KTH-EPE/HVDC_IED/README.md

# HVDC_IED
software and hardware for HVDC IED lab prototype
