KTH-EPE/HVDC_IED/IED_images/power_supply_schematic.pptx

Power
Supply

Green
LED

ADC 1

Switch:
Turn on ADC

ADC 2

DIG OUT
