KTH-EPE/HVDC_IED/IED_images/ADC2_power.jpg

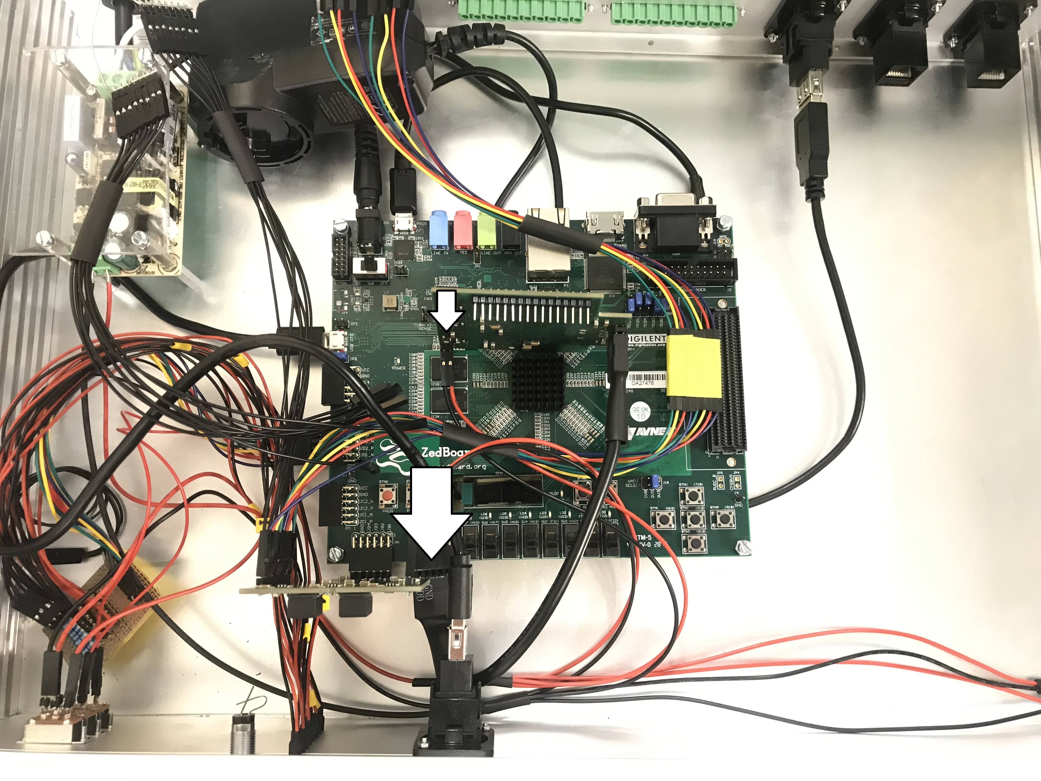
IED_images/ADC2_power.jpg
