KTH-EPE/HVDC_IED/IED_images/ADC_2_wires(1).jpg

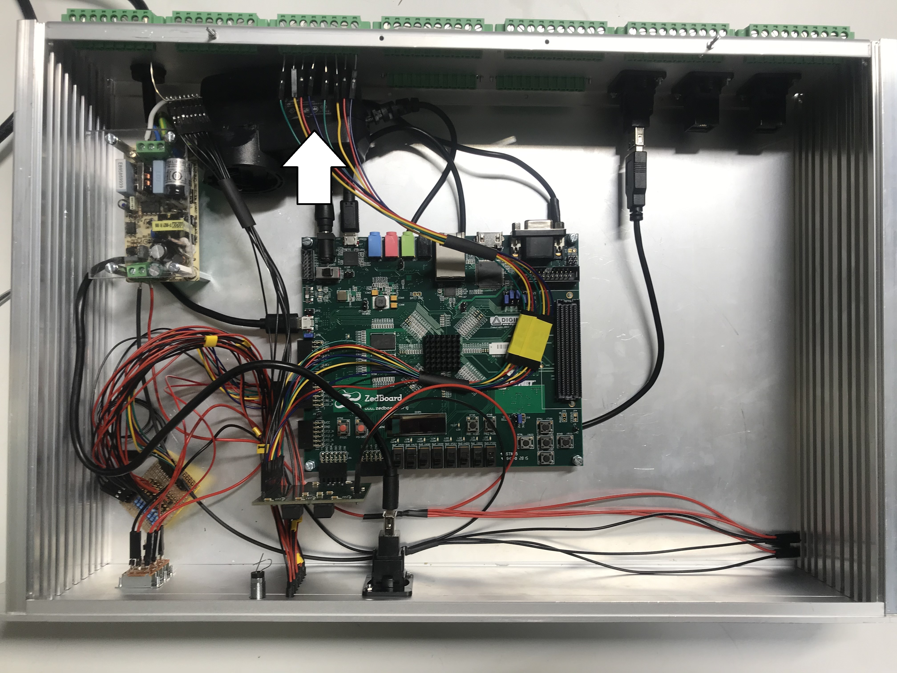
IED_images/ADC_2_wires(1).jpg
