KTH-EPE/HVDC_IED/IED_images/ADC_pins.jpg

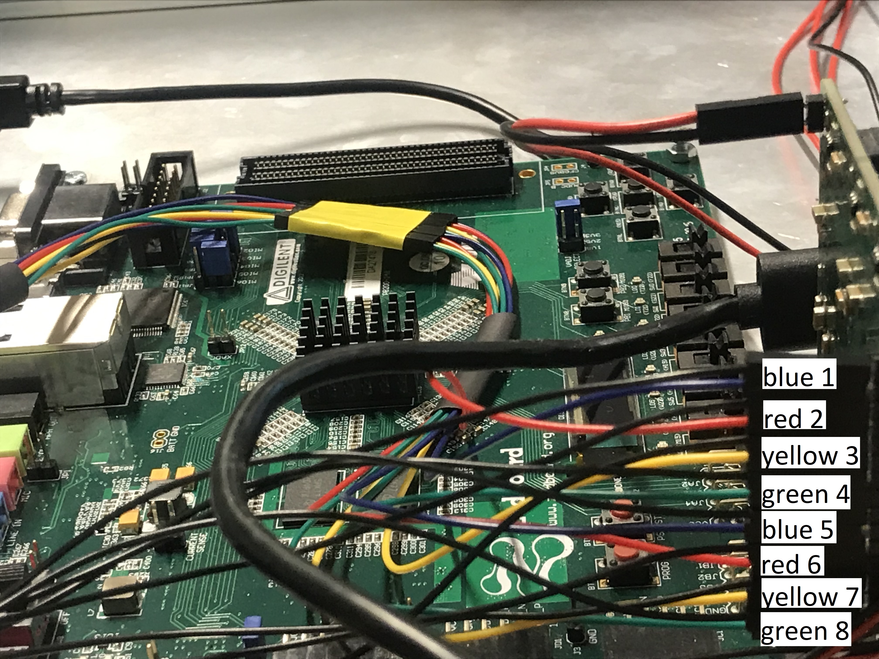
IED_images/ADC_pins.jpg
