KTH-EPE/HVDC_IED/IED_images/DOUT_pins15-28.jpg

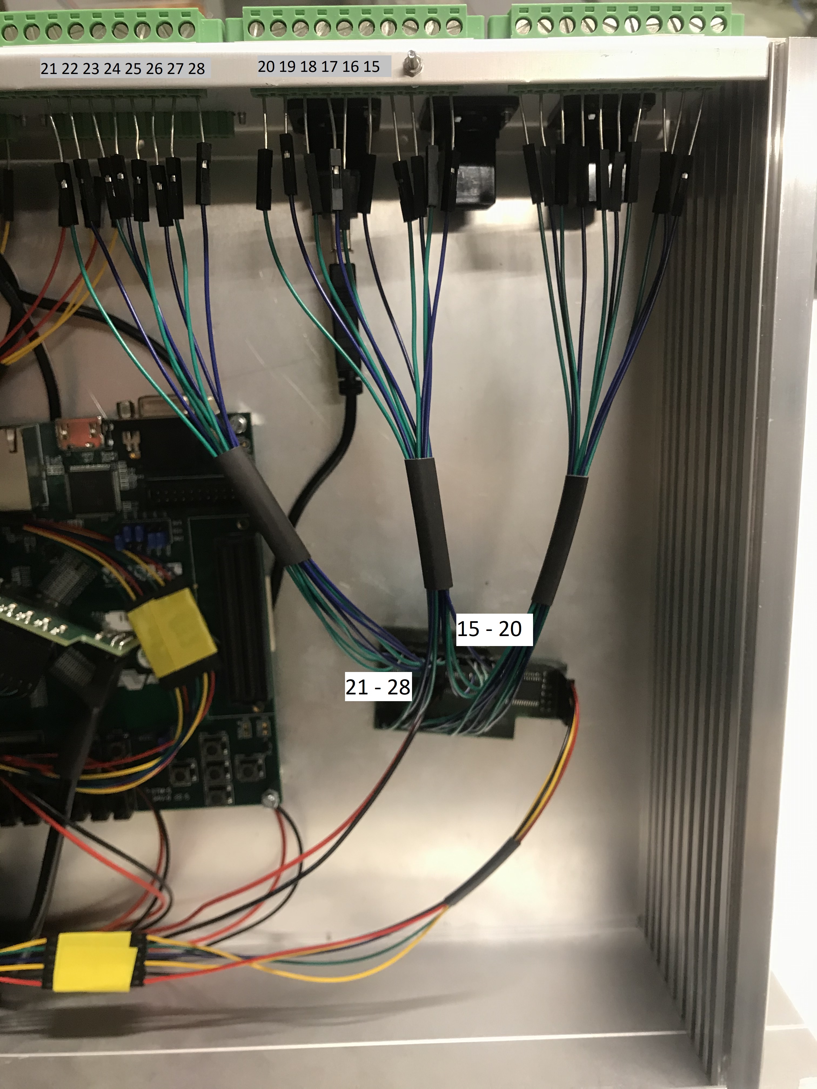
IED_images/DOUT_pins15-28.jpg
