KTH-EPE/HVDC_IED/IED_images/DOUT_supply.jpg

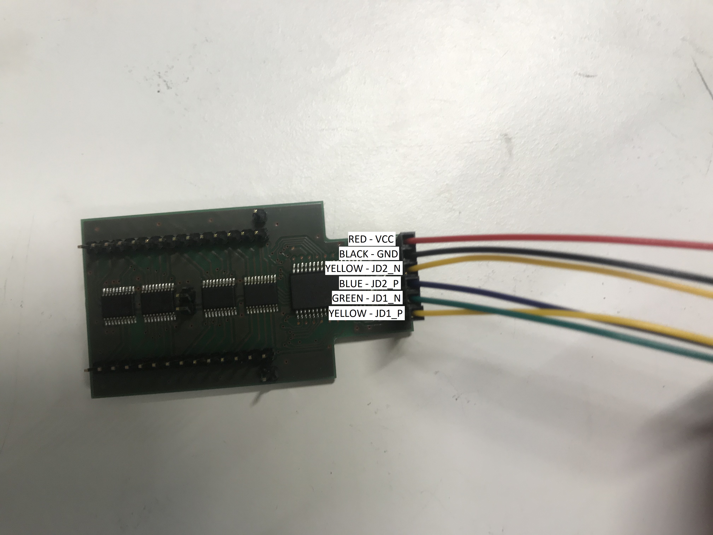
IED_images/DOUT_supply.jpg
