KTH-EPE/HVDC_IED/IED_images/IMG_9938.jpg

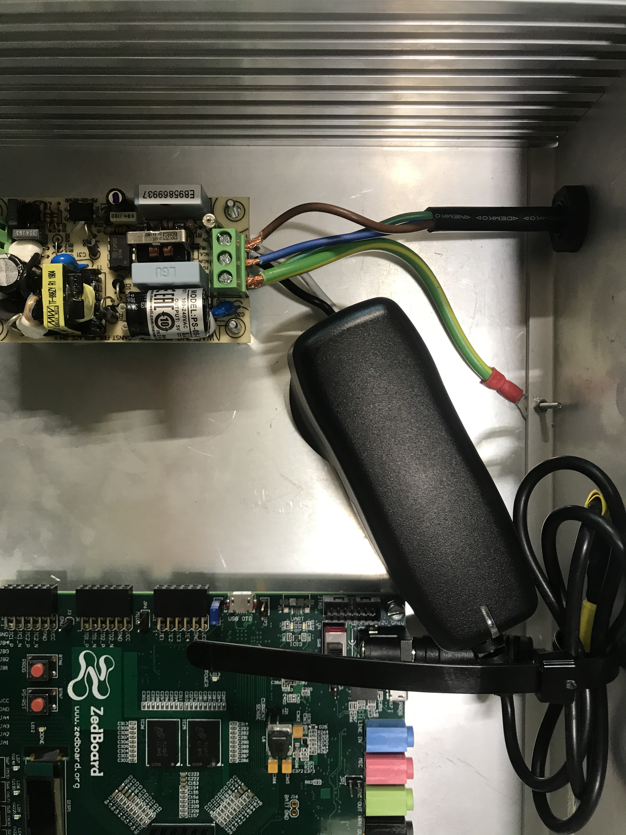
IED_images/IMG_9938.jpg
