KTH-EPE/HVDC_IED/IED_images/LED_GND2.jpg

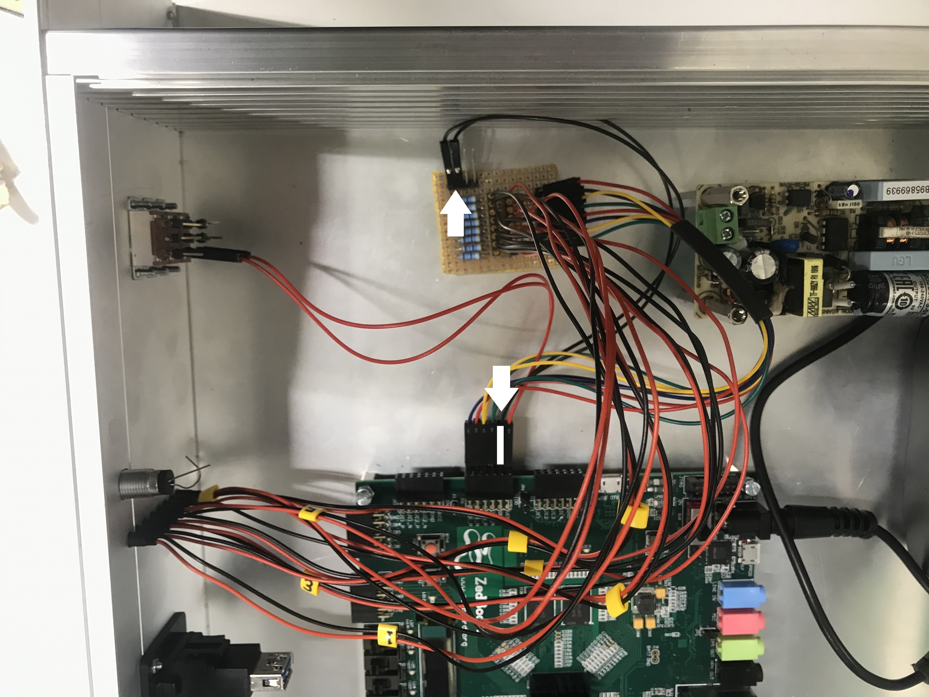
IED_images/LED_GND2.jpg
