KTH-EPE/HVDC_IED/IED_images/LED_GND_idle.jpg

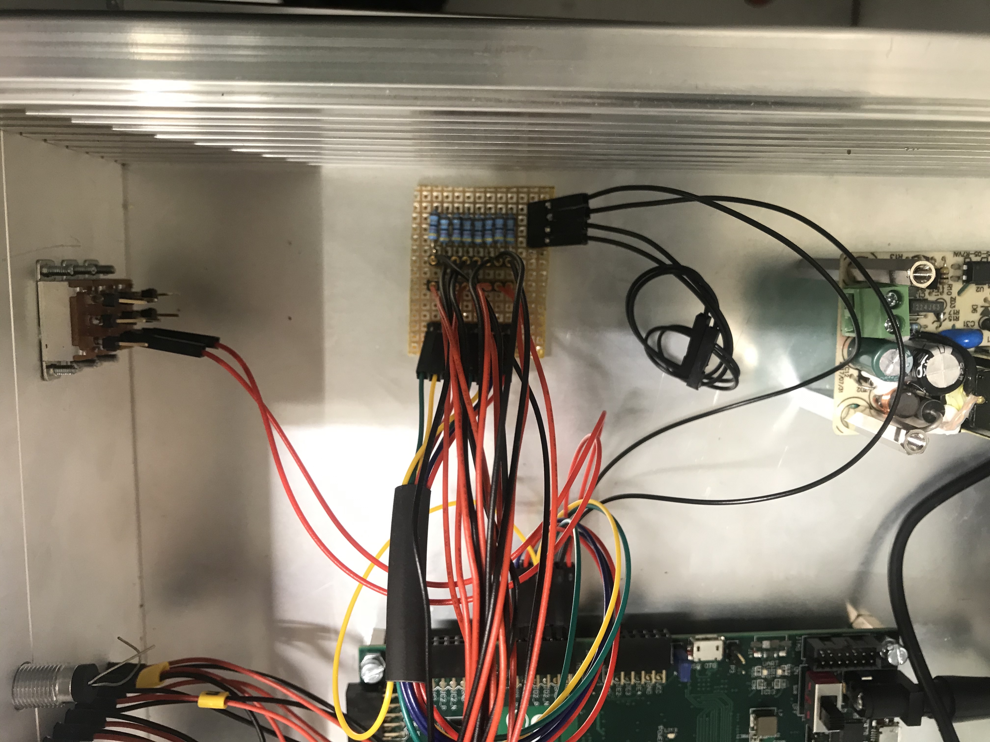
IED_images/LED_GND_idle.jpg
