KTH-EPE/HVDC_IED/IED_images/PMOD_DIN.jpg

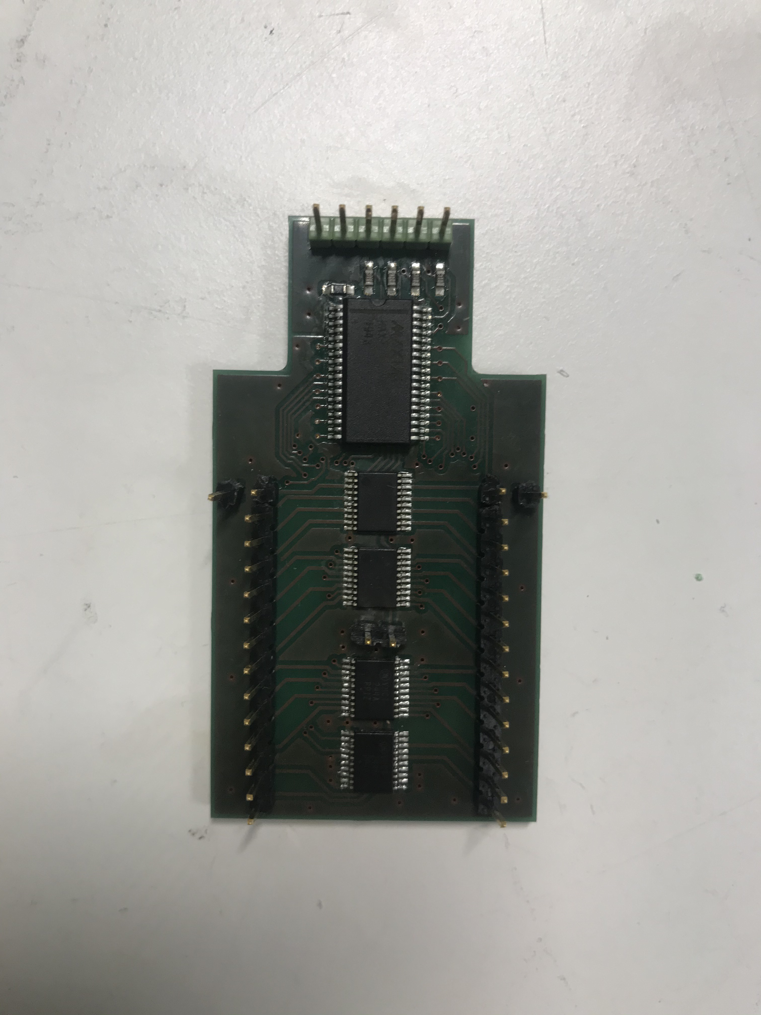
IED_images/PMOD_DIN.jpg
