KTH-EPE/HVDC_IED/IED_images/power_5V_wires_tube.jpg

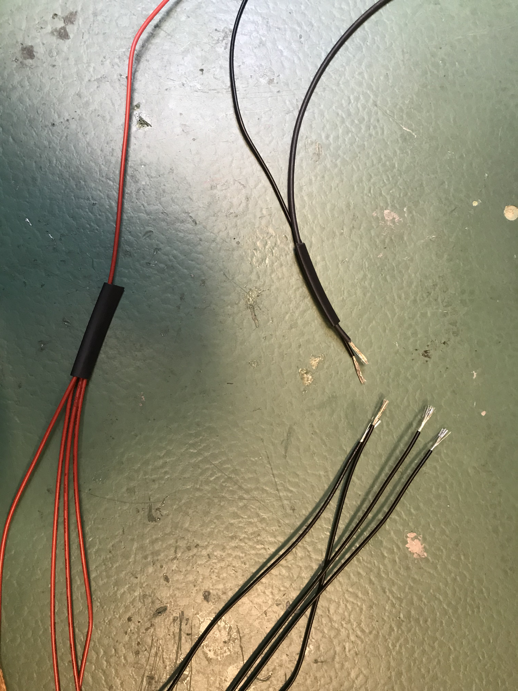
IED_images/power_5V_wires_tube.jpg
