KTH-EPE/HVDC_IED/IED_images/power_supply_earth.jpg

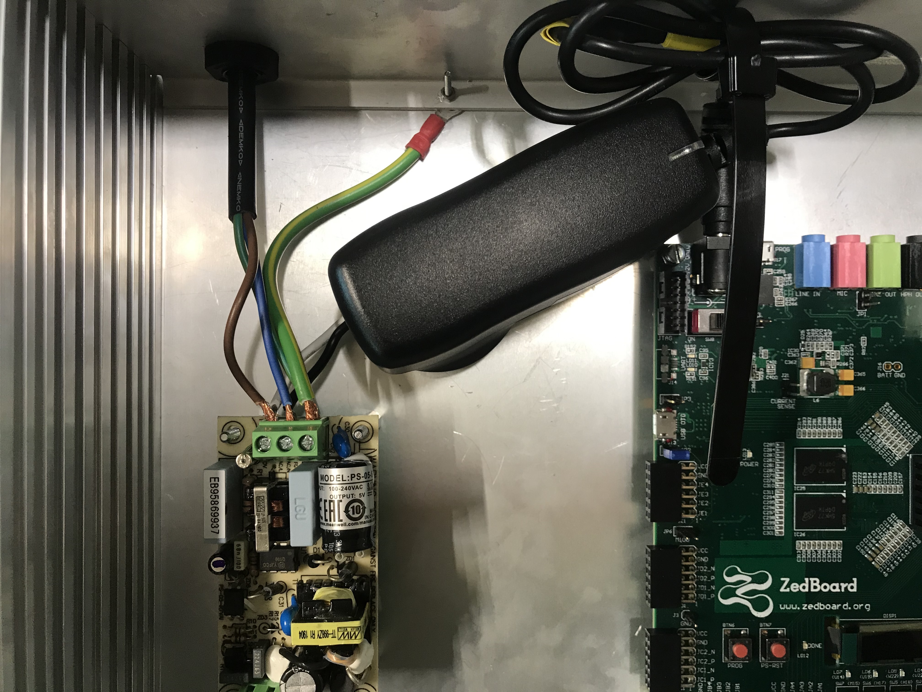
IED_images/power_supply_earth.jpg
