KTH-EPE/HVDC_IED/IED_images/switches_back.jpg

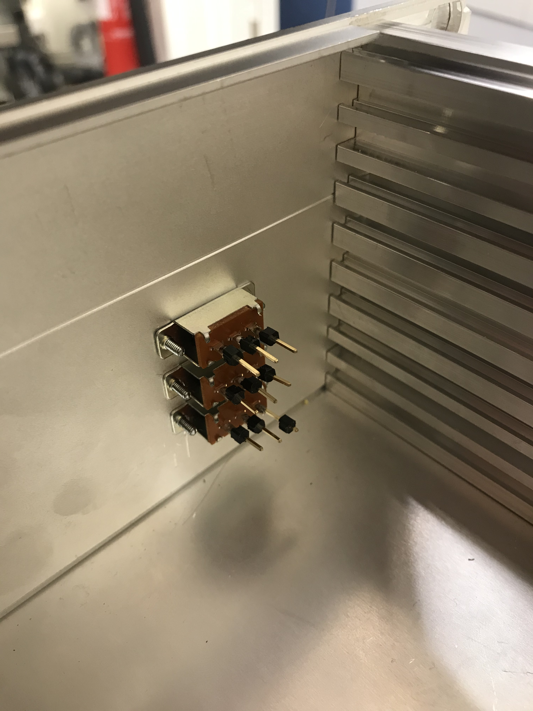
IED_images/switches_back.jpg
