KTH-EPE/HVDC_IED/IED_images/switches_yellow.jpg

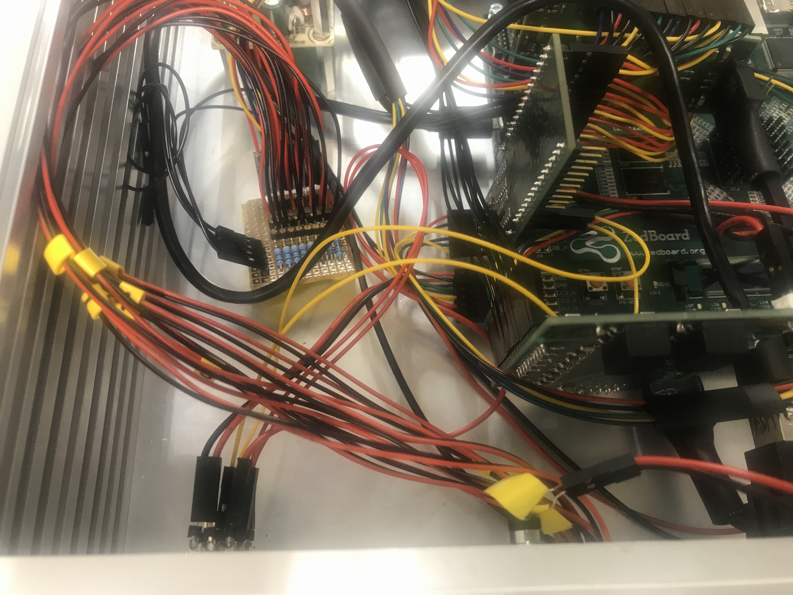
IED_images/switches_yellow.jpg
