KTH-EPE/HVDC_IED/Components.xlsx

Sheet: Overview
Component | Number
Zedboard | 1 | https://store.digilentinc.com/zedboard-zynq-7000-arm-fpga-soc-development-board/
FMC communication module | 1 | https://www.avnet.com/shop/us/products/avnet-engineering-services/aes-fmc-ismnet2-g-3074457345635221626/
Box | 1
GPS PMOD | 1 | https://store.digilentinc.com/pmod-gps-gps-receiver/
PCB (2 ADC,1 DIN, 1 DOUT) | 1 | https://uk.beta-layout.com/pcb/
PCB ADC components | 2
PCB DIN components | 1
PCB DOUT components | 1

Sheet: Box
Component | Number
Rack 19 inch, 2U | 1 | https://www.electrokit.com/produkt/racklada-19-1ux220mm-alu-svart/
Frontpanel | 1 | http://www.frontpanel.se/
red LEDs | 8 | https://www.elfa.se/en/led-indicator-red-vdc-20-ma-marl-354-305-04-40/p/30070833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
slider | 3 | https://www.elfa.se/en/miniature-slide-switch-on-on-23-14-mm-1p-knitter-switch-mfs-131/p/30039941?q=300-39-941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
USB connector | 2 | https://www.elfa.se/en/usb-adapter-in-xlr-housing-usb-cliff-cp30205nm3b/p/30104266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
Ethernet connector | 3 | https://www.elfa.se/en/rj45-panel-mount-adapter-xlr-housing-unshielded-cliff-cp30220m3b/p/30104269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
power cable | 1
green status LED | 1 | https://www.elfa.se/en/led-indicator-green-vossloh-schwabe-wu-g5-5v/p/13370426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
backpanel 8-connector | 3 | https://www.digikey.se/products/en?keywords=1804661
backpanel 10-connector | 6 | https://www.digikey.se/products/en?keywords=1805372
backpanel connection wire 1mm | 1 | https://www.elfa.se/en/hook-up-wire-bare-79-mm-bedra-berkenhof-frt-cu-tr-mm-hg/p/15516232?q=wire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
backpanel connection wire 0.8mm | 1 | https://www.elfa.se/en/hook-up-wire-bare-mm-kabeltronik-00-0108025/p/15550325?q=wire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
Meanwell supply | 1 | https://www.elfa.se/en/switched-mode-power-supply-mean-well-ps-05/p/16994616?q=meanwell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
230V connector for meanwell | 1 | https://www.elfa.se/en/connectors/terminal-blocks/wire-to-board-terminal-blocks/c/cat-DNAV_PL_041112
5V/GND connector for meanwell | 1 | https://www.elfa.se/en/wire-to-board-terminal-block-rnd-connect-rnd-205-00034/p/30042860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
Patch cable | 3 | https://www.elfa.se/en/patch-cable-cat6-ftp-15-red-valueline-vlcp85221r015/p/30099919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
USB cable | 2 | https://www.elfa.se/en/micro-usb-cable-black-maxxtro-bb-8043-02/p/12579336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
Cable gland M12x1.5 Black | 1 | https://www.elfa.se/en/cable-gland-m12-lapp-skintop-st-12x1-ral-9005-bk/p/15519295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
Cable gland lock nut | 1 | https://www.elfa.se/en/lock-nut-m12-lapp-skintop-gmp-gl-12x1-ral-9005-bk/p/15519734
Spacer 1 female 1 male | 4 | https://www.elfa.se/en/spacer-bolt-galvanized-steel-25-mm-mm-bourqui-jean-99133-50250-dss3050x25/p/14801311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
Spacer 2 female | 4 | https://www.elfa.se/en/spacer-bolt-25-mm-mm-no-brand-distin3050m-25/p/11076306?q=hexagonal+threaded+spacer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
5V supply cables | 3 | https://shop.trenz-electronic.de/en/23618-2-pin-MTE-Power-Cable?c=37
50 signal cables | 1 | https://shop.trenz-electronic.de/en/JPCAB-50-50-Jumper-Cables-length-20-cm?c=37
5 gender changer 2x6 | 1 | https://shop.trenz-electronic.de/en/23620-2x-6-pin-12-pin-Header-Gender-Changer-5-pack?c=36
5 gender changer 1x6 | 1 | https://shop.trenz-electronic.de/en/23621-6-pin-Header-Gender-Changer-5-pack?c=36

Sheet: ADC PMOD
Component | Number |  | FOR 1 ADC PMOD
PCB | 1 | https://uk.beta-layout.com/pcb/
ADC | 1 | https://www.digikey.se/products/en?keywords=ADAS3023BCPZ-ND
Traco | 2 | https://www.elfa.se/en/dc-dc-converter-vdc-15-vdc-traco-power-tes-0513/p/16964432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
Delay block TSOT-23-6 | 3 | https://www.elfa.se/en/delay-block-tsot-23-linear-technology-ltc6994is6-pbf/p/11031076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
1*16 pin header male 2.54 pitch | 1 | https://www.elfa.se/en/pin-header-male-16-single-row-straight-without-shroud-wuerth-elektronik-61301611121/p/30024539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
2*6 pin header male 2.54 pitch | 1 | https://www.elfa.se/en/pin-header-male-12-rnd-connect-rnd-205-00637/p/30093657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
1*02 pin header male 2.54 pitch | 1 | https://www.elfa.se/en/pin-header-54-mm-poles-molex-22-23-2021/p/30065095?q=pin+header+male+1x2+pitch+2.54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
2700p 1206 | 8 | https://www.elfa.se/en/capacitor-nf-50-vdc-1206-kemet-c1206c272j5gactu/p/30047698?q=2.7n+1206+capacitance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
10u 1206 | 8 | https://www.elfa.se/sv/kondensator-10-uf-25-vdc-1206-kemet-c1206c106k3pactu/p/30031768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
100n 1206 | 16 | https://www.elfa.se/en/capacitor-100-nf-50-vdc-1206-kemet-c1206c104j5ractu/p/30031761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
100p 1206 | 1 | https://www.elfa.se/en/capacitor-100-pf-50-vdc-1206-kemet-c1206c101j5gactu/p/16572426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
4.7u 1206 | 2 | https://www.elfa.se/en/capacitor-uf-50-vdc-1206-rnd-components-rnd-1501206b475k500n2/p/30086948?q=300-86-948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
10k 0603 | 9 | https://www.elfa.se/en/resistor-smd-10-kohm-0603-arcol-acpp0603-10k-25ppm/p/30047287?q=smd+resistor+0603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
20R 0603 | 1 | https://www.elfa.se/en/smd-resistor-thick-film-20-ohm-0603-panasonic-automotive-industrial-systems-erj3geyj200v/p/30051467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
15k 0603 | 2 | https://www.elfa.se/en/smd-resistor-thick-film-15-kohm-0603-rnd-components-rnd-1550603saj0153t5e/p/30056693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
90R 0603 | 8 | https://www.elfa.se/en/smd-resistor-thick-film-91-ohm-0603-rnd-components-rnd-1550603saf910jt5e/p/30081526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
1M 0603 | 3 | https://www.elfa.se/en/smd-resistor-thick-film-mohm-0603-rnd-components-rnd-1550603saf1004t5e/p/30056459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
100k 0603 | 3 | https://www.elfa.se/en/smd-resistor-metal-film-resistor-100-kohm-0603-welwyn-pcf0603r-100kbt1/p/11052446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
820k 0603 | 0 | https://www.elfa.se/en/smd-resistor-thick-film-820-kohm-0603-rnd-components-rnd-1550603saf8203t5e/p/30056670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
200k 0603 | 1 | https://www.elfa.se/en/smd-resistor-thick-film-200-kohm-0603-rnd-components-rnd-1550603saf2003t5e/p/30056523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
680k 0603 | 3 | https://www.elfa.se/en/smd-resistor-thick-film-680-kohm-0603-rnd-components-rnd-1550603saf6803t5e/p/30056652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
374k 0603 | 1 | https://www.elfa.se/en/smd-resistor-thick-film-374-kohm-0603-rnd-components-rnd-1550603saf3743t5e/p/30056587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
560k 0603 | 1 | https://www.elfa.se/en/smd-resistor-thick-film-560-kohm-0603-rnd-components-rnd-1550603saf5603t5e/p/30056634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

Sheet: DIGIN PMOD
Component | Number
PCB | 1 | https://uk.beta-layout.com/pcb/
MAX7301AAX+ | 1 | https://www.mouser.se/ProductDetail/Maxim-Integrated/MAX7301AAX%2b
MC74LVX244DTG | 4 | https://www.mouser.se/ProductDetail/ON-Semiconductor/MC74LVX244DTG
1*6 pin header male 2.54 pitch | 1 | https://www.elfa.se/en/straight-pin-header-male-te-connectivity-826629/p/14371647?q=pin+header+male+2.54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
39k 0603 | 1 | https://www.elfa.se/en/smd-resistor-thick-film-39-kohm-0603-vishay-crcw060339k0fkea/p/16059743?q=160-59-743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
10k 0603 | 32 | https://www.elfa.se/en/resistor-smd-10-kohm-0603-arcol-acpp0603-10k-25ppm/p/30047287?q=smd+resistor+0603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
1u 1206 | 1 | https://www.elfa.se/en/capacitor-uf-50-vdc-1206-rnd-components-rnd-1501206f105z500/p/30066055?q=300-66-055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
47n 1206 | 1 | https://www.elfa.se/en/capacitor-47-nf-50-vdc-1206-rnd-components-rnd-1501206b473k500nt/p/30086941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
1k 0603 | 28 | https://www.mouser.se/ProductDetail/koa-speer/sg73g1jttd1001d/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

Sheet: DIGOUT PMOD
Component | Number
PCB | 1 | https://uk.beta-layout.com/pcb/
MAX7301AAX+ | 1 | https://www.mouser.se/ProductDetail/Maxim-Integrated/MAX7301AAX%2b
MC74VHCT244ADTRG | 4 | https://www.mouser.se/ProductDetail/ON-Semiconductor/MC74VHCT244ADTRG
1*6 pin header male 2.54 pitch | 1 | https://www.elfa.se/en/straight-pin-header-male-te-connectivity-826629/p/14371647?q=pin+header+male+2.54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
1*02 pin header male 2.54 pitch | 1 | https://www.elfa.se/en/pin-header-54-mm-poles-molex-22-23-2021/p/30065095?q=pin+header+male+1x2+pitch+2.54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
39k 0603 | 1 | https://www.elfa.se/en/smd-resistor-thick-film-39-kohm-0603-vishay-crcw060339k0fkea/p/16059743?q=160-59-743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
10k 0603 | 32 | https://www.elfa.se/en/resistor-smd-10-kohm-0603-arcol-acpp0603-10k-25ppm/p/30047287?q=smd+resistor+0603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
1u 1206 | 1 | https://www.elfa.se/en/capacitor-uf-50-vdc-1206-rnd-components-rnd-1501206f105z500/p/30066055?q=300-66-055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
47n 1206 | 1 | https://www.elfa.se/en/capacitor-47-nf-50-vdc-1206-rnd-components-rnd-1501206b473k500nt/p/30086941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

Sheet: Other
Component | Number
resistor
