KTH-EPE/HVDC_IED/IED_images/ADC2_pins_order.jpg

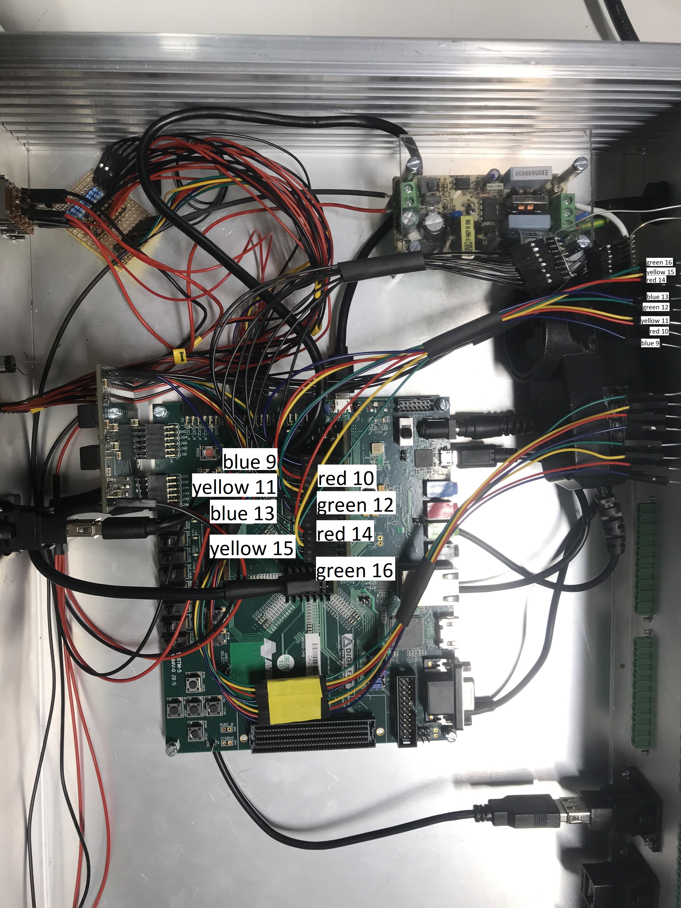
IED_images/ADC2_pins_order.jpg
