KTH-EPE/HVDC_IED/IED_manual.md

                                                                                                                                                                                                                                   

# IED building manual

This manual shows how to build a laboratory protection intelligent electronic device (IED) compatible with common real-time digital simulators and studies for high-voltage direct-current (HVDC) grids. The device was built as part of the PROMOTioN research project, which aims to develop meshed HVDC offshore grids on the basis of cost-effective and reliable technological innovation. In the picture below you can see the finalized look of the relay. 


## Initial set up 
The building process starts with assembling the physical box, which is going to contain the prototype. 

Before assembling the parts together, it is important to position the components on the bottom panel and drill the holes for mounting the Zedboard, FMC and a power supply. 

Drill the holes in respective locations. For mounting the board and the power supply, holes need to be 3 mm in diameter. 2 holes for FMC should be 2 mm. 

After the holes are done, screw the boards to the bottom panel. Take the top screws out of the 4 couplings of the Zedboard and screw them into the panel from the bottom. 


On top of the screws attach the coupling nuts.

Put long 2 mm screws into the 2 smaller holes and fixate ones with nuts to attach the FMC board in the future.
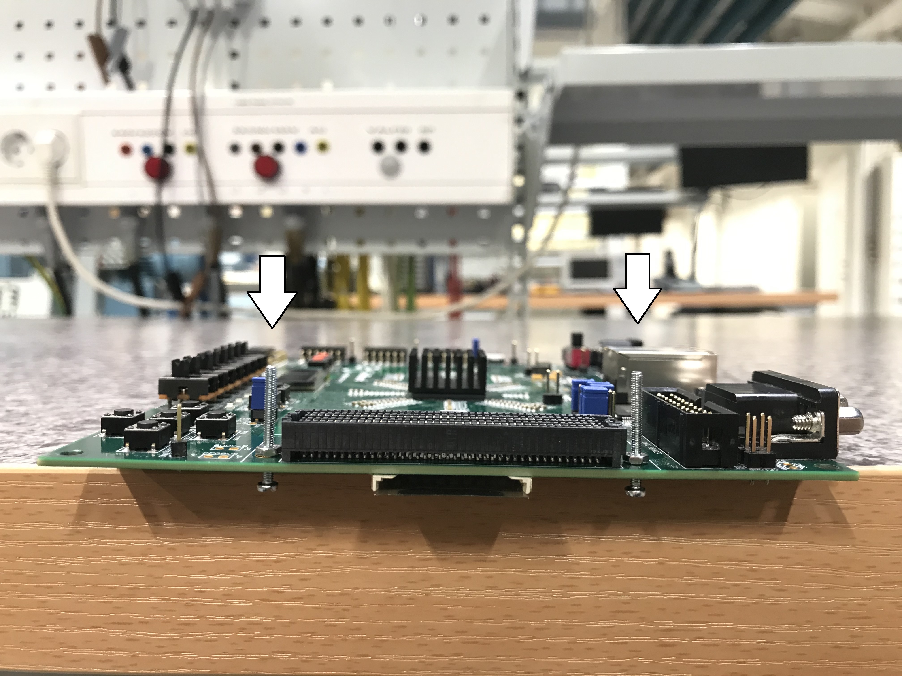
[picture p17: IED_images/FMC_screws(1).jpg]


Proceed to mounting the Zedboard using 3 mm screws and nuts.


Screw in 3 mm screws from the bottom of the panel into the holes drilled earlier. Put the female-to-male spacers onto them. 

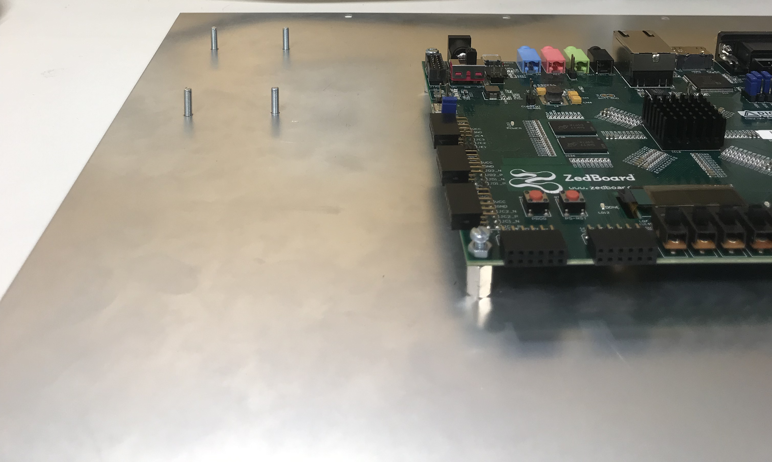
[picture p18: IED_images/screws_power(1).png]



## Power supply module



To connect the switched-mode power supply we will need to install wire-to-board terminal blocks. First, remove the white terminal blocks in place with some help of pliers and a soldering machine. 



Solder the terminal blocks in the same position as the removed terminal blocks.



The power supply is plugged in the socket with a power cable. Cut the cable and remove the insulation, there has to be 3 wires: positive, negative and ground.



The switched-mode supply feeds power at 5 V voltage to the board. We connect the zedboard using the standard power adapter provided in the board kit. We need to connect the power cable directly to the wires in the power adapter. To do that cut a window in the plastic shell of the adapter.

The default charger wire would be too long, so it is also advisable to shorten it, i.e. cut the middle, remove the insulation on the ends and solder them together.

Before soldering the wires make sure there are shrink tubes of two sizes for both conductor and drain wires. The shrink tubes will provide insulation between core, drain wire and the environment. 



The charger is shortened.

The 230V side of the adaptor will connect these cables, which we have prepared bare ends of.


## Box and power supply setup
Put the sticker on the front panel. The best way to do it is fixating the sticker with a duct tape and removing the backing paper gradually. 

Construct the rack enclosure, putting the parts together with screws included in the kit

Put the power cable through a cable gland on the outside the box and a lock nut from the inside. Fixate the power cable at the back panel.

Connect the positive, negative and ground inner cables to the respective terminals.

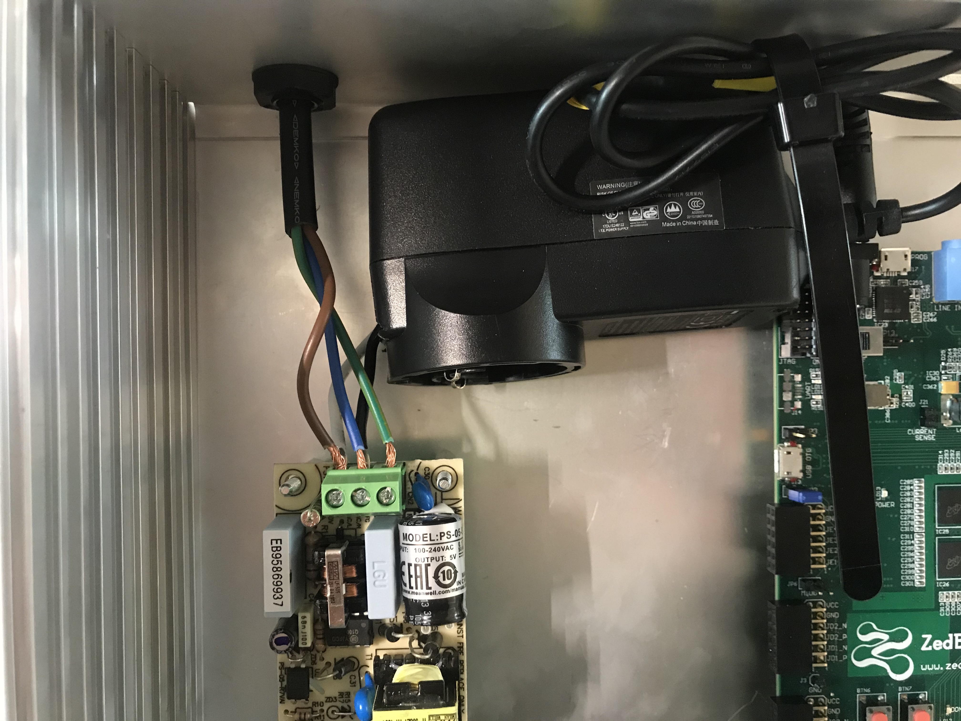
[picture p19: IED_images/power_supply_wires(1).jpg]


We add an extra earth cable bind connected to the metal case of an appliance. Here, we used a crimper to connect the ring to the cable.

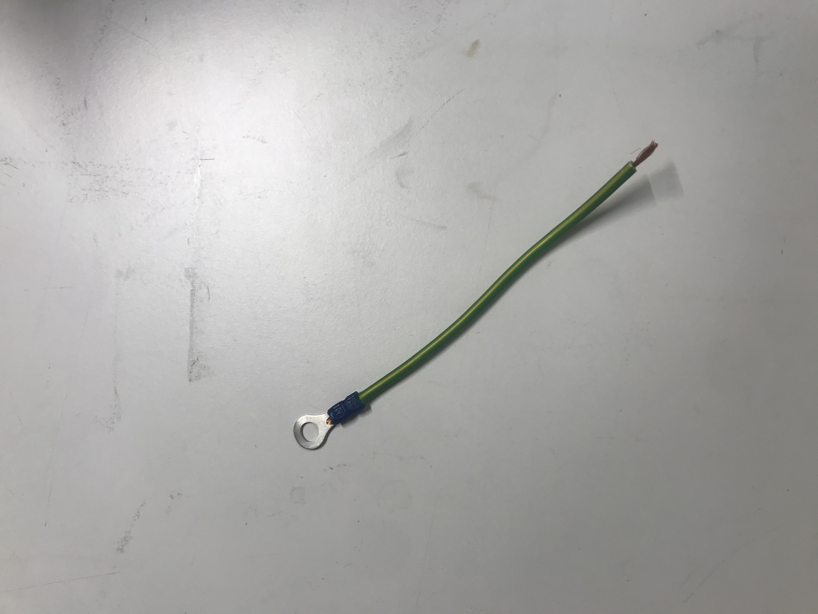
[picture p20: IED_images/earth_ring_cable.jpg]




The ring is kept in place with a bolt and screw to the bottom edge of the box. 

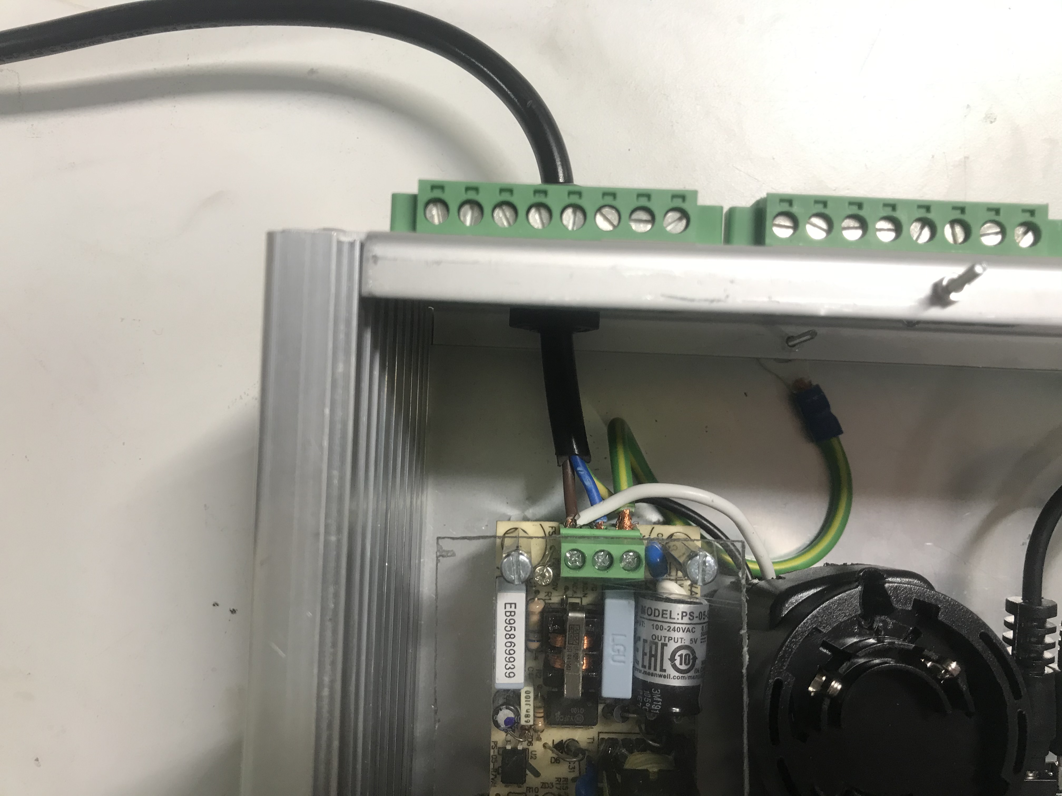
[picture p21: IED_images/earth_ring.jpg]


Mount the USB and ethernet connectors, 8 and 10 pin connectors on the back panel. Put the labels to the corresponding ports. 



Attach the USB connector and LED lights to the front panel.



A larger green LED is screwed to the panel from the inside of the box.

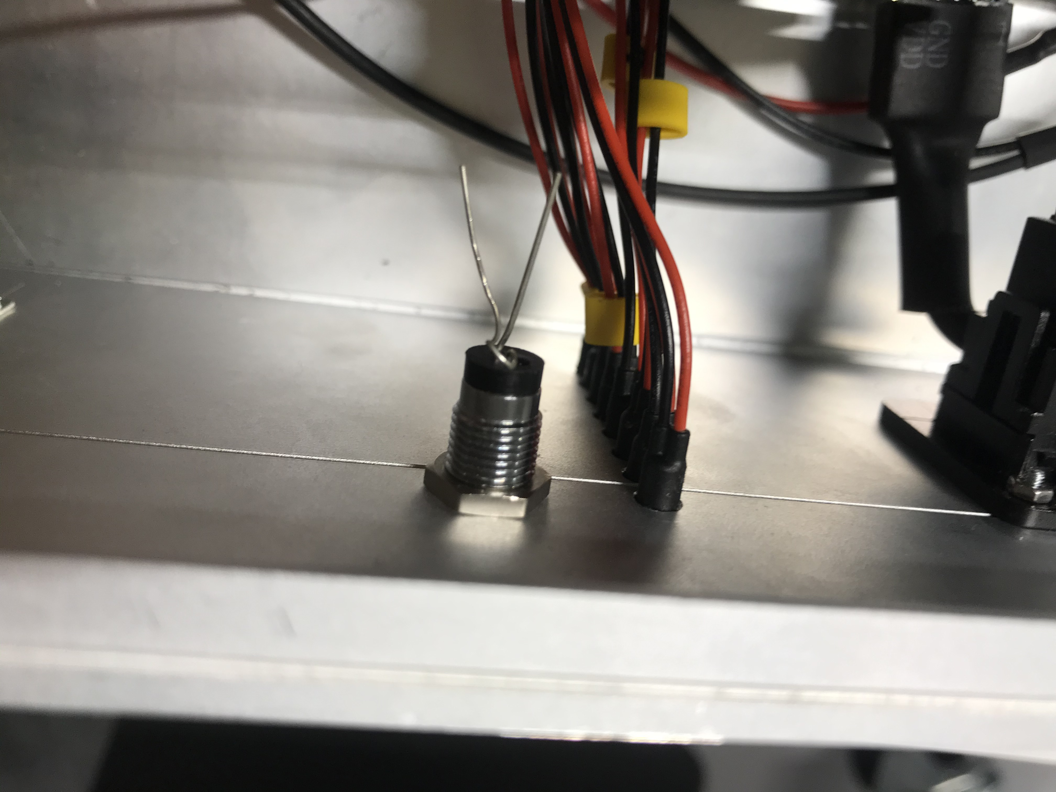
[picture p22: IED_images/LED_main_nut.jpg]


The power supply module is covered with a shield cut from Plexiglas for safety. The shield is attached with 4 machine screws into female spacers. 

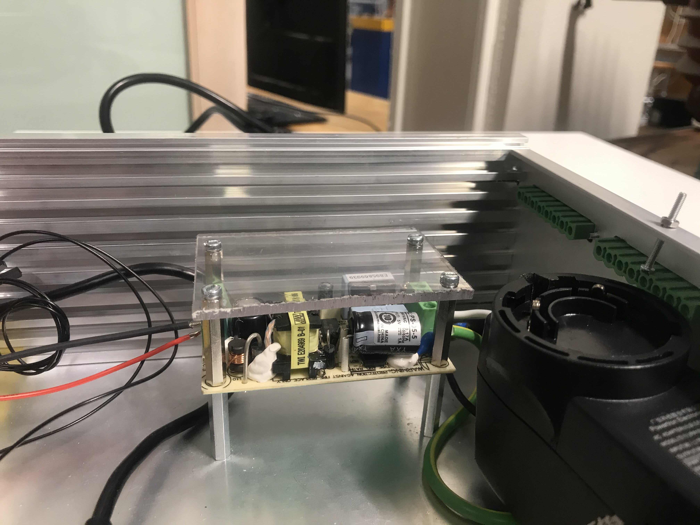
[picture p23: IED_images/power_supply_shield.jpg]


## Led Connector

We need to make an LED connector board to link the Zedboard with the frontpanel LEDs. See the schematic and breadboard view.

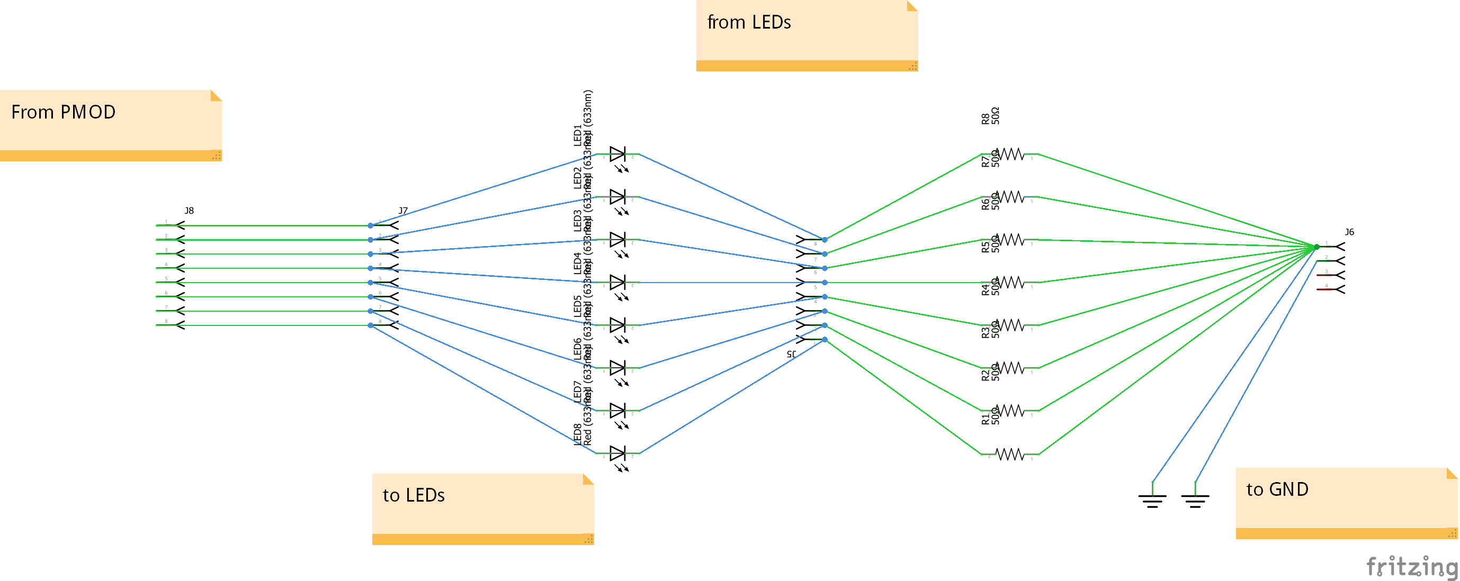
[picture p24: IED_images/LED_connector_schem.png]


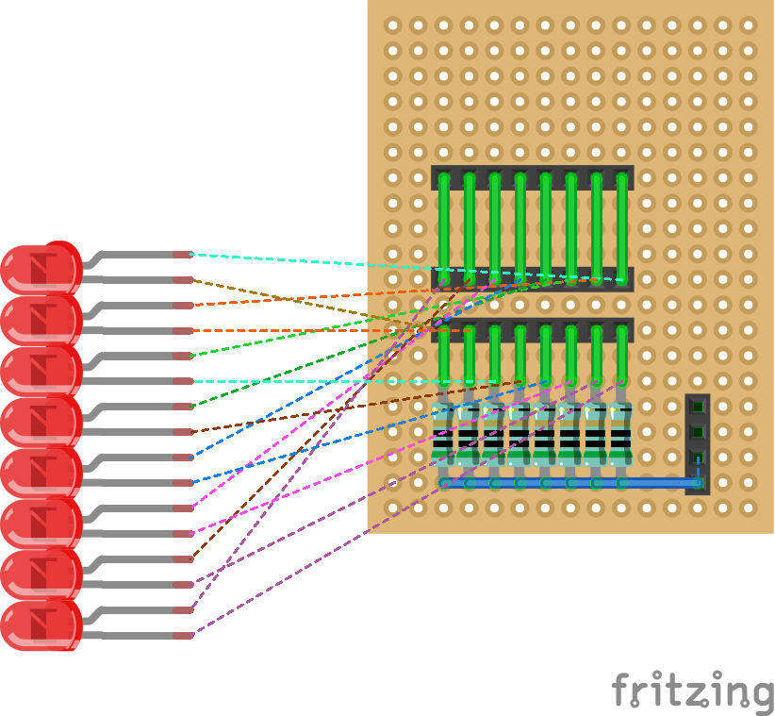
[picture p25: IED_images/LED_connector_bb.png]


The connector incorporates a blank pcb board, eight 50 Ohm resistors, two sets of pin headers and two sets of pin sockets. 


The rightmost pins and sockets on the picture are connected with bits of metallic wire. 

It is convenient to solder the resistor legs to the sockets on one side and to the ground on the other side 

Once connector is finalized, we can start connecting the LEDs.



Connect the 8 long pins to the connector on the board. The left-most wire (red) connect to JC1_N. Next one links to JC1_P. Third pin links to JC2_N. Fourth pin links to JC2_P. Next four reiterate in the same arrangement. 


We will only need two of the ground pins, which we connect to the GND terminal pins at the PMOD port.



Some of the pins may be left idle. Here we connect some idle wires for safety. 



## Switches

Solder pin headers (6 mm - 3.1 mm) to the switches. Bend the shorter end pins to fit into the terminals of the switches. 

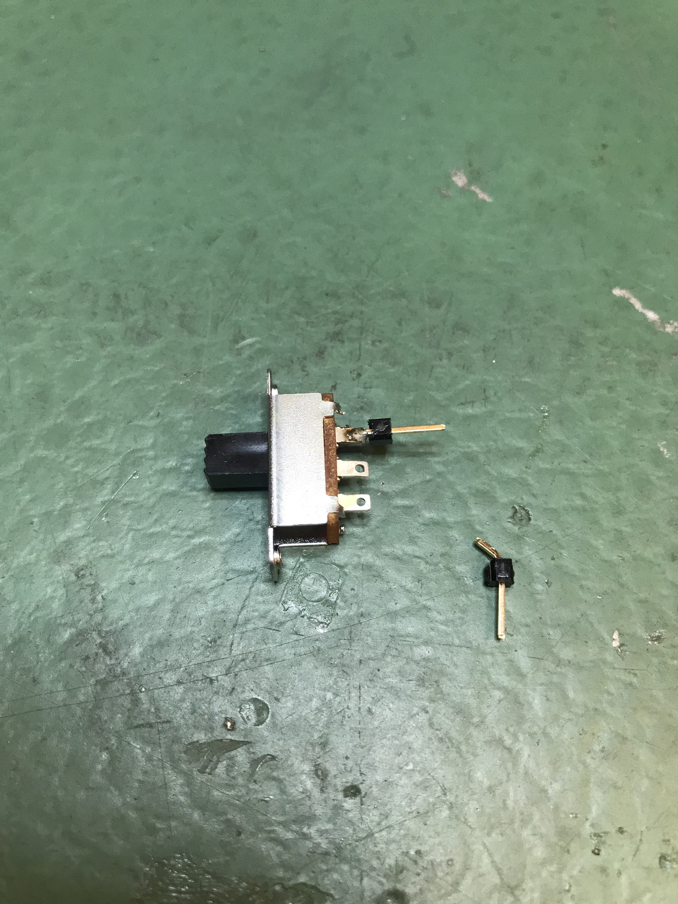
[picture p26: IED_images/switch_1.jpg]


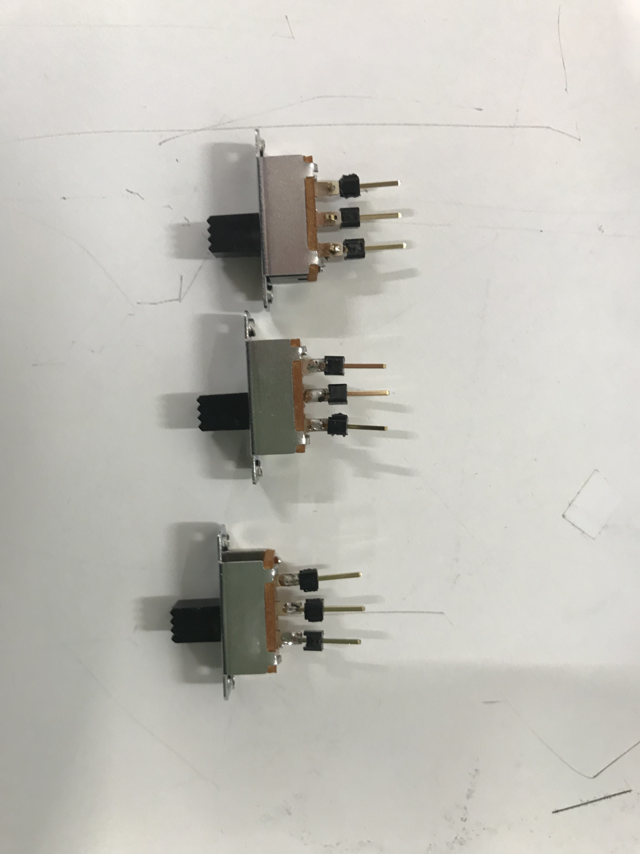
[picture p27: IED_images/switch_2.jpg]


Plug the switches onto the front panel and attach them with screws. 



The right terminals are connected to the UCC (3.3 V) port in one of the PMOD ports.

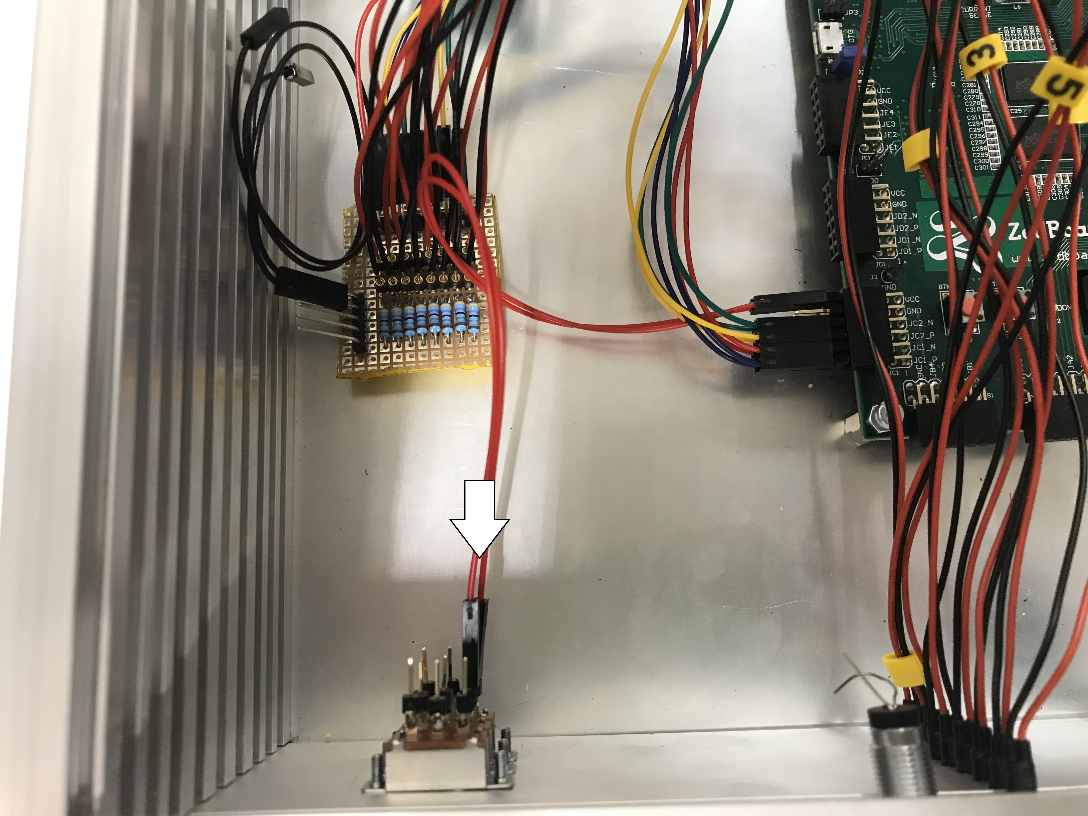
[picture p28: IED_images/switches_ucc2.jpg]


## Power supply wiring 

To connect the devices on the 5V side we will solder multiple wires jointly in the following arrangement. Strip the MTE cables on the "input" and "output" bundles. Before soldering you can intertwine the stranded wires or wrap the bundle with a separate strand. 

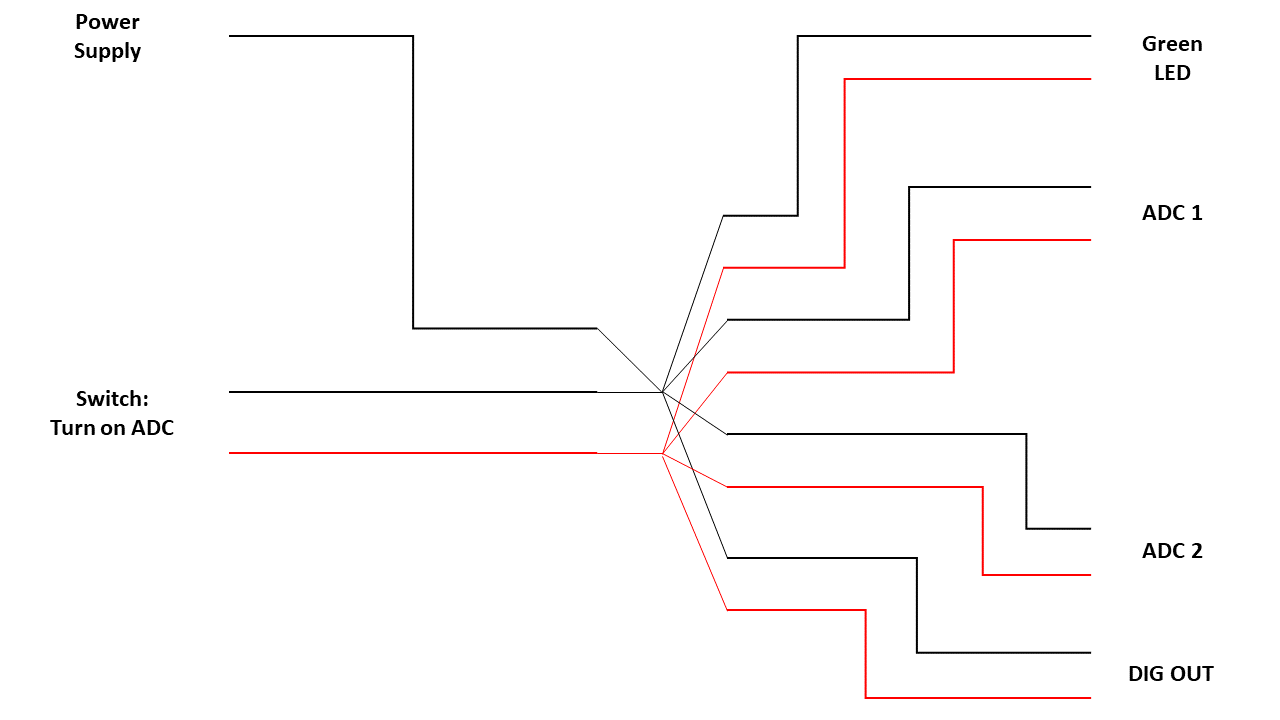
[picture p29: IED_images/power_supply_schematic.png]




Keep in mind to keep the shrink tubes or some other type of insulation over the joints. Proceed to soldering.  

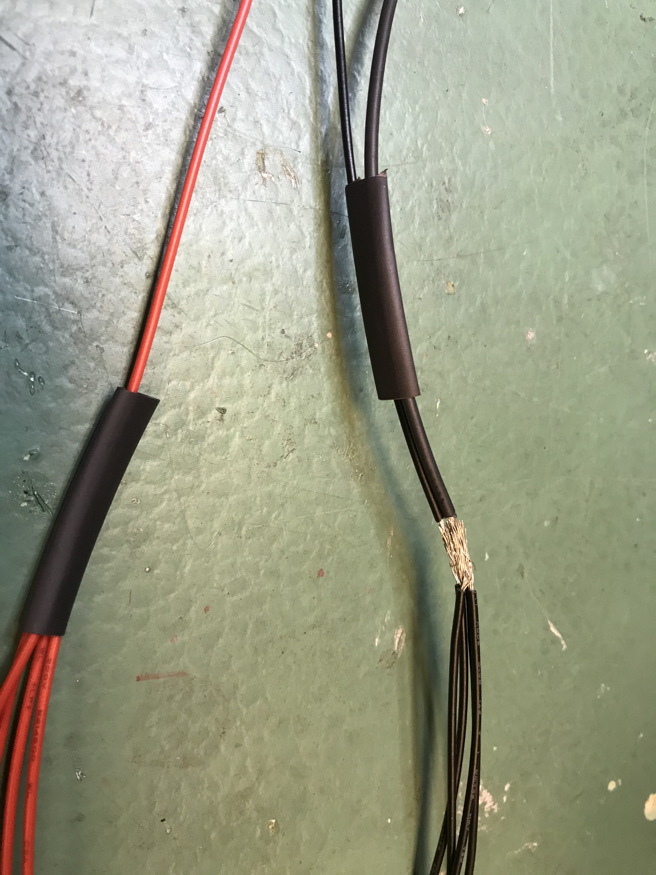
[picture p30: IED_images/power_5V_wires_tube2.jpg]


For setting the power supply you will need the new-made distribution joint plus an additional wire for the positive terminal. Here we used an MTE cable stripped on one end.

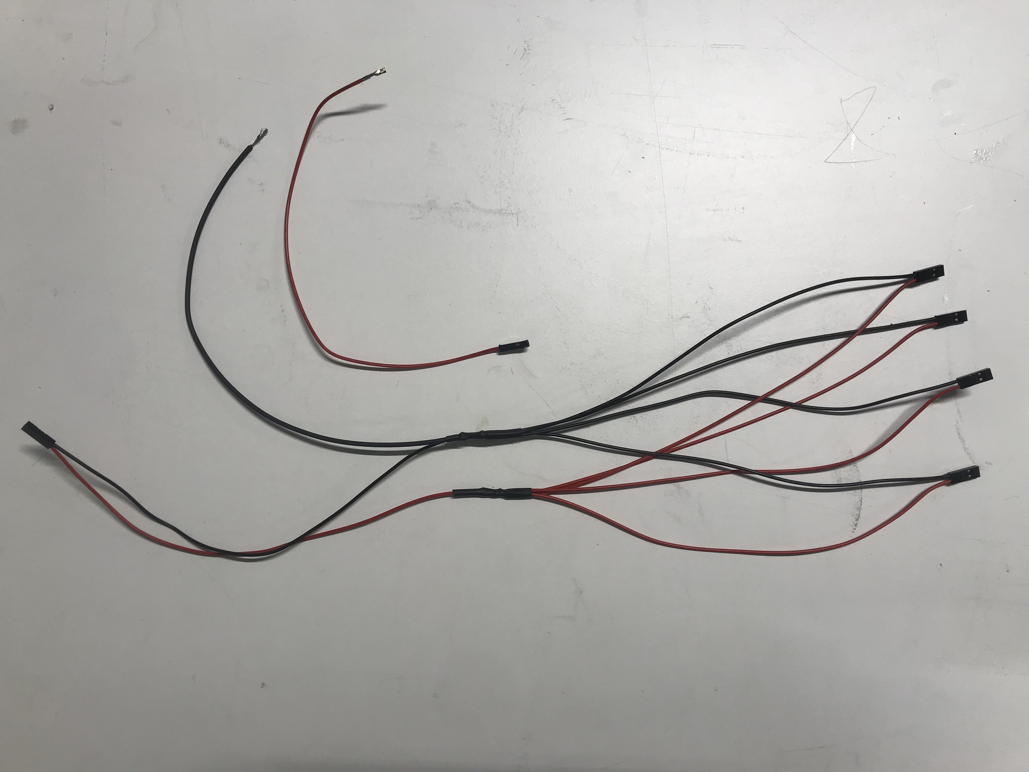
[picture p31: IED_images/power_5V_wires_red3.jpg]


Connect the wires to the power supply side.

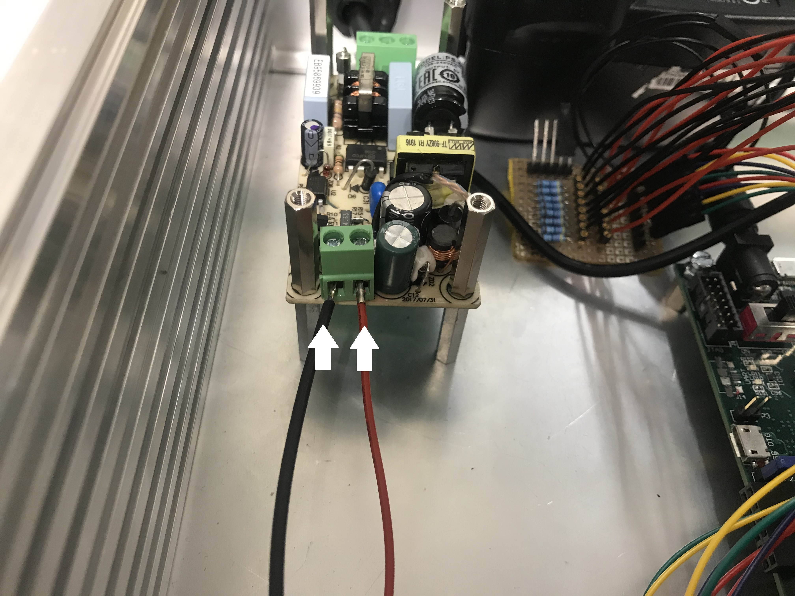
[picture p32: IED_images/power_5V_wires_input2.jpg]


Connect the other end to the pins on the top switch.

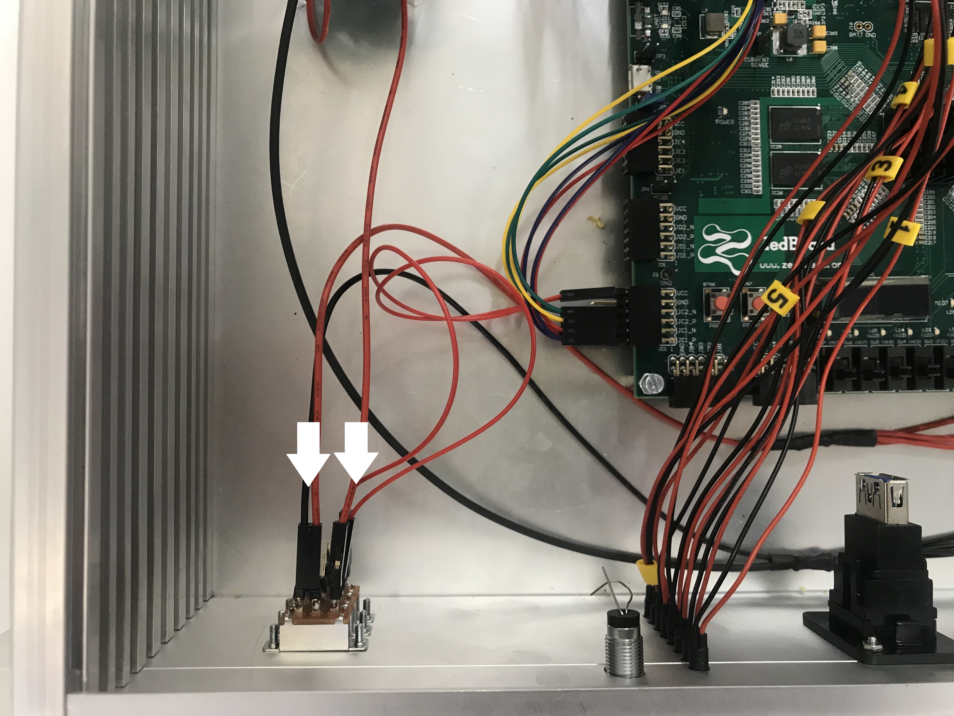
[picture p33: IED_images/power_5V_wires_output.jpg]


Connect the power supply to strands on the big LED. Spare the terminals with some insulating tape. 

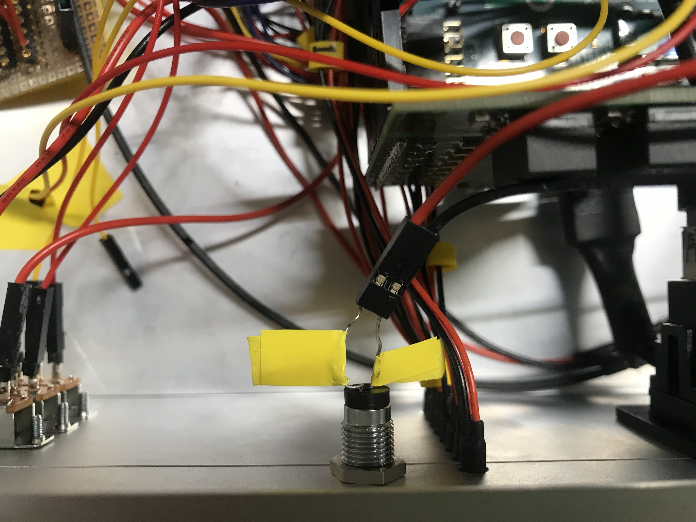
[picture p34: IED_images/LED_power.jpg]


## USB peripherals

Use micro USB to USB cables to connect the outside ports to nests on the board. The USB connector at the front is used for data output and setting configuration. It is connected via the UART terminal at the board. The USB peripheral at the back is used for programming the device and connects at the terminal next to the terminal for power supply. 

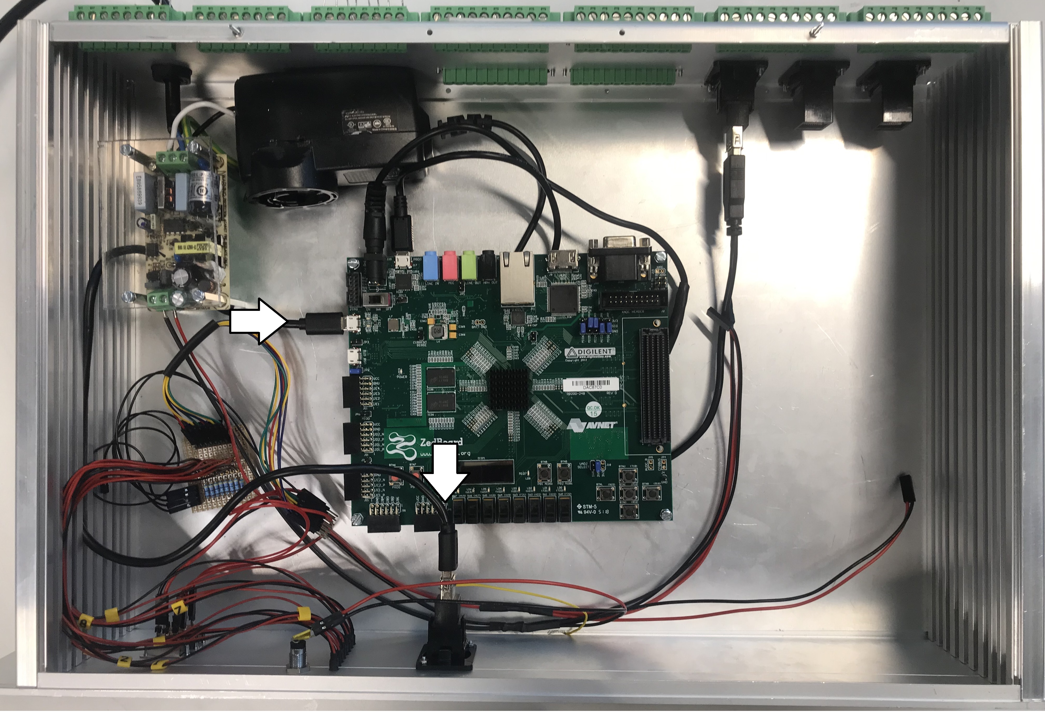
[picture p35: IED_images/usb1_fixed_edited(1).jpg]


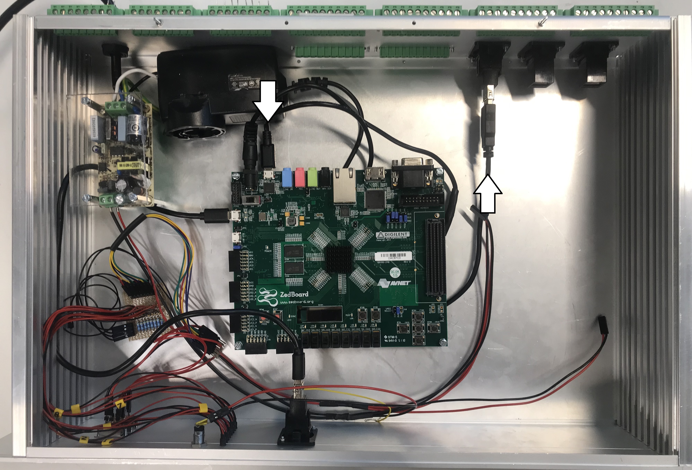
[picture p36: IED_images/usb2_fixed_edited.jpg]


## PMOD ADC 

The set up is extended with a peripheral module (PMOD) Analog to Digital Converters (ADCs) connected via  headers on the zedboard. 

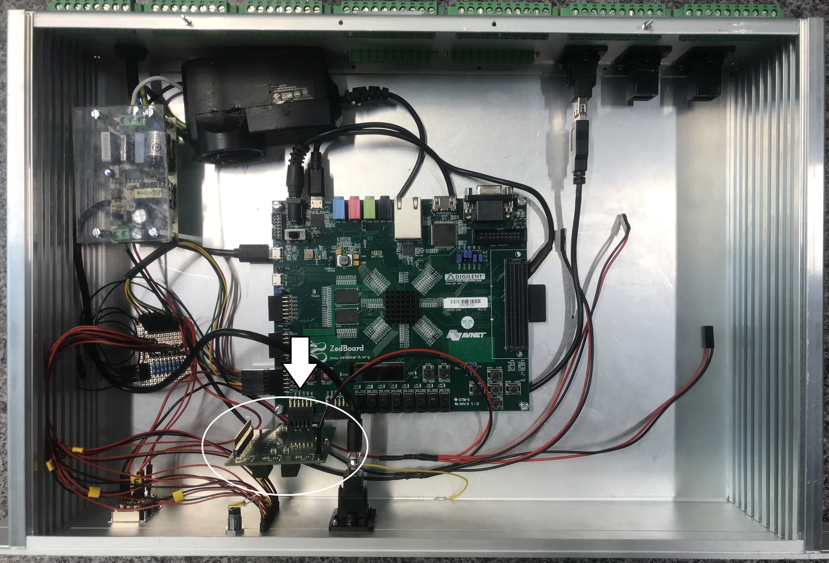
[picture p37: IED_images/ADC_placement(2).jpg]


The module is supplied power from the power supply module with an MTE 2-pin cable.

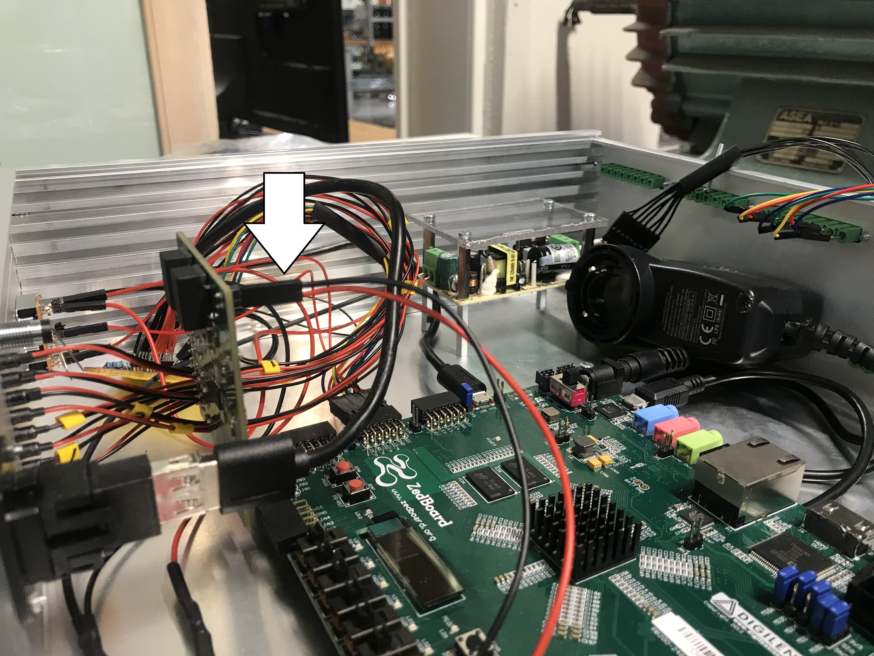
[picture p38: IED_images/ADC_power.jpg]


Prepare 8 ground wires together in a pin header. 

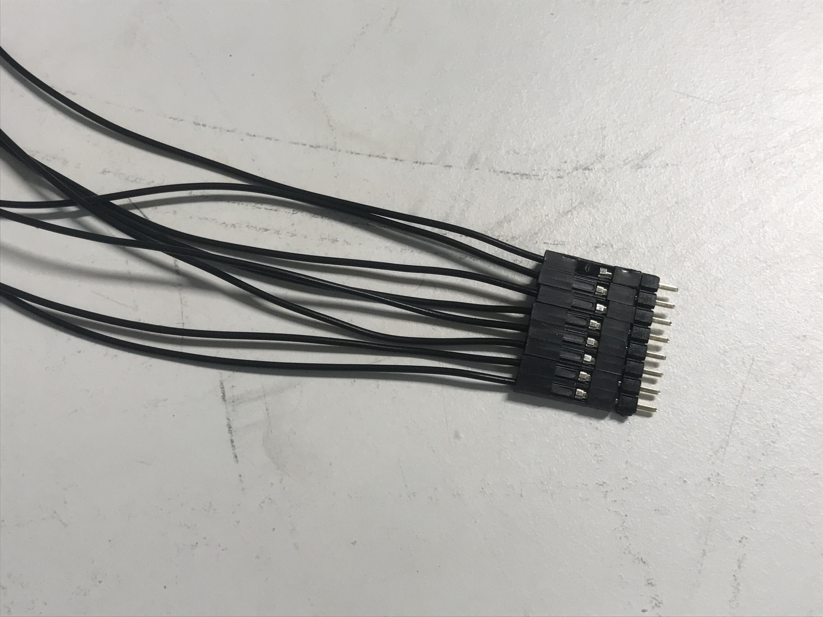
[picture p39: IED_images/ground_pins.jpg]


Solder the pins to a metal wire in order to route them into IED's GND interface pin.

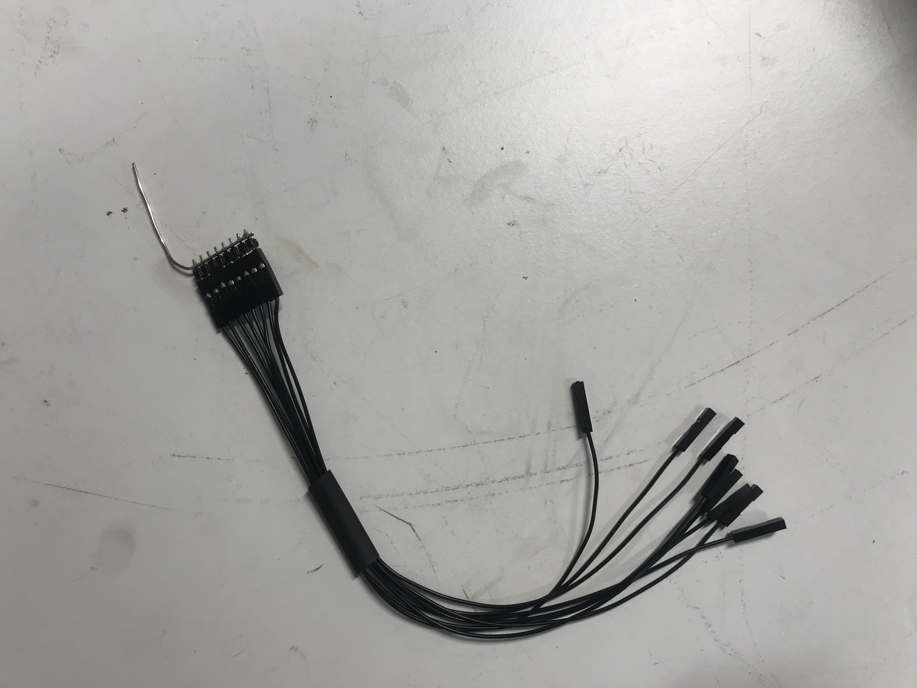
[picture p40: IED_images/ground_pins_wire.jpg]


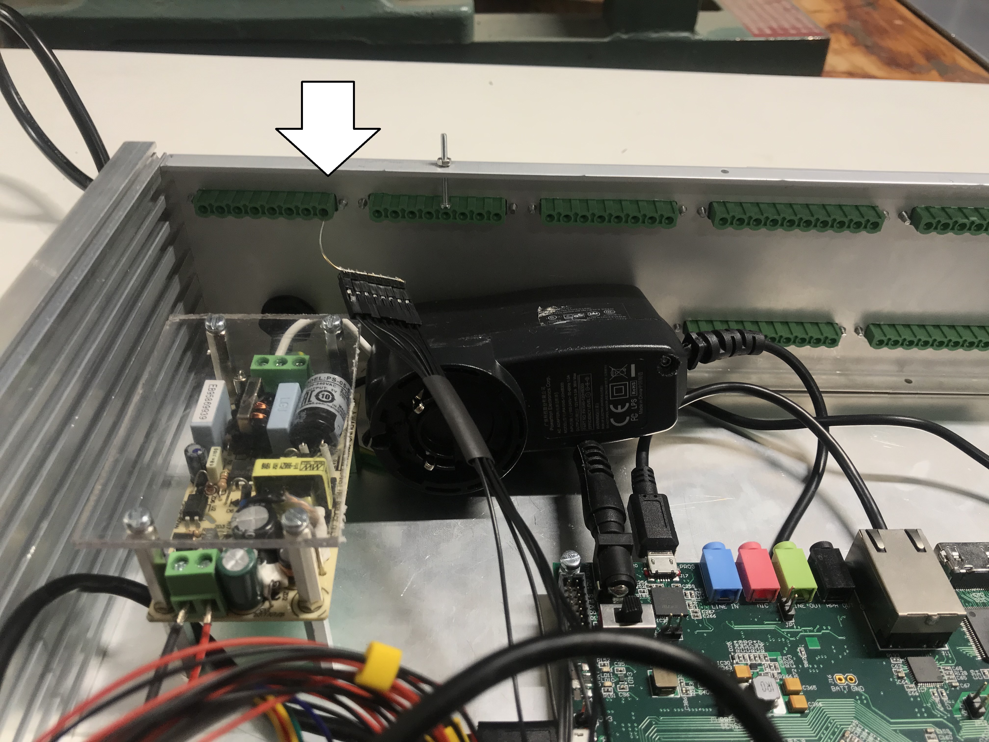
[picture p41: IED_images/ground_pins_wire_port.jpg]


 The ADC module interfaces with IED's 3.3 V logical pins on the back of the box. 

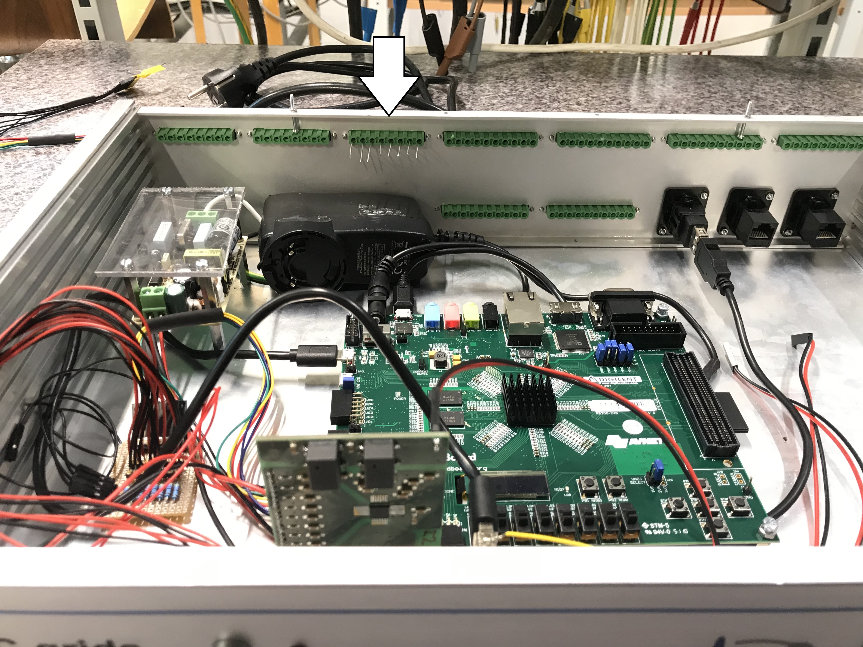
[picture p42: IED_images/ADC1_ports_wire.jpg]


The wires are plugged onto metal wire pieces

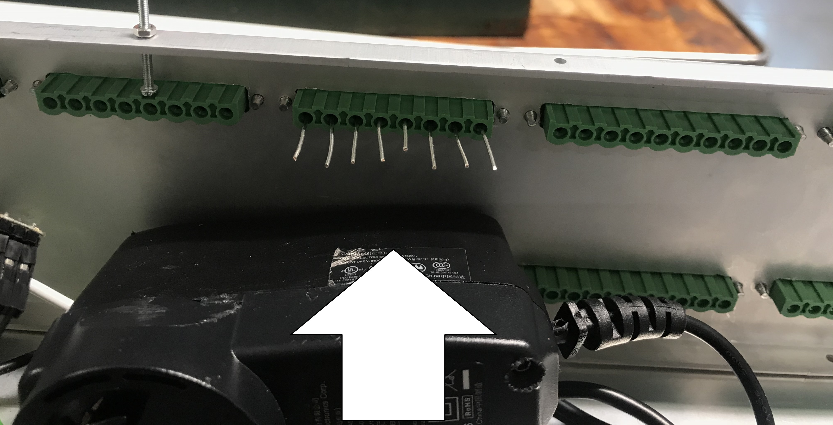
[picture p43: IED_images/ADC1_pins_closer2.jpg]


In case the board is placed far enough from the back panel, we might need to use jointed wires extended by a pin header. Here we manage to reach the ports with one wire length and metal wire pieces 4-5 cm in length. 

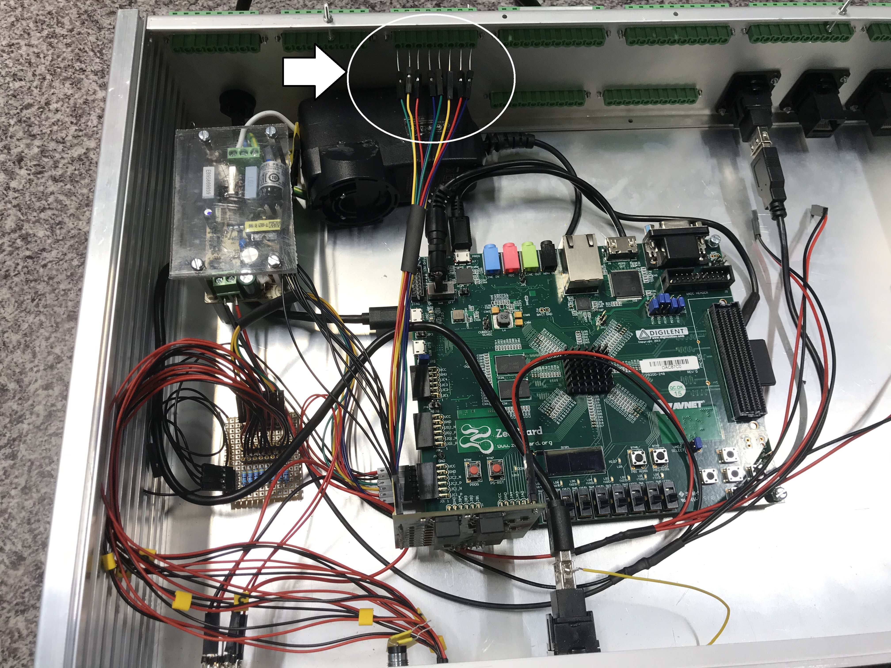
[picture p44: IED_images/ADC_1_wire.jpg]


In case there is no enough length, an alternative would be stacking two wires together with a pin header.

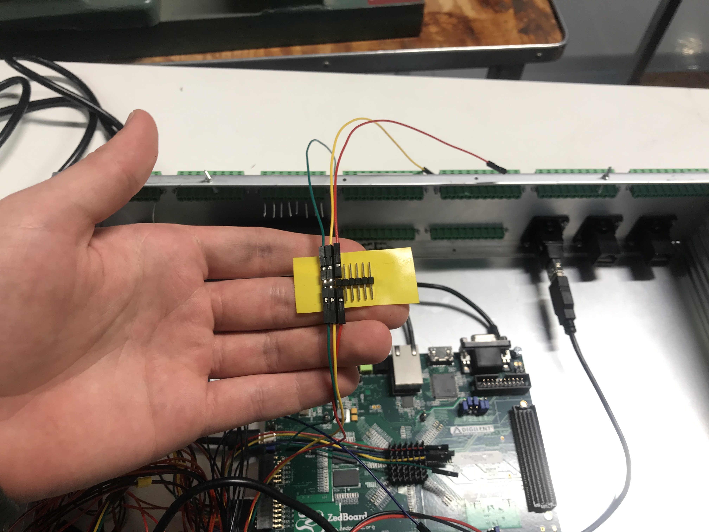
[picture p45: IED_images/ADC_2_wires.jpg]


The wires have the following arrangement at the connector periphery side



The order from left to right repeats at the ADC side from bottom to top. The signal inputs are intertwined with ground wires.

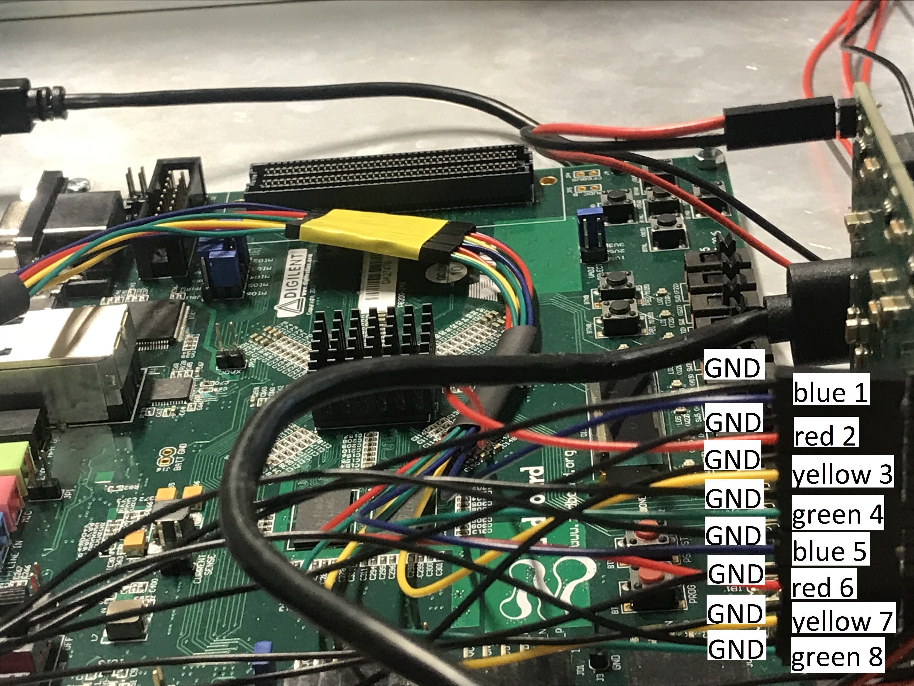
[picture p46: IED_images/ADC_pins_order1.jpg]


## PMOD ADC 2

The PMOD 2x6 headers are located too close together, so that the second ADC module cannot be placed vertically. We solve this by using an extender.

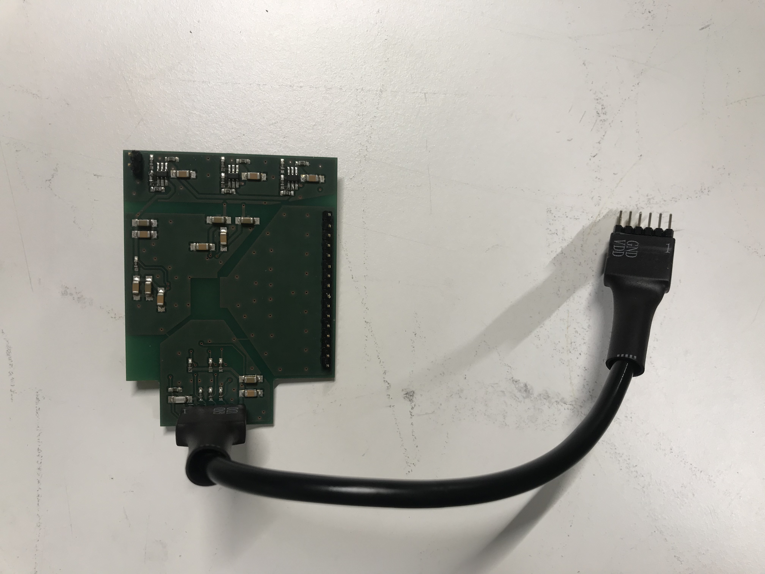
[picture p47: IED_images/ADC_extender.jpg]


Plug in the extender and connect the power supply with an MTE cable in the same arrangement as the first module (red wire closer to the middle of the module). The module connects to the board via an extender plugged in JA headers. 

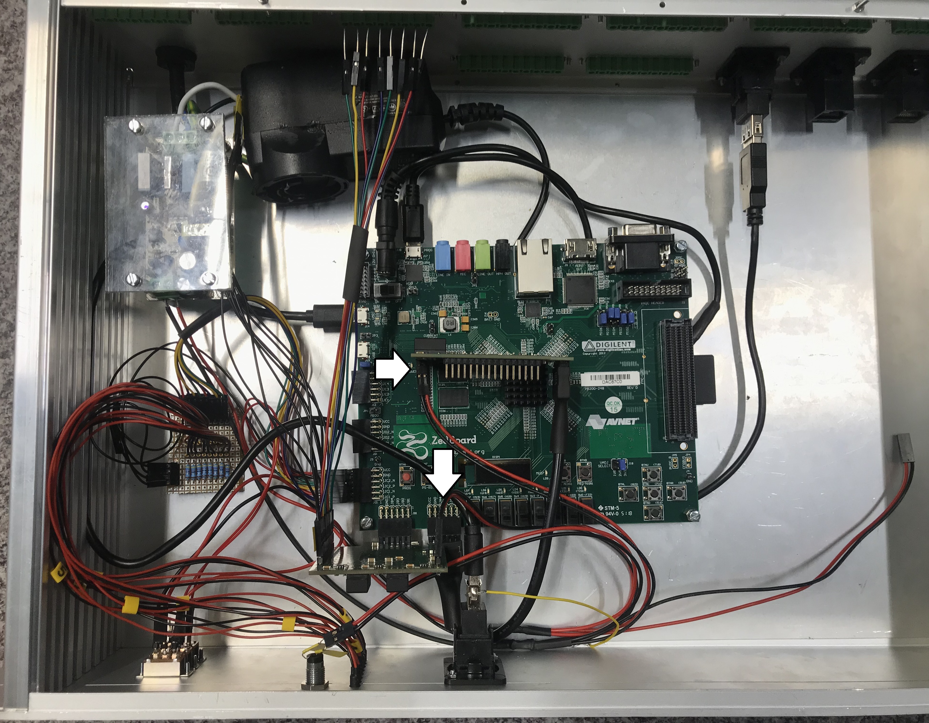
[picture p48: IED_images/ADC2_power(3).jpg]


Connect the input pins on the periphery to the 1x16 pin header on the ADC module in the order identical to the first module. The signal pins correspond with the analog input connectors 9 -16. 

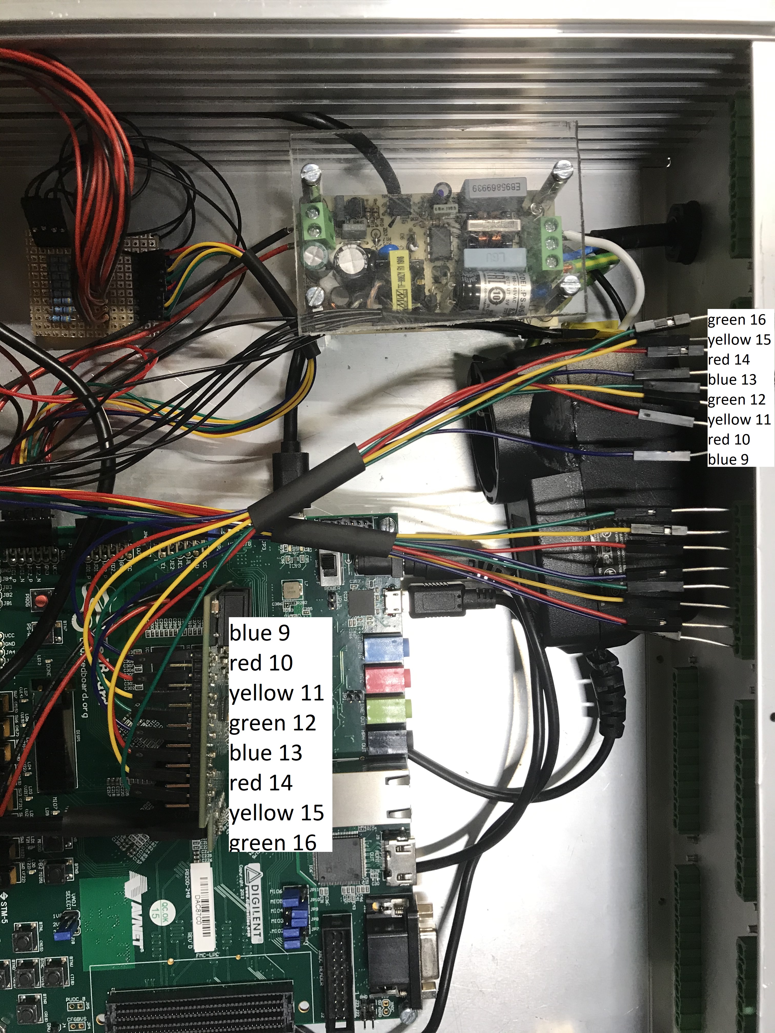
[picture p49: IED_images/ADC2_pins_order(1).jpg]


Similarly to ADC 1, all ground wires are intertwined with the signal wires when connected to the ADC pin header. The other ends of ground wires are soldered together to a piece of wire, which is plugged to a GND connector on the periphery. 

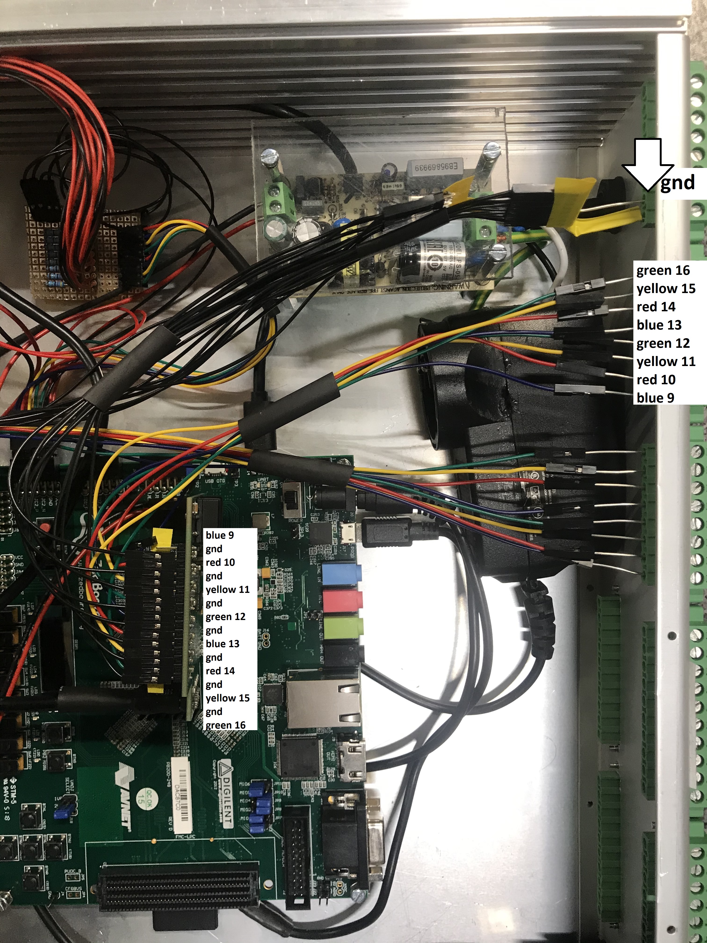
[picture p50: IED_images/ADC2_pins_order_gnd.jpg]


## PMOD DIGITAL INPUT
The digital input module enables us to incorporate more input signals and transmit them to the board. It is used to receive digital values from a simulator (RTDS). The module looks like this

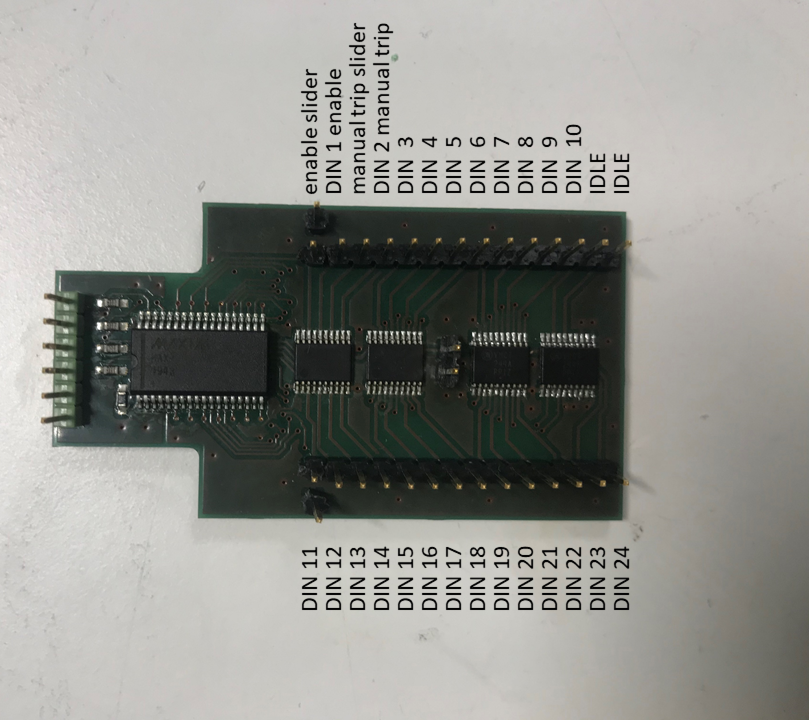
[picture p51: IED_images/PMOD_DIN_labeled.png]


We plug in the module to the top row of a JD header on the Zedboard.

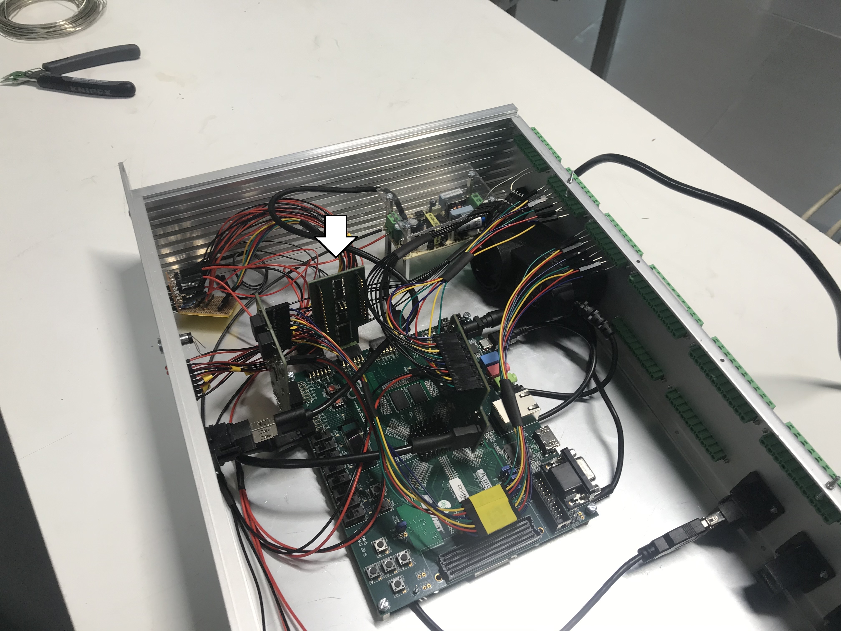
[picture p52: IED_images/DIN_placement.jpg]


We start connecting the module input pins to the digital input ports on the periphery. The bottom pin corresponds to port 11 and the top pin corresponds to port 24.

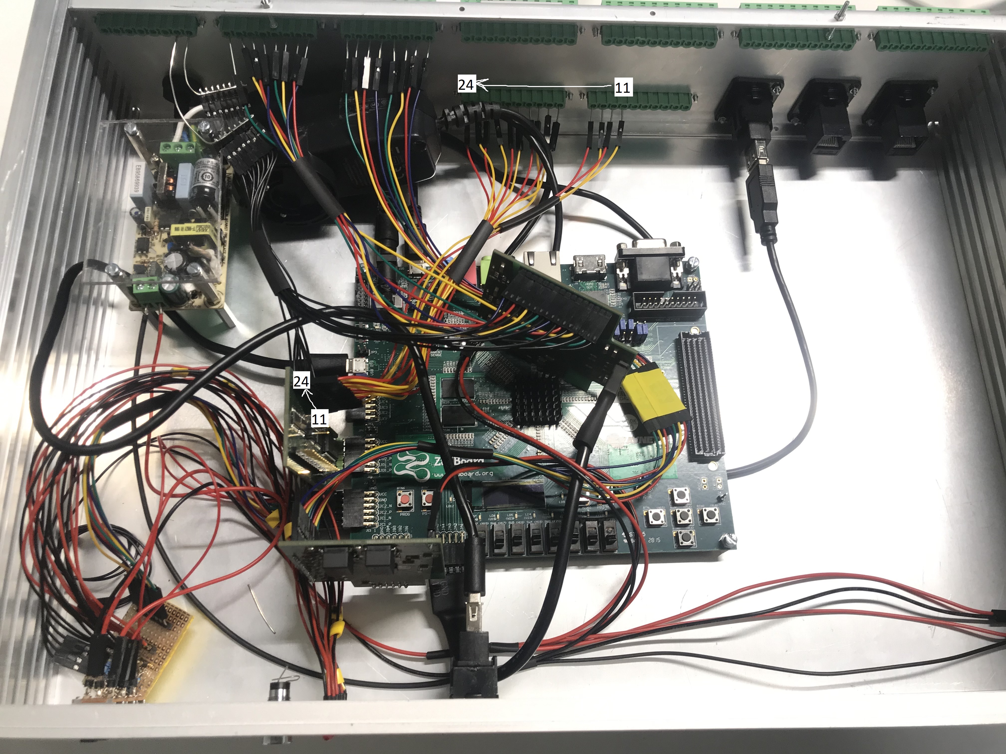
[picture p53: IED_images/DIN_pins11_24.jpg]


The sliders on the front panel are also connected via the Digital Input (DIGIN) PMOD module. Connect the middle pin of the bottom two pitches to the two bottom left pins of the module. The lowermost pin on the module is connected to the middle switch. Third pin in the row is connected to the bottom switch.

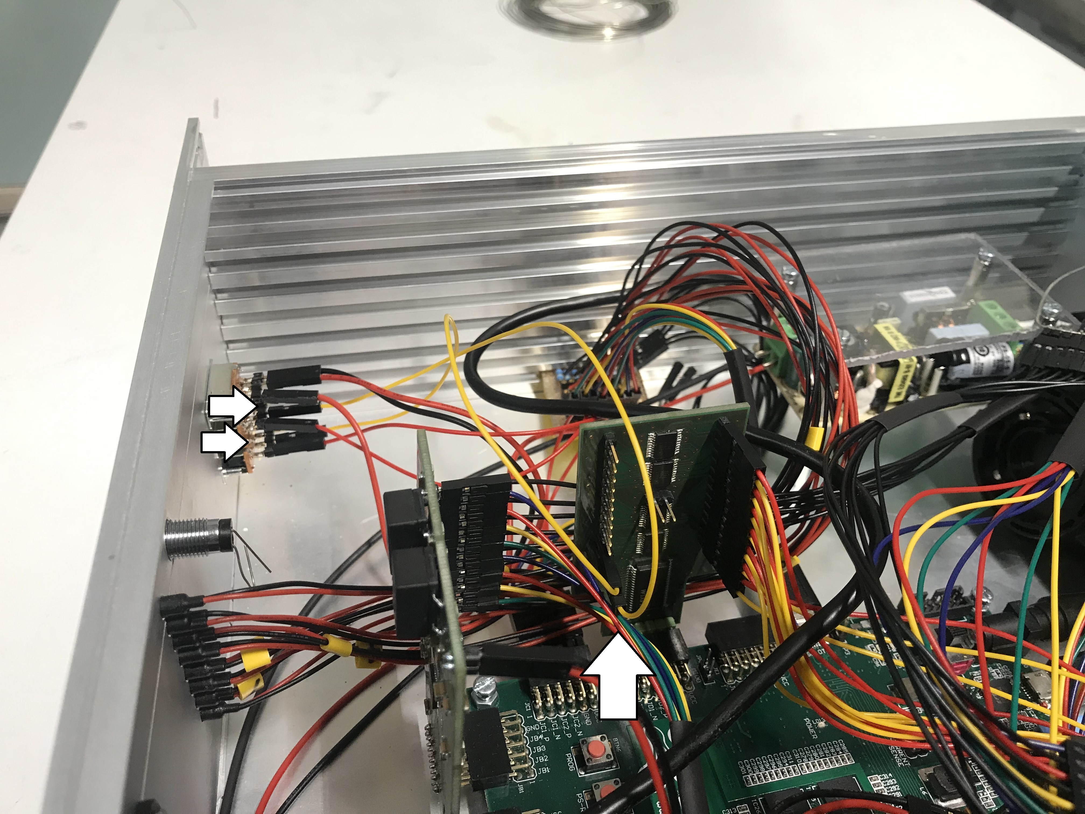
[picture p54: IED_images/DIN_LEDs.jpg]


The inputs 1-10 are connected to the pins on the left row of the DIGIN module. The rightmost digital input port 1 on the back panel links to the third pin from the bottom.  

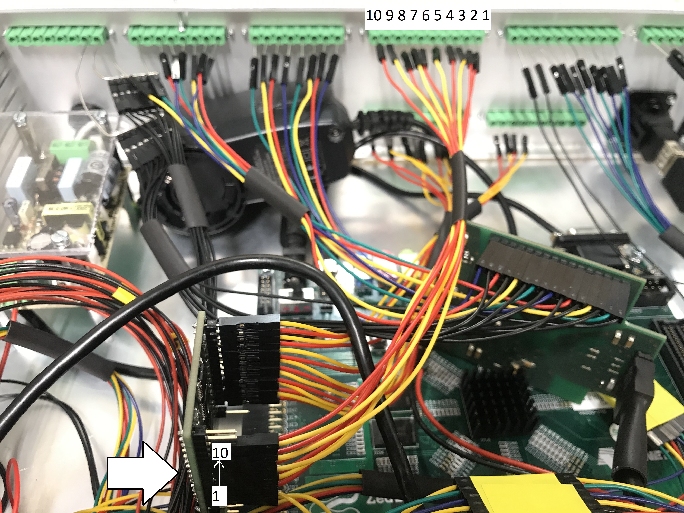
[picture p55: IED_images/DIN_pins(2)1_10.jpg]


The top two pins are kept idle. Here we still attach two wires yet keep ones insulated.

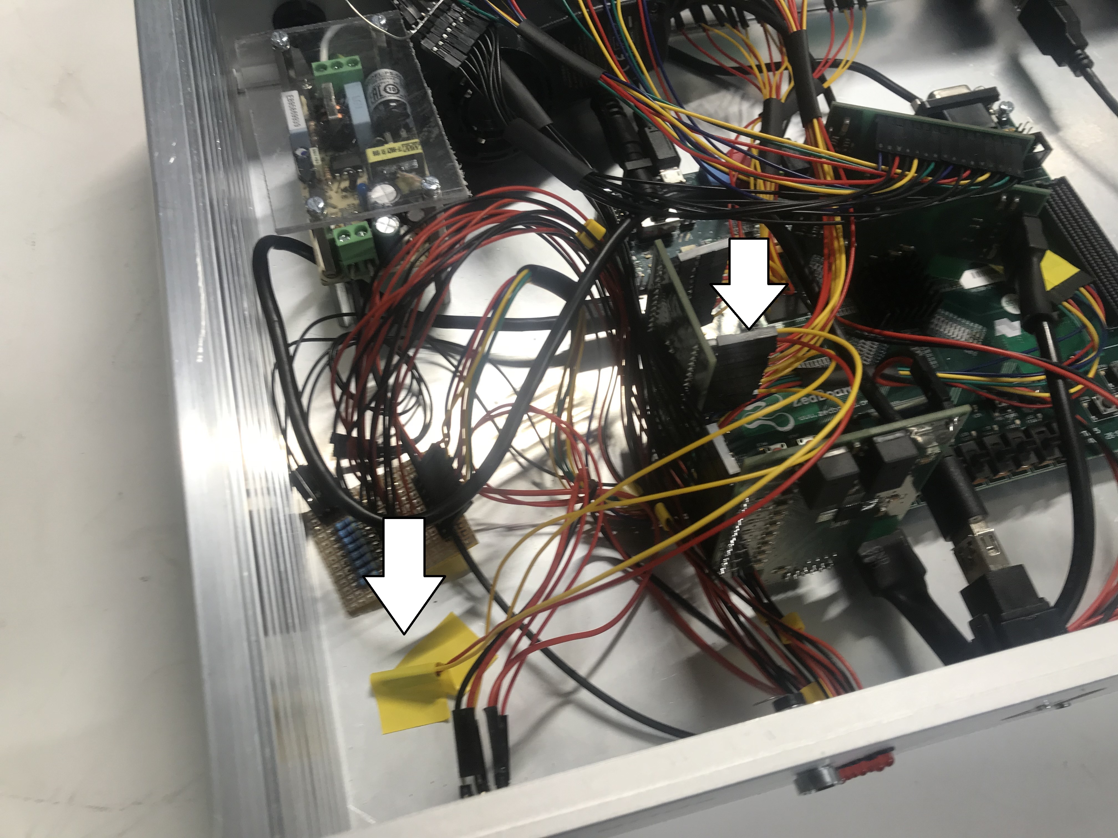
[picture p56: IED_images/DIN_2idle(2).jpg]


## PMOD DIGITAL OUT

The second PMOD is used to send digital 5V output signals to RTDS. It converts Zedboard's 3.3 V logical pin to 5 V specification. The digital out (DIGOUT) module layout is slightly different from the DIN. 

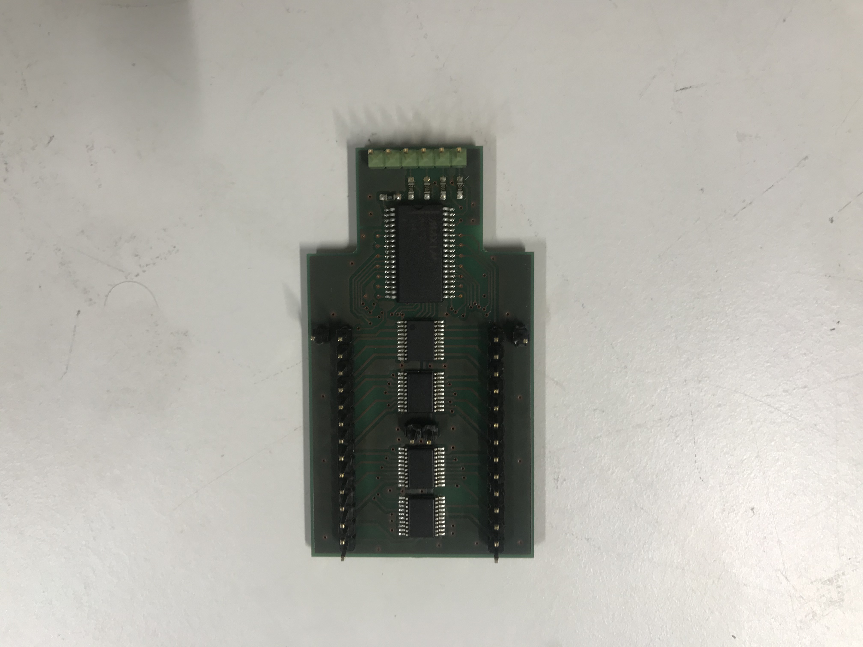
[picture p57: IED_images/DOUT_module.jpg]


Both input and output PMODs cannot be plugged into 2x6 header simultaneously. The DIGOUT module is connected via a self-made extender. 

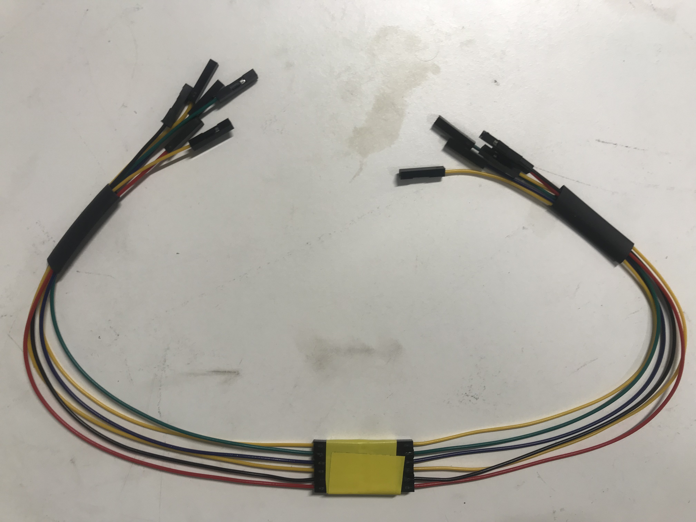
[picture p58: IED_images/DOUT_extender.jpg]


The module is connected in the following arrangement.

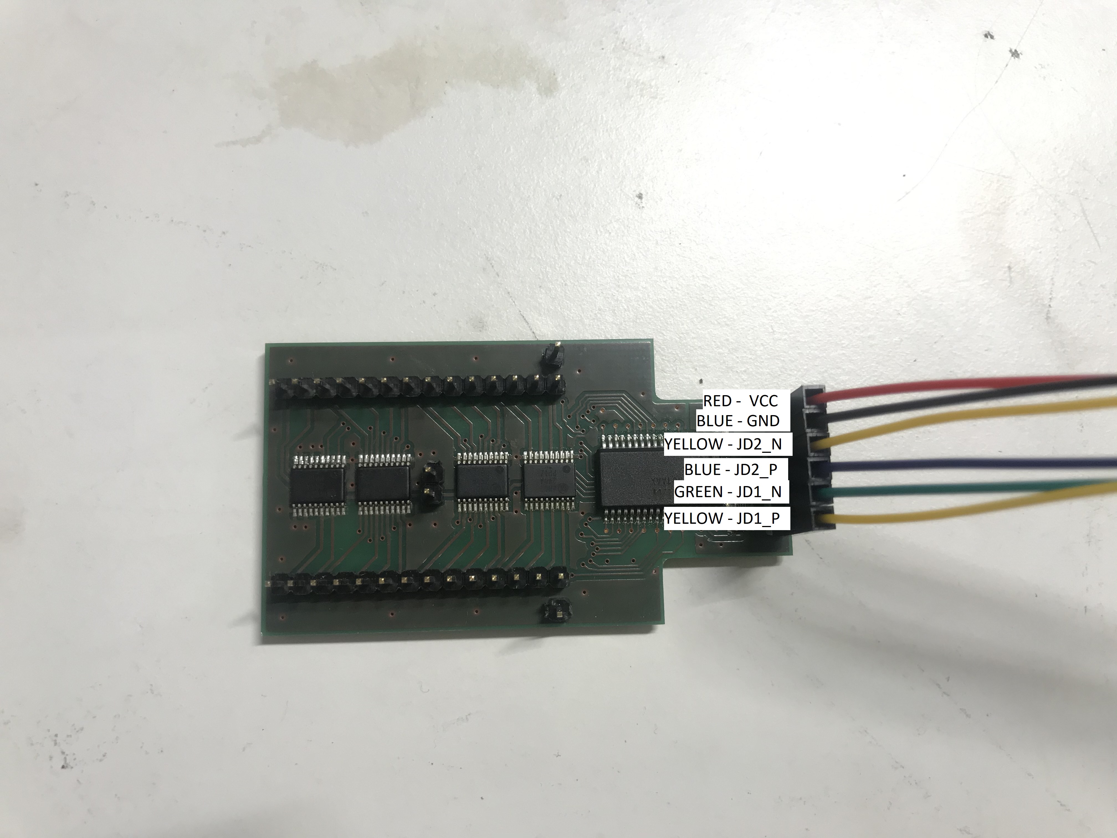
[picture p59: IED_images/DOUT_supply(1).jpg]


On the other end it is connected via the bottom row of the JD 2x6 header on the board. 

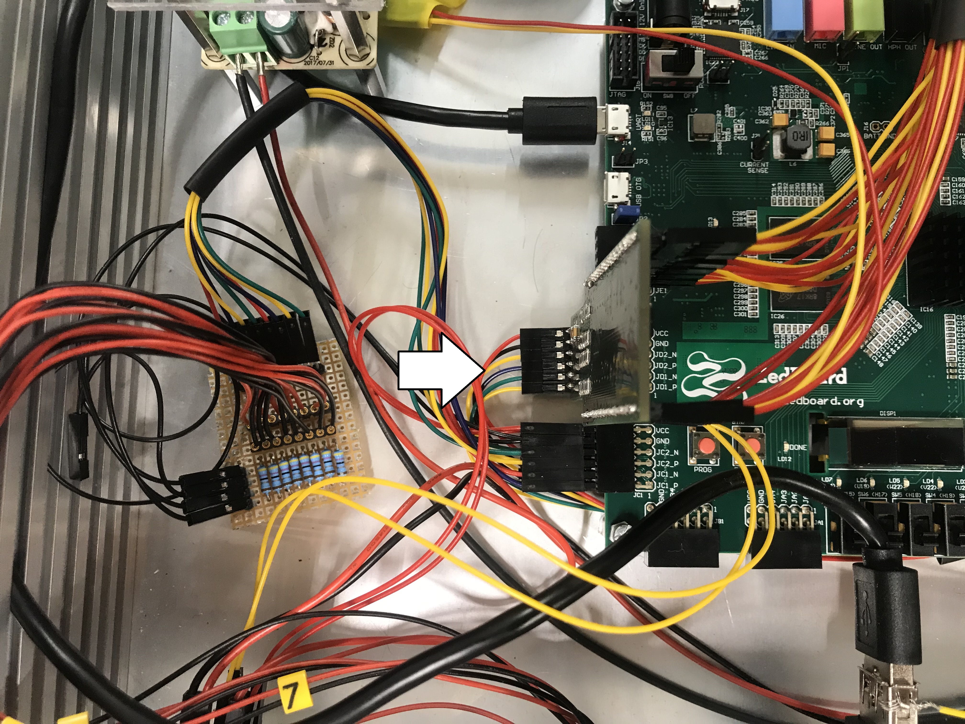
[picture p60: IED_images/DOUT_boardside.jpg]


The power is supply via the pins in the middle.

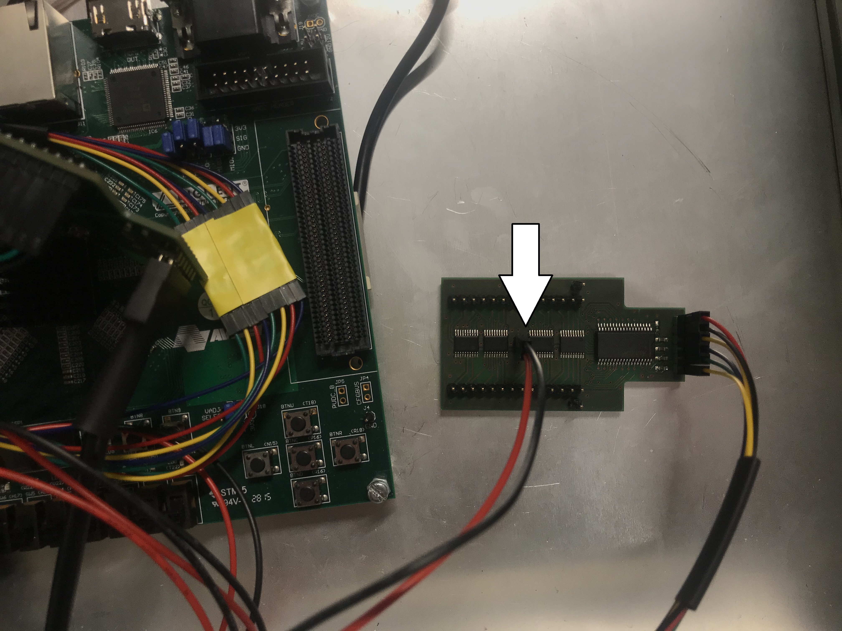
[picture p61: IED_images/DOUT_power.jpg]


Digital output ports 1-10 are wired to the respective pins on the bottom row of the DIGOUT PMOD module. 

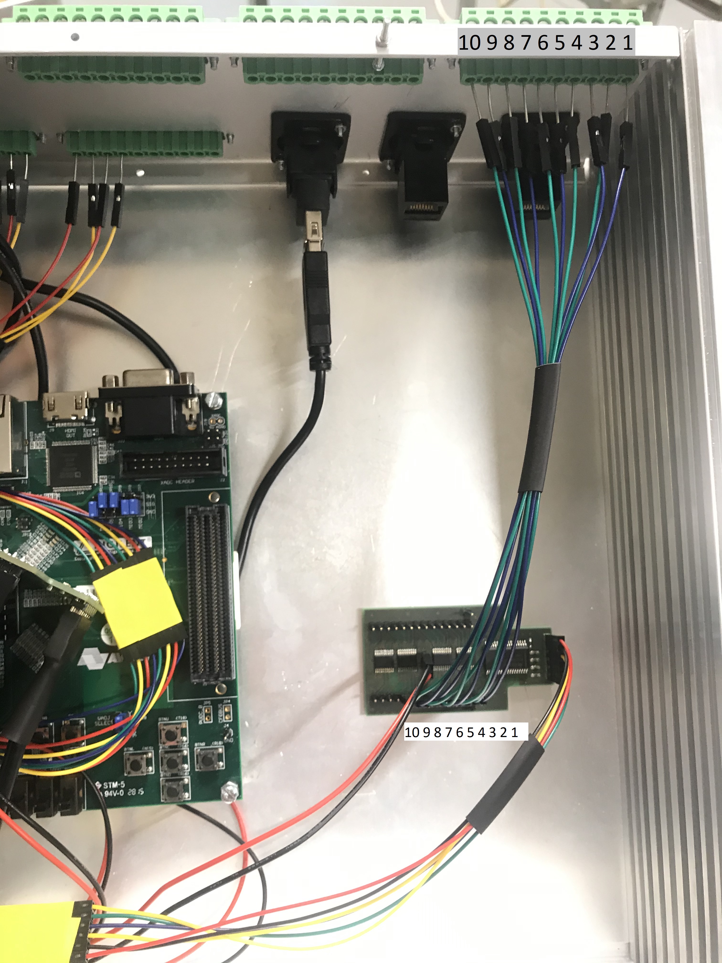
[picture p62: IED_images/DOUT_pins1-10.jpg]


Complete the row on he module with the connections to digital output ports 11-14

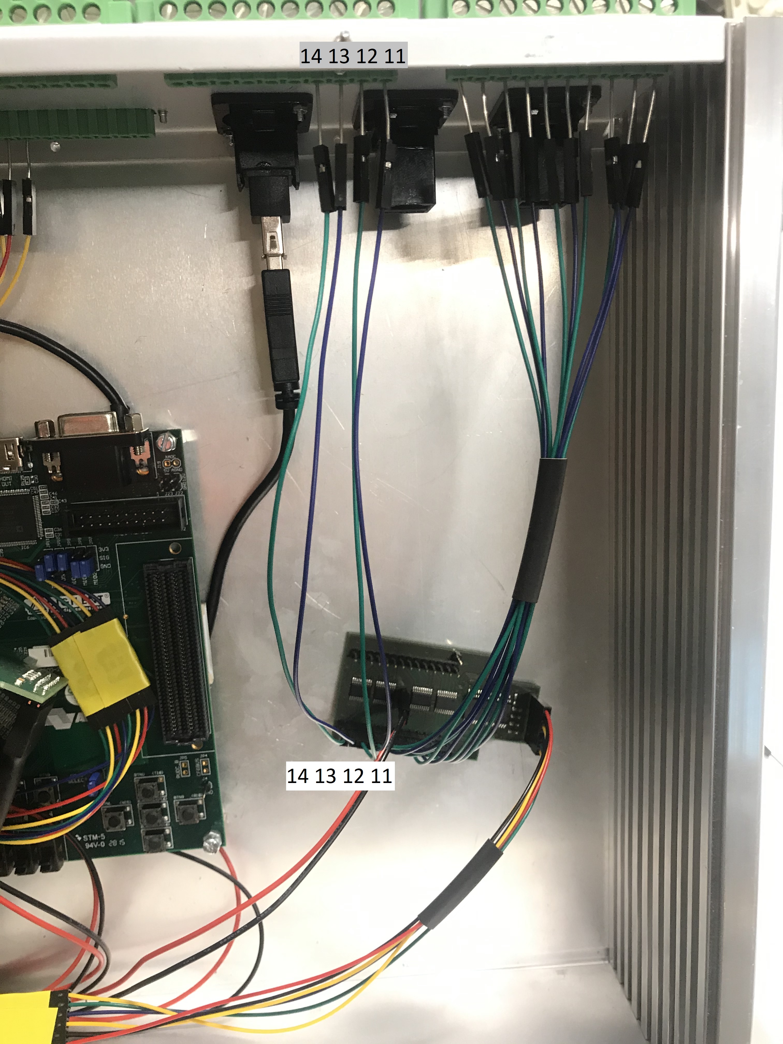
[picture p63: IED_images/DOUT_pins11-14.jpg]


Pins 15-28 of digital output ports connect to PMOD from right to left of the second row.

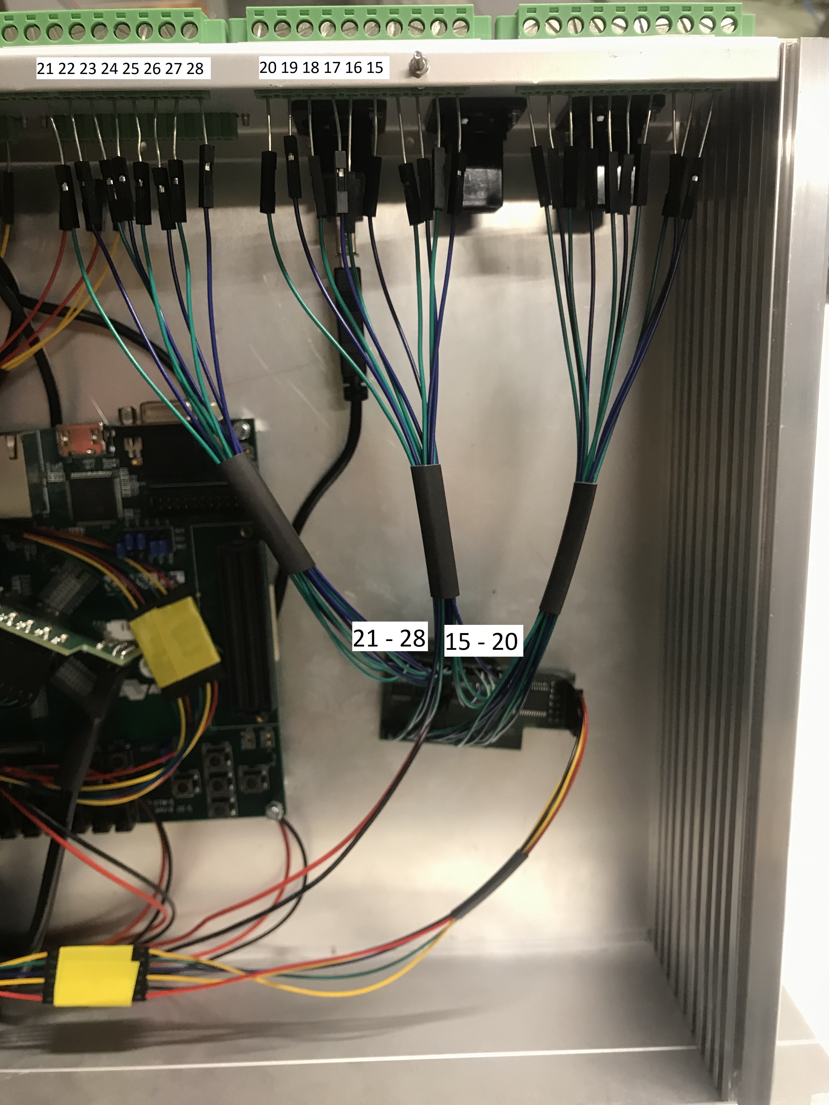
[picture p64: IED_images/DOUT_pins15-28(1).jpg]


The ground wires are connected from both sides and lead to GND output ports. 

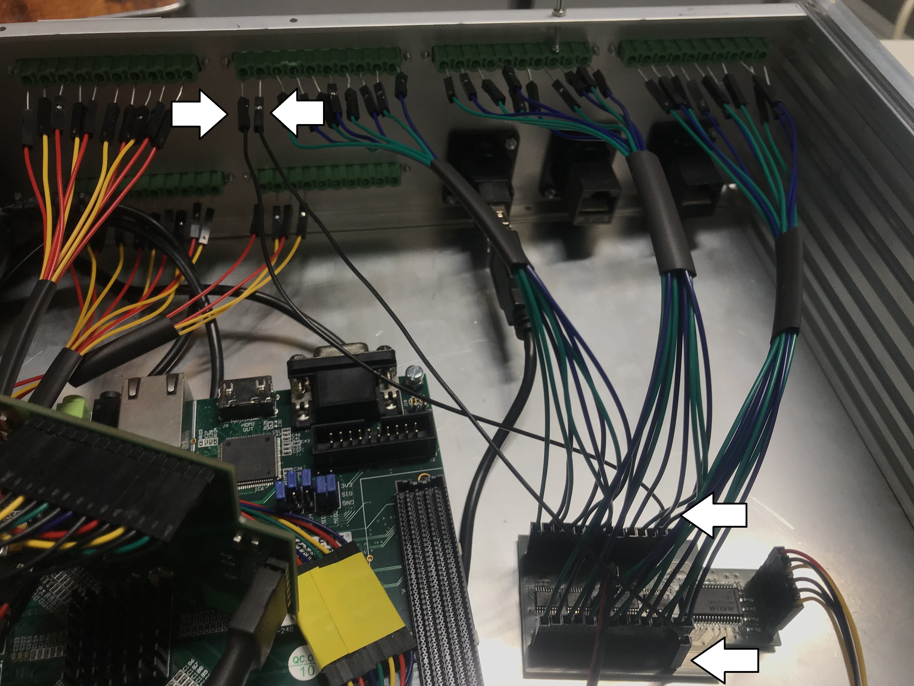
[picture p65: IED_images/DOUT_ground.jpg]


## USB EARTHING CABLE 

Tests of the devise have indicated that the data/configuration cable creates disruptions with signal readings  when connected to the IED. It is recommended to add additional ground wire to the USB port at the front. The wire is tucked between the box walls and the bottom sheet. 

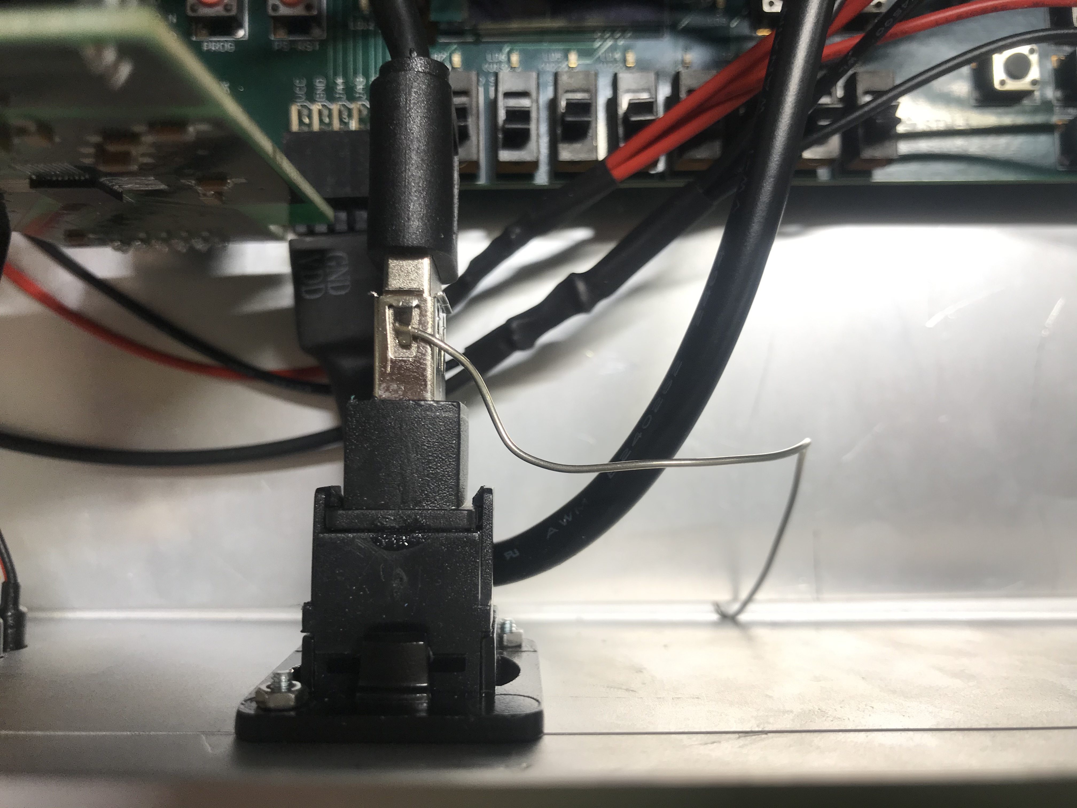
[picture p66: IED_images/USB_earthing.jpg]
