KTH-EPE/HVDC_IED/ALEX/Vivado/src/alex/bd/design_1.pdf

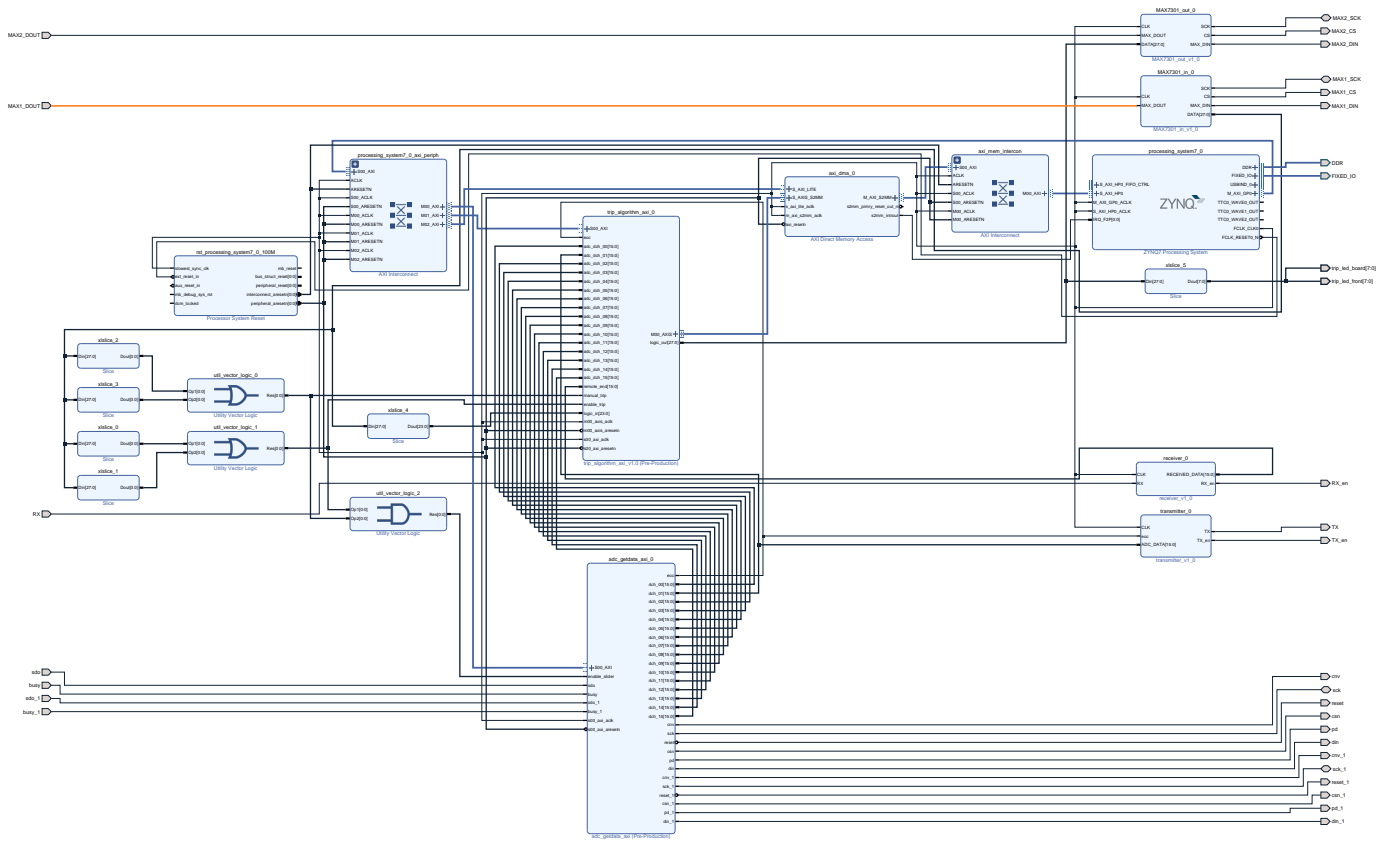
[picture p67: page 1]
DDR; FIXED_IO; MAX1_CS MAX1_DOUT; MAX1_DIN; MAX1_SCK; MAX2_CS MAX2_DIN MAX2_DOUT; MAX2_SCK; MAX7301_in_0; MAX7301_in_v1_0; CLK MAX_DOUT; SCKCS MAX_DIN; DATA[27:0]; MAX7301_out_0; MAX7301_out_v1_0; SCKCS DATA[27:0]; MAX_DIN; adc_getdata_axi_0; adc_getdata_axi (Pre-Production); S00_AXI; eoc; enable_slider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

processing_system7_0_axi_periph | axi_mem_intercon processing_system7_0

AXI Direct Memory Access

Processor System Reset

Utility Vector Logic
