KTH-EPE/HVDC_IED/PMOD ADC/kicad files/PMOD.kicad_pcb

## KiCad design PMOD ADC/kicad files/PMOD.kicad_pcb (2019-10-03)

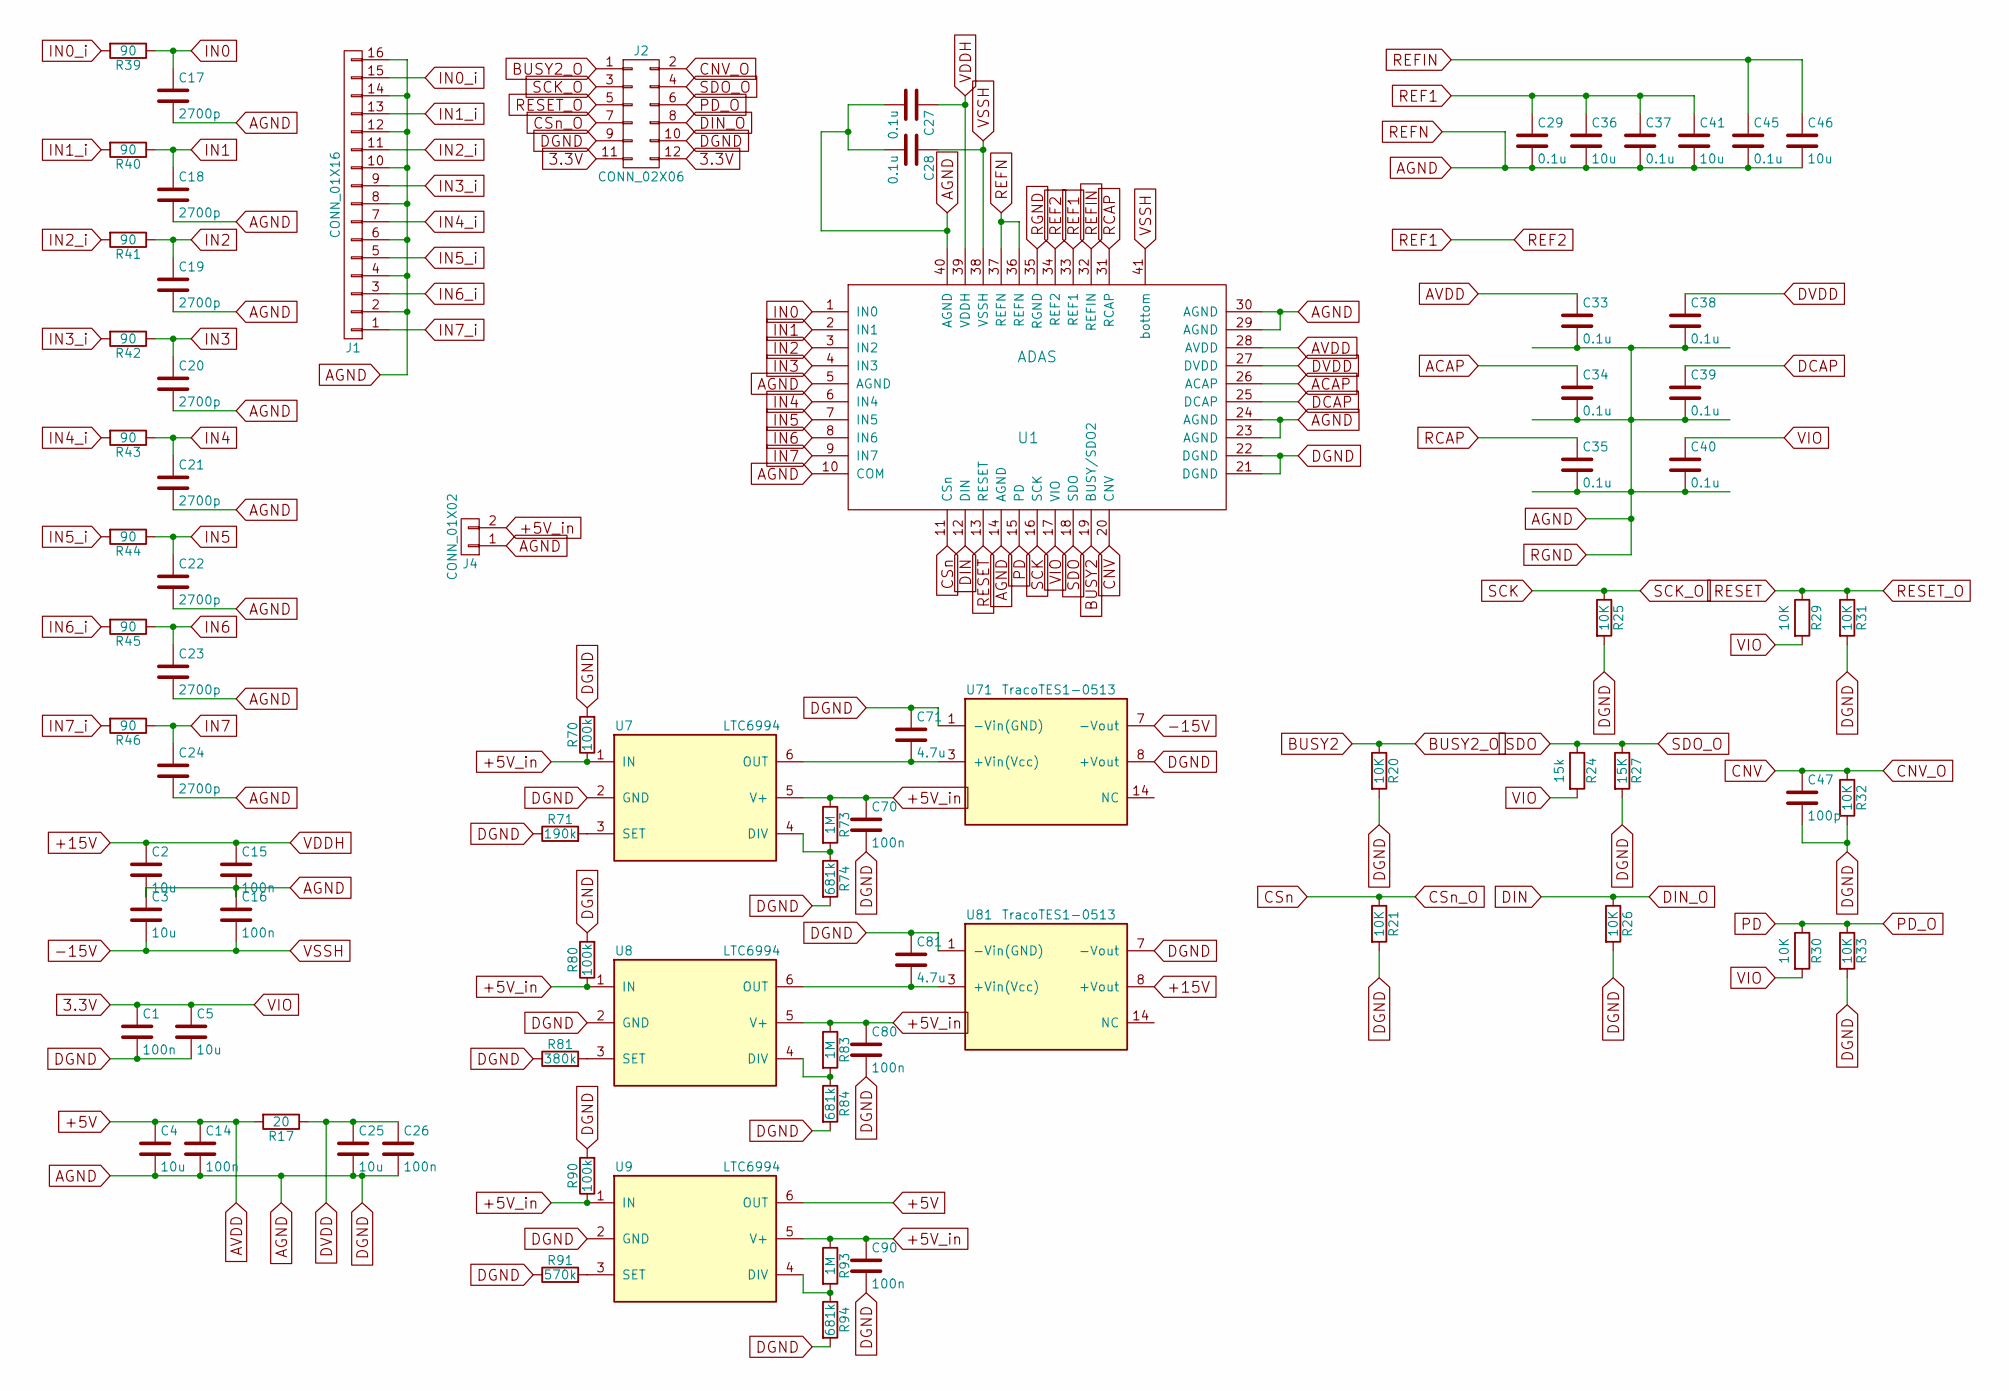
[picture p68: schematic PMOD.sch]

Parts:
C1, C14, C15, C16, C26, C70, C80, C90: 100n; C_1206_HandSoldering
C2, C3, C4, C5, C25, C36, C41, C46: 10u; C_1206_HandSoldering
C17, C18, C19, C20, C21, C22, C23, C24: 2700p; C_1206_HandSoldering
C27, C28, C29, C33, C34, C35, C37, C38, C39, C40, C45: 0.1u; C_1206_HandSoldering
C47: 100p; C_1206_HandSoldering
C71, C81: 4.7u; C_1206_HandSoldering
J1: CONN_01X16; Pin_Header_Angled_1x16_Pitch2.54mm
J2: CONN_02X06; Multicomp_MC9A_2x06x2.54mm_Straight
J4: CONN_01X02; Pin_Header_Angled_1x02_Pitch2.54mm
R17: 20; R_0603_HandSoldering
R20, R21, R25, R26, R29, R30, R31, R32, R33: 10K; R_0603_HandSoldering
R24: 15k; R_0603_HandSoldering
R27: 15K; R_0603_HandSoldering
R39, R40, R41, R42, R43, R44, R45, R46: 90; R_0603_HandSoldering
R70, R80, R90: 100k; R_0603_HandSoldering
R71: 190k; R_0603_HandSoldering
R73, R83, R93: 1M; R_0603_HandSoldering
R74, R84, R94: 681k; R_0603_HandSoldering
R81: 380k; R_0603_HandSoldering
R91: 570k; R_0603_HandSoldering
U1: ADAS; QFN-40-1EP_6x6mm_Pitch0.5mm
U7, U8, U9: LTC6994; TSOT-23-6_HandSoldering
U71, U81: TracoTES1-0513; DCDC-Conv_TRACO_TES-1SM

Connections:
3.3V: C1.1, C5.1, C40.1, J2.11, J2.12, R24.2, R29.2, R30.2, U1.17 (VIO)
+5V: C4.1, C14.1, C33.1, R17.2, U1.28 (AVDD), U9.6 (OUT)
+5V_in: C70.1, C80.1, C90.1, J4.2, R70.1, R73.1, R80.1, R83.1, R90.1, R93.1, U7.1 (IN), U7.5 (V+), U8.1 (IN), U8.5 (V+), U9.1 (IN), U9.5 (V+)
+15V: C2.1, C15.1, C27.1, U1.39 (VDDH), U81.8 (+Vout)
-15V: C3.2, C16.2, C28.1, U1.38 (VSSH), U1.41 (bottom), U71.7 (-Vout)
ACAP: C34.1, U1.26 (ACAP)
AGND: C1.2, C2.2, C3.1, C4.2, C5.2, C14.2, C15.2, C16.1, C17.2, C18.2, C19.2, C20.2, C21.2, C22.2, C23.2, C24.2, C25.2, C26.2, C27.2, C28.2, C29.2, C33.2, C34.2, C35.2, C36.2, C37.2, C38.2, C39.2, C40.2, C41.2, C45.2, C46.2, C47.2, C70.2, C71.1, C80.2, C81.1, C90.2, J1.2, J1.4, J1.6, J1.8, J1.10, J1.12, J1.14, J1.16, J2.9, J2.10, J4.1, R20.2, R21.2, R25.2, R26.2, R27.2, R31.2, R32.2, R33.2, R70.2, R71.1, R74.2, R80.2, R81.1, R84.2, R90.2, R91.1, R94.2, U1.5 (AGND), U1.10 (COM), U1.14 (AGND), U1.21 (DGND), U1.22 (DGND), U1.23 (AGND), U1.24 (AGND), U1.29 (AGND), U1.30 (AGND), U1.35 (RGND), U1.36 (REFN), U1.37 (REFN), U1.40 (AGND), U7.2 (GND), U8.2 (GND), U9.2 (GND), U71.1 (-Vin(GND)), U71.8 (+Vout), U81.1 (-Vin(GND)), U81.7 (-Vout)
BUSY2: J2.1, R20.1, U1.19 (BUSY/SDO2)
CNV: C47.1, J2.2, R32.1, U1.20 (CNV)
CSn: J2.7, R21.1, U1.11 (CSn)
DCAP: C39.1, U1.25 (DCAP)
DIN: J2.8, R26.1, U1.12 (DIN)
DVDD: C25.1, C26.1, C38.1, R17.1, U1.27 (DVDD)
IN0: C17.1, R39.1, U1.1 (IN0)
IN0_i: J1.15, R39.2
IN1: C18.1, R40.1, U1.2 (IN1)
IN1_i: J1.13, R40.2
IN2: C19.1, R41.1, U1.3 (IN2)
IN2_i: J1.11, R41.2
IN3: C20.1, R42.1, U1.4 (IN3)
IN3_i: J1.9, R42.2
IN4: C21.1, R43.1, U1.6 (IN4)
IN4_i: J1.7, R43.2
IN5: C22.1, R44.1, U1.7 (IN5)
IN5_i: J1.5, R44.2
IN6: C23.1, R45.1, U1.8 (IN6)
IN6_i: J1.3, R45.2
IN7: C24.1, R46.1, U1.9 (IN7)
IN7_i: J1.1, R46.2
unnamed: C71.2, U7.6 (OUT), U71.3 (+Vin(Vcc))
unnamed: C81.2, U8.6 (OUT), U81.3 (+Vin(Vcc))
unnamed: R71.2, U7.3 (SET)
unnamed: R73.2, R74.1, U7.4 (DIV)
unnamed: R81.2, U8.3 (SET)
unnamed: R83.2, R84.1, U8.4 (DIV)
unnamed: R91.2, U9.3 (SET)
unnamed: R93.2, R94.1, U9.4 (DIV)
PD: J2.6, R30.1, R33.1, U1.15 (PD)
RCAP: C35.1, U1.31 (RCAP)
REF1: C29.1, C36.1, C37.1, C41.1, U1.33 (REF1), U1.34 (REF2)
REFIN: C45.1, C46.1, U1.32 (REFIN)
RESET: J2.5, R29.1, R31.1, U1.13 (RESET)
SCK: J2.3, R25.1, U1.16 (SCK)
SDO: J2.4, R24.1, R27.1, U1.18 (SDO)

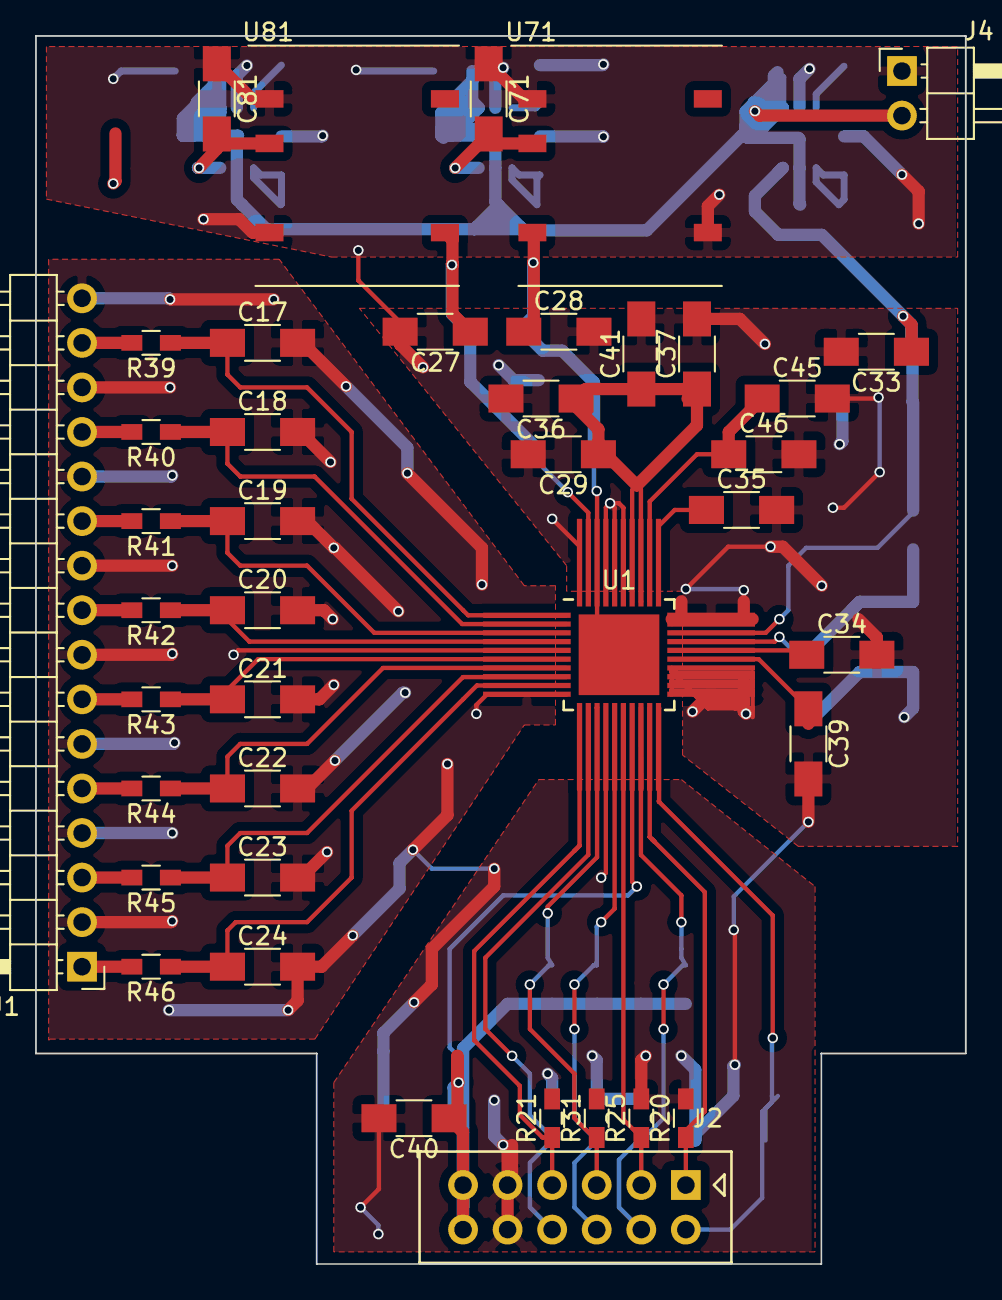
[picture p69: board PMOD ADC/kicad files/PMOD.kicad_pcb from above]

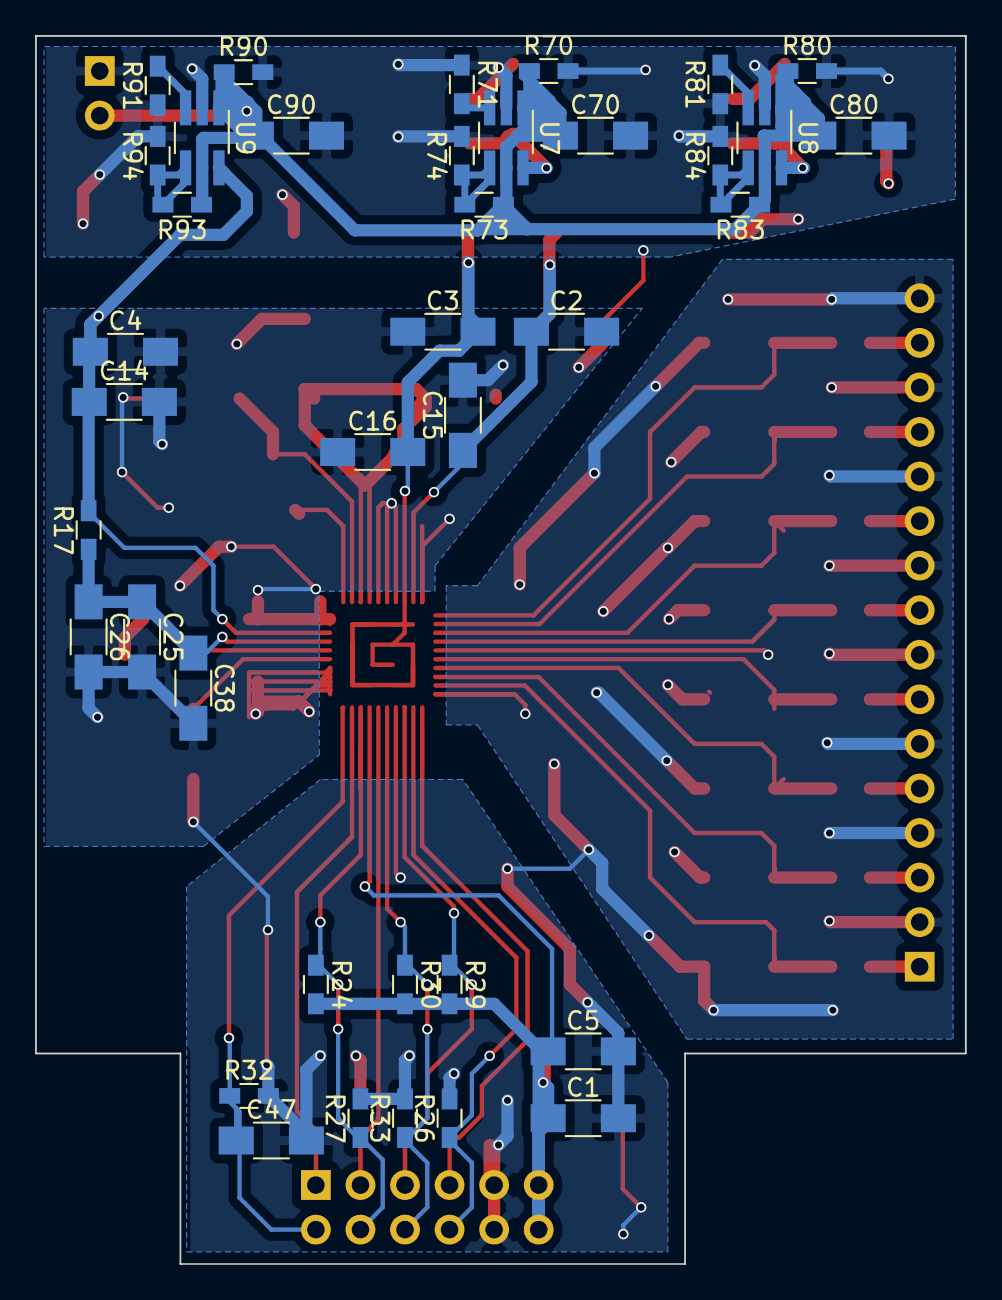
[picture p70: board PMOD ADC/kicad files/PMOD.kicad_pcb from below]

Board: 2 copper layers, 53.0 x 70.0 mm, 79 parts (38 on the bottom side), 44 nets.
