KTH-EPE/HVDC_IED/PMOD DIGIN/kicad files/PMOD.kicad_pcb

## KiCad design PMOD DIGIN/kicad files/PMOD.kicad_pcb (2019-10-03)

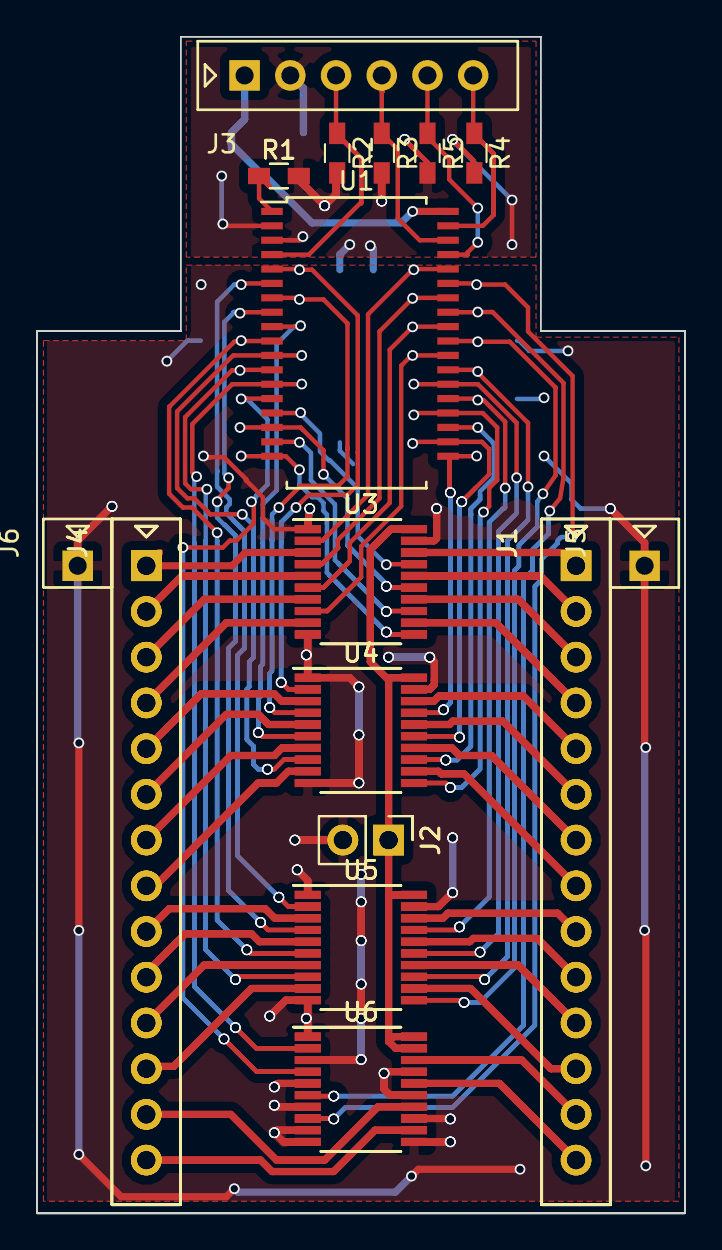
[picture p71: board PMOD DIGIN/kicad files/PMOD.kicad_pcb from above]

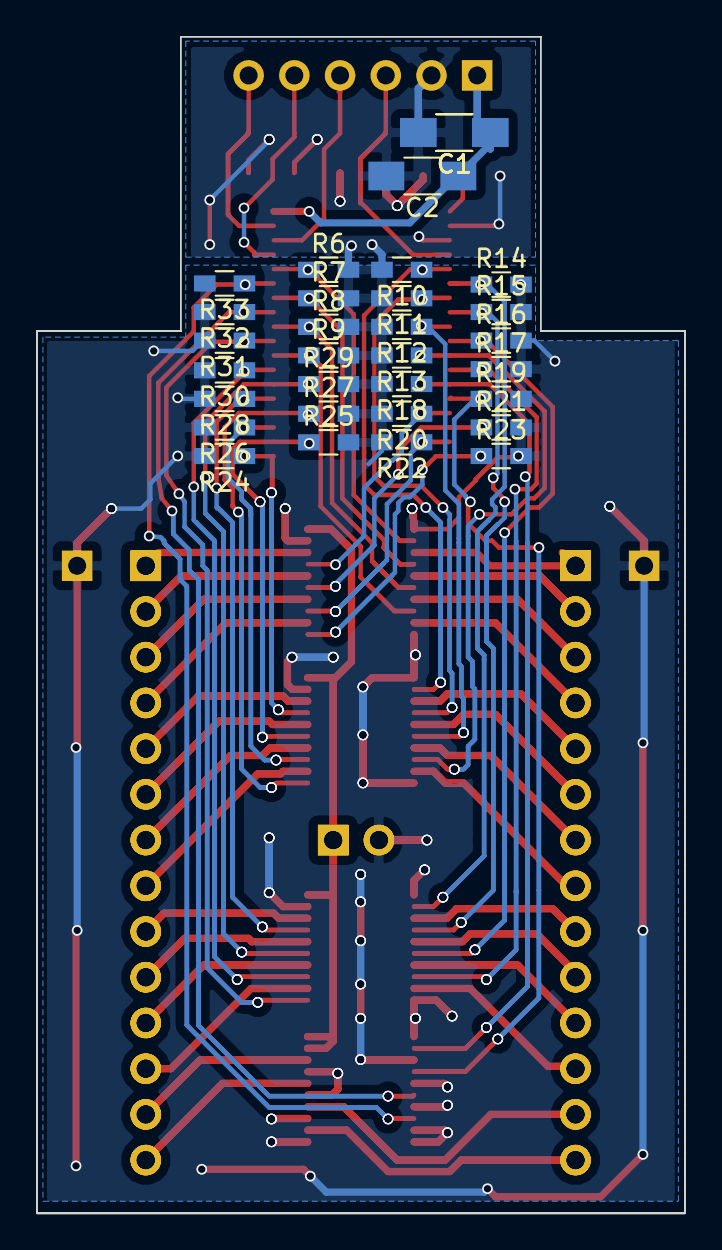
[picture p72: board PMOD DIGIN/kicad files/PMOD.kicad_pcb from below]

Board: 2 copper layers, 36.0 x 65.4 mm, 55 parts (31 on the bottom side), 64 nets.

Parts:
C1, C1#2: 1u; C_1206_HandSoldering
C2: 47n; C_1206_HandSoldering
J1, J1#2, J4, J4#2: CONN_01X14; Multicomp_MC9A_1x14x2.54mm_Straight
J2, J2#2: CONN_01X02_MALE; Pin_Header_Straight_1x02_Pitch2.54mm
J3: CONN_01X06; Multicomp_MC9A_2x06x2.54mm_Straight
J5, J6: CONN_01X01; Multicomp_MC9A_1x14x2.54mm_Straight
R1, R1#2: 39k; R_0603_HandSoldering
R2, R3, R4, R5, R6, R7, R8, R9, R10, R11, R12, R13, R14, R15, R16, R17, R18, R19, R20, R21, R22, R23, R24, R25, R26, R27, R28, R29, R30, R31, R32, R33: 10k; R_0603_HandSoldering
U1: MAX7301; SSOP-63_7.5x15.9mm_Pitch0.635mm
U3, U3#2, U4, U4#2, U5, U5#2, U6, U6#2: MC74VHCT244A; TSSOP-20_4.4x6.5mm_Pitch0.65mm

Connections:
+3V3: C1.1, C1#2.1, C2.1, J3.1, U1.36
+5V: J2.1, J2#2.1, U3.20, U3#2.20, U4.20, U4#2.20, U5.20, U5#2.20, U6.19, U6.20, U6#2.19, U6#2.20
GND: C1.2, C1#2.2, C2.2, J2.2, J2#2.2, J3.2, J5.1, J6.1, R1.2, R1#2.2, R2.2, R3.2, R4.2, R5.2, R6.2, R7.2, R8.2, R9.2, R10.2, R11.2, R12.2, R13.2, R14.2, R15.2, R16.2, R17.2, R18.2, R19.2, R20.2, R21.2, R22.2, R23.2, R24.2, R25.2, R26.2, R27.2, R28.2, R29.2, R30.2, R31.2, R32.2, R33.2, U1.2, U1.3, U3.1, U3.10, U3.19, U3#2.1, U3#2.10, U3#2.19, U4.1, U4.10, U4.19, U4#2.1, U4#2.10, U4#2.19, U5.1, U5.10, U5.19, U5#2.1, U5#2.10, U5#2.19, U6.1, U6.3, U6.5, U6.7, U6.9, U6.10, U6.11, U6.13, U6.15, U6.17, U6#2.1, U6#2.3, U6#2.5, U6#2.7, U6#2.9, U6#2.10, U6#2.11, U6#2.13, U6#2.15, U6#2.17
unnamed: J3.3, R2.1, U1.4
unnamed: J3.4, R3.1, U1.34
unnamed: J3.5, R5.1, U1.33
unnamed: J3.6, R4.1, U1.35
unnamed: R1.1, R1#2.1, U1.1
sig1: J1.1, J1#2.1, U3.18, U3#2.18
sig2: J1.2, J1#2.2, U3.16, U3#2.16
sig3: J1.3, J1#2.3, U3.14, U3#2.14
sig4: J1.4, J1#2.4, U3.12, U3#2.12
sig5: J1.5, J1#2.5, U4.18, U4#2.18
sig6: J1.6, J1#2.6, U4.16, U4#2.16
sig7: J1.7, J1#2.7, U4.14, U4#2.14
sig8: J1.8, J1#2.8, U4.12, U4#2.12
sig9: J1.9, J1#2.9, U5.18, U5#2.18
sig10: J1.10, J1#2.10, U5.16, U5#2.16
sig11: J1.11, J1#2.11, U5.14, U5#2.14
sig12: J1.12, J1#2.12, U5.12, U5#2.12
sig13: J1.13, J1#2.13, U6.18, U6#2.18
sig14: J1.14, J1#2.14, U6.16, U6#2.16
sig15: J4.1, J4#2.1, U3.3, U3#2.3
sig16: J4.2, J4#2.2, U3.5, U3#2.5
sig17: J4.3, J4#2.3, U3.7, U3#2.7
sig18: J4.4, J4#2.4, U3.9, U3#2.9
sig19: J4.5, J4#2.5, U4.3, U4#2.3
sig20: J4.6, J4#2.6, U4.5, U4#2.5
sig21: J4.7, J4#2.7, U4.7, U4#2.7
sig22: J4.8, J4#2.8, U4.9, U4#2.9
sig23: J4.9, J4#2.9, U5.3, U5#2.3
sig24: J4.10, J4#2.10, U5.5, U5#2.5
sig25: J4.11, J4#2.11, U5.7, U5#2.7
sig26: J4.12, J4#2.12, U5.9, U5#2.9
sig27: J4.13, J4#2.13, U6.14, U6#2.14
sig28: J4.14, J4#2.14, U6.12, U6#2.12
sig_1: R6.1, U1.32, U3.2, U3#2.2
sig_2: R7.1, U1.30, U3.4, U3#2.4
sig_3: R8.1, U1.28, U3.6, U3#2.6
sig_4: R9.1, U1.26, U3.8, U3#2.8
sig_5: R10.1, U1.5, U4.2, U4#2.2
sig_6: R11.1, U1.7, U4.4, U4#2.4
sig_7: R12.1, U1.9, U4.6, U4#2.6
sig_8: R13.1, U1.11, U4.8, U4#2.8
sig_9: R14.1, U1.6, U5.2, U5#2.2
sig_10: R15.1, U1.8, U5.4, U5#2.4
sig_11: R16.1, U1.10, U5.6, U5#2.6
sig_12: R17.1, U1.12, U5.8, U5#2.8
sig_13: R18.1, U1.13, U6.2, U6#2.2
sig_14: R19.1, U1.14, U6.4, U6#2.4
sig_15: R20.1, U1.15, U3.17, U3#2.17
sig_16: R21.1, U1.16, U3.15, U3#2.15
sig_17: R22.1, U1.17, U3.13, U3#2.13
sig_18: R23.1, U1.18, U3.11, U3#2.11
sig_19: R24.1, U1.19, U4.17, U4#2.17
sig_20: R25.1, U1.20, U4.15, U4#2.15
sig_21: R26.1, U1.21, U4.13, U4#2.13
sig_22: R27.1, U1.22, U4.11, U4#2.11
sig_23: R28.1, U1.23, U5.17, U5#2.17
sig_24: R29.1, U1.24, U5.15, U5#2.15
sig_25: R30.1, U1.25, U5.13, U5#2.13
sig_26: R31.1, U1.27, U5.11, U5#2.11
sig_27: R32.1, U1.29, U6.6, U6#2.6
sig_28: R33.1, U1.31, U6.8, U6#2.8
