KTH-EPE/HVDC_IED/PMOD DIGOUT/kicad files/PMOD.kicad_pcb

## KiCad design PMOD DIGOUT/kicad files/PMOD.kicad_pcb (2019-10-03)

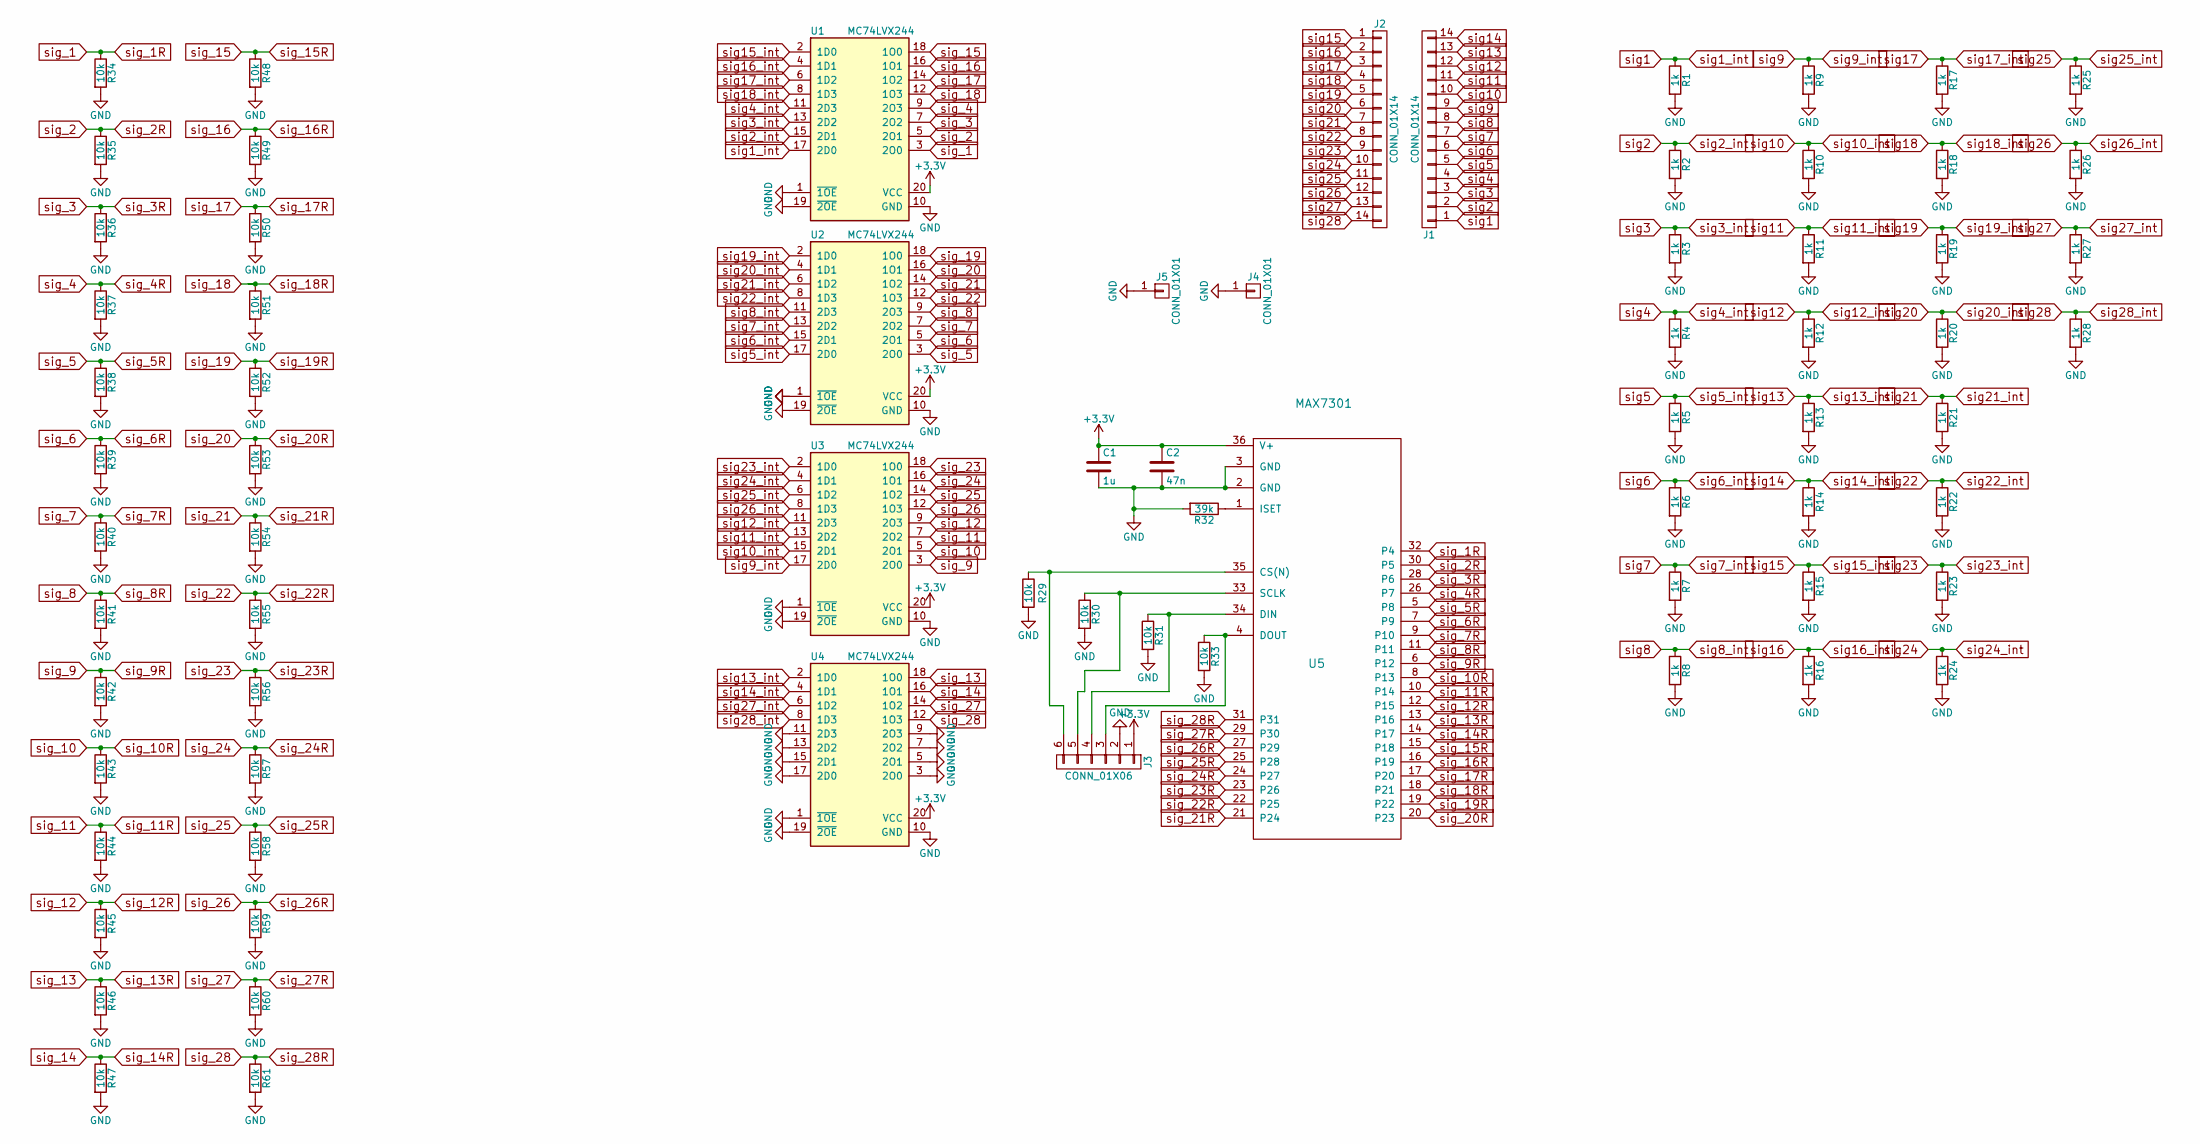
[picture p73: schematic PMOD.sch]

Parts:
C1: 1u; C_1206_HandSoldering
C2: 47n; C_1206_HandSoldering
J1, J2: CONN_01X14; Multicomp_MC9A_1x14x2.54mm_Straight
J3: CONN_01X06
J4, J5: CONN_01X01
R1, R2, R3, R4, R5, R6, R7, R8, R9, R10, R11, R12, R13, R14, R15, R16, R17, R18, R19, R20, R21, R22, R23, R24, R25, R26, R27, R28: 1k; R_0603_HandSoldering
R29, R30, R31, R33, R34, R35, R36, R37, R38, R39, R40, R41, R42, R43, R44, R45, R46, R47, R48, R49, R50, R51, R52, R53, R54, R55, R56, R57, R58, R59, R60, R61: 10k; R_0603_HandSoldering
R32: 39k; R_0603_HandSoldering
U1, U2, U3, U4: MC74LVX244; TSSOP-20_4.4x6.5mm_Pitch0.65mm
U5: MAX7301; SSOP-63_7.5x15.9mm_Pitch0.635mm

Connections:
+3V3: C1.1, C2.1, J3.1, U1.20 (VCC), U2.20 (VCC), U3.20 (VCC), U4.20 (VCC), U5.36 (V+)
GND: C1.2, C2.2, J3.2, J4.1, J5.1, R1.2, R2.2, R3.2, R4.2, R5.2, R6.2, R7.2, R8.2, R9.2, R10.2, R11.2, R12.2, R13.2, R14.2, R15.2, R16.2, R17.2, R18.2, R19.2, R20.2, R21.2, R22.2, R23.2, R24.2, R25.2, R26.2, R27.2, R28.2, R29.2, R30.2, R31.2, R32.2, R33.2, R34.2, R35.2, R36.2, R37.2, R38.2, R39.2, R40.2, R41.2, R42.2, R43.2, R44.2, R45.2, R46.2, R47.2, R48.2, R49.2, R50.2, R51.2, R52.2, R53.2, R54.2, R55.2, R56.2, R57.2, R58.2, R59.2, R60.2, R61.2, U1.1 (~1OE~), U1.10 (GND), U1.19 (~2OE~), U2.1 (~1OE~), U2.10 (GND), U2.19 (~2OE~), U3.1 (~1OE~), U3.10 (GND), U3.19 (~2OE~), U4.1 (~1OE~), U4.3 (2O0), U4.5 (2O1), U4.7 (2O2), U4.9 (2O3), U4.10 (GND), U4.11 (2D3), U4.13 (2D2), U4.15 (2D1), U4.17 (2D0), U4.19 (~2OE~), U5.2 (GND), U5.3 (GND)
unnamed: J3.3, R33.1, U5.4 (DOUT)
unnamed: J3.4, R31.1, U5.34 (DIN)
unnamed: J3.5, R30.1, U5.33 (SCLK)
unnamed: J3.6, R29.1, U5.35 (CS(N))
unnamed: R32.1, U5.1 (ISET)
sig1: J1.1, R1.1, U1.17 (2D0)
sig2: J1.2, R2.1, U1.15 (2D1)
sig3: J1.3, R3.1, U1.13 (2D2)
sig4: J1.4, R4.1, U1.11 (2D3)
sig5: J1.5, R5.1, U2.17 (2D0)
sig6: J1.6, R6.1, U2.15 (2D1)
sig7: J1.7, R7.1, U2.13 (2D2)
sig8: J1.8, R8.1, U2.11 (2D3)
sig9: J1.9, R9.1, U3.17 (2D0)
sig10: J1.10, R10.1, U3.15 (2D1)
sig11: J1.11, R11.1, U3.13 (2D2)
sig12: J1.12, R12.1, U3.11 (2D3)
sig13: J1.13, R13.1, U4.2 (1D0)
sig14: J1.14, R14.1, U4.4 (1D1)
sig15: J2.1, R15.1, U1.2 (1D0)
sig16: J2.2, R16.1, U1.4 (1D1)
sig17: J2.3, R17.1, U1.6 (1D2)
sig18: J2.4, R18.1, U1.8 (1D3)
sig19: J2.5, R19.1, U2.2 (1D0)
sig20: J2.6, R20.1, U2.4 (1D1)
sig21: J2.7, R21.1, U2.6 (1D2)
sig22: J2.8, R22.1, U2.8 (1D3)
sig23: J2.9, R23.1, U3.2 (1D0)
sig24: J2.10, R24.1, U3.4 (1D1)
sig25: J2.11, R25.1, U3.6 (1D2)
sig26: J2.12, R26.1, U3.8 (1D3)
sig27: J2.13, R27.1, U4.6 (1D2)
sig28: J2.14, R28.1, U4.8 (1D3)
sig_1: R34.1, U1.3 (2O0), U5.32 (P4)
sig_2: R35.1, U1.5 (2O1), U5.30 (P5)
sig_3: R36.1, U1.7 (2O2), U5.28 (P6)
sig_4: R37.1, U1.9 (2O3), U5.26 (P7)
sig_5: R38.1, U2.3 (2O0), U5.5 (P8)
sig_6: R39.1, U2.5 (2O1), U5.7 (P9)
sig_7: R40.1, U2.7 (2O2), U5.9 (P10)
sig_8: R41.1, U2.9 (2O3), U5.11
sig_9: R42.1, U3.3 (2O0), U5.6 (P12)
sig_10: R43.1, U3.5 (2O1), U5.8 (P13)
sig_11: R44.1, U3.7 (2O2), U5.10 (P14)
sig_12: R45.1, U3.9 (2O3), U5.12 (P15)
sig_13: R46.1, U4.18 (1O0), U5.13 (P16)
sig_14: R47.1, U4.16 (1O1), U5.14 (P17)
sig_15: R48.1, U1.18 (1O0), U5.15 (P18)
sig_16: R49.1, U1.16 (1O1), U5.16 (P19)
sig_17: R50.1, U1.14 (1O2), U5.17 (P20)
sig_18: R51.1, U1.12 (1O3), U5.18 (P21)
sig_19: R52.1, U2.18 (1O0), U5.19 (P22)
sig_20: R53.1, U2.16 (1O1), U5.20 (P23)
sig_21: R54.1, U2.14 (1O2), U5.21 (P24)
sig_22: R55.1, U2.12 (1O3), U5.22 (P25)
sig_23: R56.1, U3.18 (1O0), U5.23 (P26)
sig_24: R57.1, U3.16 (1O1), U5.24 (P27)
sig_25: R58.1, U3.14 (1O2), U5.25 (P28)
sig_26: R59.1, U3.12 (1O3), U5.27 (P29)
sig_27: R60.1, U4.14 (1O2), U5.29 (P30)
sig_28: R61.1, U4.12 (1O3), U5.31

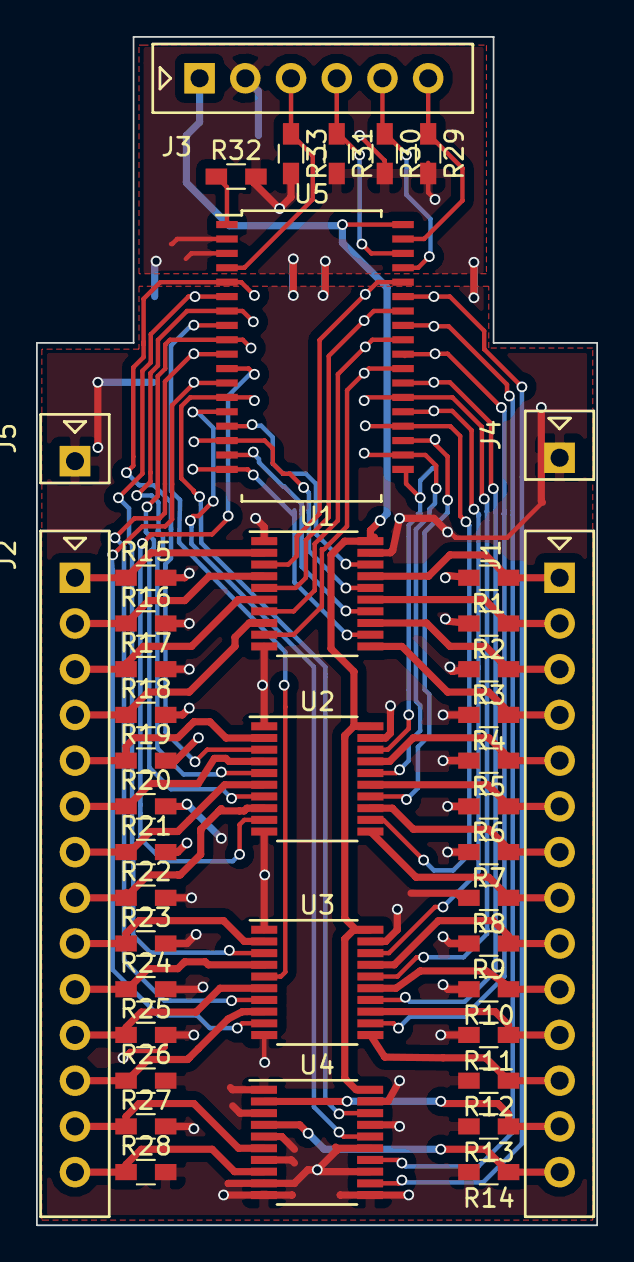
[picture p74: board PMOD DIGOUT/kicad files/PMOD.kicad_pcb from above]

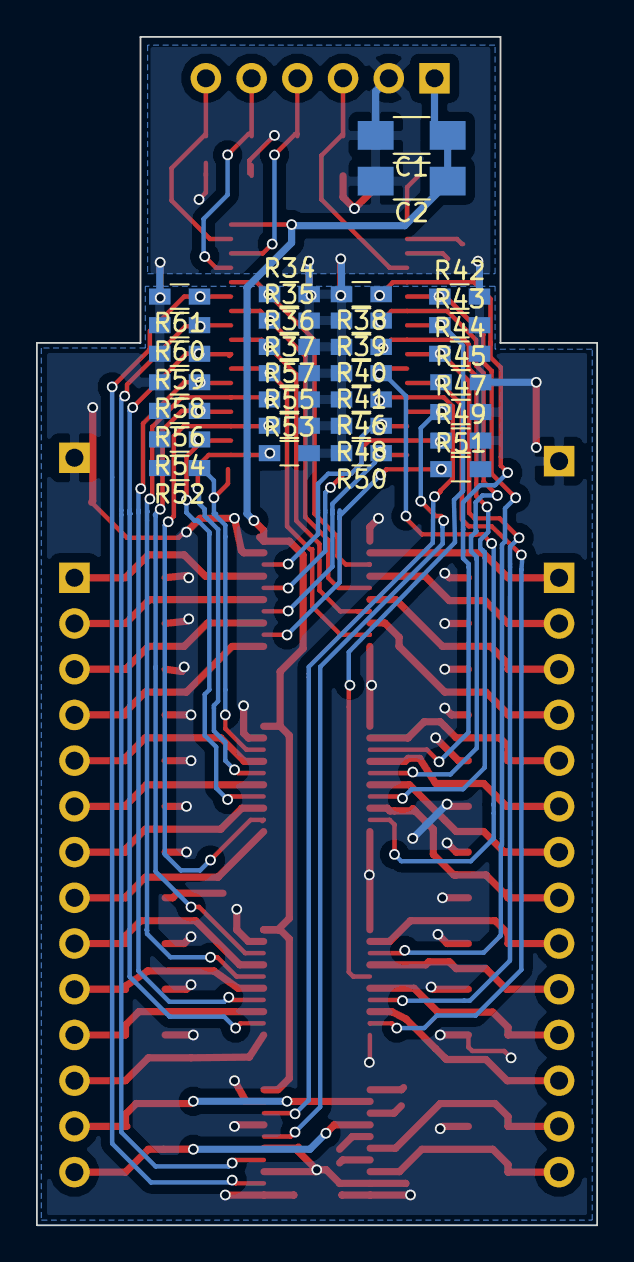
[picture p75: board PMOD DIGOUT/kicad files/PMOD.kicad_pcb from below]

Board: 2 copper layers, 31.1 x 66.0 mm, 73 parts (30 on the bottom side), 63 nets.
