KTH-EPE/HVDC_IED/ALEX/Vivado/src/trip_algorithm_axi/hdl/trip_algorithm_axi_v1_0_S00_AXI.vhd

-- ---------------------------------------------------------------------------
--
--    Project:	      Alex
--
--    Filename:       trip_algorithm_axi_S00_AXIS.vhd
--
--    Description:    Receives data and configuration parameters from PS
--                    via AXI Lite.   
--
--    © Copyright 2019 KTH. All rights reserved.
--
-- ---------------------------------------------------------------------------
library ieee;
use ieee.std_logic_1164.all;
use ieee.numeric_std.all;
use work.IED_config.all;

entity trip_algorithm_axi_v1_0_S00_AXI is
	generic (
		-- Users to add parameters here

		-- User parameters ends
		-- Do not modify the parameters beyond this line

		-- Width of S_AXI data bus
		C_S_AXI_DATA_WIDTH	: integer	:= 32;
		-- Width of S_AXI address bus
		C_S_AXI_ADDR_WIDTH	: integer	:= 8
	);
	port (
		-- Users to add ports here
    S_PS_TO_ALG_DCH_ARRAY       : inout ps_to_alg_dch_array; -- Array of data and configuration parameters from PS --vorher out Ilka

		-- User ports ends
		-- Do not modify the ports beyond this line

		-- Global Clock Signal
		S_AXI_ACLK	              : in std_logic;
		-- Global Reset Signal. This Signal is Active LOW
		S_AXI_ARESETN	            : in std_logic;
		-- Write address (issued by master, acceped by Slave)
		S_AXI_AWADDR	            : in std_logic_vector(C_S_AXI_ADDR_WIDTH-1 downto 0);
		-- Write channel Protection type. This signal indicates the
    		-- privilege and security level of the transaction, and whether
    		-- the transaction is a data access or an instruction access.
		S_AXI_AWPROT	            : in std_logic_vector(2 downto 0);
		-- Write address valid. This signal indicates that the master signaling
    		-- valid write address and control information.
		S_AXI_AWVALID	            : in std_logic;
		-- Write address ready. This signal indicates that the slave is ready
    		-- to accept an address and associated control signals.
		S_AXI_AWREADY	            : out std_logic;
		-- Write data (issued by master, acceped by Slave) 
		S_AXI_WDATA	              : in std_logic_vector(C_S_AXI_DATA_WIDTH-1 downto 0);
		-- Write strobes. This signal indicates which byte lanes hold
    		-- valid data. There is one write strobe bit for each eight
    		-- bits of the write data bus.    
		S_AXI_WSTRB	              : in std_logic_vector((C_S_AXI_DATA_WIDTH/8)-1 downto 0);
		-- Write valid. This signal indicates that valid write
    		-- data and strobes are available.
		S_AXI_WVALID	            : in std_logic;
		-- Write ready. This signal indicates that the slave
    		-- can accept the write data.
		S_AXI_WREADY	            : out std_logic;
		-- Write response. This signal indicates the status
    		-- of the write transaction.
		S_AXI_BRESP	              : out std_logic_vector(1 downto 0);
		-- Write response valid. This signal indicates that the channel
    		-- is signaling a valid write response.
		S_AXI_BVALID	            : out std_logic;
		-- Response ready. This signal indicates that the master
    		-- can accept a write response.
		S_AXI_BREADY	            : in std_logic;
		-- Read address (issued by master, acceped by Slave)
		S_AXI_ARADDR	            : in std_logic_vector(C_S_AXI_ADDR_WIDTH-1 downto 0);
		-- Protection type. This signal indicates the privilege
    		-- and security level of the transaction, and whether the
    		-- transaction is a data access or an instruction access.
		S_AXI_ARPROT	            : in std_logic_vector(2 downto 0);
		-- Read address valid. This signal indicates that the channel
    		-- is signaling valid read address and control information.
		S_AXI_ARVALID	            : in std_logic;
		-- Read address ready. This signal indicates that the slave is
    		-- ready to accept an address and associated control signals.
		S_AXI_ARREADY	            : out std_logic;
		-- Read data (issued by slave)
		S_AXI_RDATA	              : out std_logic_vector(C_S_AXI_DATA_WIDTH-1 downto 0);
		-- Read response. This signal indicates the status of the
    		-- read transfer.
		S_AXI_RRESP	              : out std_logic_vector(1 downto 0);
		-- Read valid. This signal indicates that the channel is
    		-- signaling the required read data.
		S_AXI_RVALID	            : out std_logic;
		-- Read ready. This signal indicates that the master can
    		-- accept the read data and response information.
		S_AXI_RREADY	            : in std_logic
	);
end trip_algorithm_axi_v1_0_S00_AXI;

architecture arch_imp of trip_algorithm_axi_v1_0_S00_AXI is

	-- AXI4LITE signals
	signal axi_awaddr	  : std_logic_vector(C_S_AXI_ADDR_WIDTH-1 downto 0);
	signal axi_awready	: std_logic;
	signal axi_wready	  : std_logic;
	signal axi_bresp	  : std_logic_vector(1 downto 0);
	signal axi_bvalid	  : std_logic;
	signal axi_araddr	  : std_logic_vector(C_S_AXI_ADDR_WIDTH-1 downto 0);
	signal axi_arready	: std_logic;
	signal axi_rdata	  : std_logic_vector(C_S_AXI_DATA_WIDTH-1 downto 0);
	signal axi_rresp	  : std_logic_vector(1 downto 0);
	signal axi_rvalid	  : std_logic;

	-- Example-specific design signals
	-- local parameter for addressing 32 bit / 64 bit C_S_AXI_DATA_WIDTH
	-- ADDR_LSB is used for addressing 32/64 bit registers/memories
	-- ADDR_LSB = 2 for 32 bits (n downto 2)
	-- ADDR_LSB = 3 for 64 bits (n downto 3)
	constant ADDR_LSB          : integer := (C_S_AXI_DATA_WIDTH/32)+ 1;
	constant OPT_MEM_ADDR_BITS : integer := 5;
	------------------------------------------------
	---- Signals for user logic register space example
	--------------------------------------------------
	---- Number of Slave Registers 64
	signal slv_reg0	:std_logic_vector(C_S_AXI_DATA_WIDTH-1 downto 0);
	signal slv_reg1	:std_logic_vector(C_S_AXI_DATA_WIDTH-1 downto 0);
	signal slv_reg2	:std_logic_vector(C_S_AXI_DATA_WIDTH-1 downto 0);
	signal slv_reg3	:std_logic_vector(C_S_AXI_DATA_WIDTH-1 downto 0);
	signal slv_reg4	:std_logic_vector(C_S_AXI_DATA_WIDTH-1 downto 0);
	signal slv_reg5	:std_logic_vector(C_S_AXI_DATA_WIDTH-1 downto 0);
	signal slv_reg6	:std_logic_vector(C_S_AXI_DATA_WIDTH-1 downto 0);
	signal slv_reg7	:std_logic_vector(C_S_AXI_DATA_WIDTH-1 downto 0);
	signal slv_reg8	:std_logic_vector(C_S_AXI_DATA_WIDTH-1 downto 0);
	signal slv_reg9	:std_logic_vector(C_S_AXI_DATA_WIDTH-1 downto 0);
	signal slv_reg10	:std_logic_vector(C_S_AXI_DATA_WIDTH-1 downto 0);
	signal slv_reg11	:std_logic_vector(C_S_AXI_DATA_WIDTH-1 downto 0);
	signal slv_reg12	:std_logic_vector(C_S_AXI_DATA_WIDTH-1 downto 0);
	signal slv_reg13	:std_logic_vector(C_S_AXI_DATA_WIDTH-1 downto 0);
	signal slv_reg14	:std_logic_vector(C_S_AXI_DATA_WIDTH-1 downto 0);
	signal slv_reg15	:std_logic_vector(C_S_AXI_DATA_WIDTH-1 downto 0);
	signal slv_reg16	:std_logic_vector(C_S_AXI_DATA_WIDTH-1 downto 0);
	signal slv_reg17	:std_logic_vector(C_S_AXI_DATA_WIDTH-1 downto 0);
	signal slv_reg18	:std_logic_vector(C_S_AXI_DATA_WIDTH-1 downto 0);
	signal slv_reg19	:std_logic_vector(C_S_AXI_DATA_WIDTH-1 downto 0);
	signal slv_reg20	:std_logic_vector(C_S_AXI_DATA_WIDTH-1 downto 0);
	signal slv_reg21	:std_logic_vector(C_S_AXI_DATA_WIDTH-1 downto 0);
	signal slv_reg22	:std_logic_vector(C_S_AXI_DATA_WIDTH-1 downto 0);
	signal slv_reg23	:std_logic_vector(C_S_AXI_DATA_WIDTH-1 downto 0);
	signal slv_reg24	:std_logic_vector(C_S_AXI_DATA_WIDTH-1 downto 0);
	signal slv_reg25	:std_logic_vector(C_S_AXI_DATA_WIDTH-1 downto 0);
	signal slv_reg26	:std_logic_vector(C_S_AXI_DATA_WIDTH-1 downto 0);
	signal slv_reg27	:std_logic_vector(C_S_AXI_DATA_WIDTH-1 downto 0);
	signal slv_reg28	:std_logic_vector(C_S_AXI_DATA_WIDTH-1 downto 0);
	signal slv_reg29	:std_logic_vector(C_S_AXI_DATA_WIDTH-1 downto 0);
	signal slv_reg30	:std_logic_vector(C_S_AXI_DATA_WIDTH-1 downto 0);
	signal slv_reg31	:std_logic_vector(C_S_AXI_DATA_WIDTH-1 downto 0);
	signal slv_reg32	:std_logic_vector(C_S_AXI_DATA_WIDTH-1 downto 0);
	signal slv_reg33	:std_logic_vector(C_S_AXI_DATA_WIDTH-1 downto 0);
	signal slv_reg34	:std_logic_vector(C_S_AXI_DATA_WIDTH-1 downto 0);
	signal slv_reg35	:std_logic_vector(C_S_AXI_DATA_WIDTH-1 downto 0);
	signal slv_reg36	:std_logic_vector(C_S_AXI_DATA_WIDTH-1 downto 0);
	signal slv_reg37	:std_logic_vector(C_S_AXI_DATA_WIDTH-1 downto 0);
	signal slv_reg38	:std_logic_vector(C_S_AXI_DATA_WIDTH-1 downto 0);
	signal slv_reg39	:std_logic_vector(C_S_AXI_DATA_WIDTH-1 downto 0);
	signal slv_reg40	:std_logic_vector(C_S_AXI_DATA_WIDTH-1 downto 0);
	signal slv_reg41	:std_logic_vector(C_S_AXI_DATA_WIDTH-1 downto 0);
	signal slv_reg42	:std_logic_vector(C_S_AXI_DATA_WIDTH-1 downto 0);
	signal slv_reg43	:std_logic_vector(C_S_AXI_DATA_WIDTH-1 downto 0);
	signal slv_reg44	:std_logic_vector(C_S_AXI_DATA_WIDTH-1 downto 0);
	signal slv_reg45	:std_logic_vector(C_S_AXI_DATA_WIDTH-1 downto 0);
	signal slv_reg46	:std_logic_vector(C_S_AXI_DATA_WIDTH-1 downto 0);
	signal slv_reg47	:std_logic_vector(C_S_AXI_DATA_WIDTH-1 downto 0);
	signal slv_reg48	:std_logic_vector(C_S_AXI_DATA_WIDTH-1 downto 0);
	signal slv_reg49	:std_logic_vector(C_S_AXI_DATA_WIDTH-1 downto 0);
	signal slv_reg50	:std_logic_vector(C_S_AXI_DATA_WIDTH-1 downto 0);
	signal slv_reg51	:std_logic_vector(C_S_AXI_DATA_WIDTH-1 downto 0);
	signal slv_reg52	:std_logic_vector(C_S_AXI_DATA_WIDTH-1 downto 0);
	signal slv_reg53	:std_logic_vector(C_S_AXI_DATA_WIDTH-1 downto 0);
	signal slv_reg54	:std_logic_vector(C_S_AXI_DATA_WIDTH-1 downto 0);
	signal slv_reg55	:std_logic_vector(C_S_AXI_DATA_WIDTH-1 downto 0);
	signal slv_reg56	:std_logic_vector(C_S_AXI_DATA_WIDTH-1 downto 0);
	signal slv_reg57	:std_logic_vector(C_S_AXI_DATA_WIDTH-1 downto 0);
	signal slv_reg58	:std_logic_vector(C_S_AXI_DATA_WIDTH-1 downto 0);
	signal slv_reg59	:std_logic_vector(C_S_AXI_DATA_WIDTH-1 downto 0);
	signal slv_reg60	:std_logic_vector(C_S_AXI_DATA_WIDTH-1 downto 0);
	signal slv_reg61	:std_logic_vector(C_S_AXI_DATA_WIDTH-1 downto 0);
	signal slv_reg62	:std_logic_vector(C_S_AXI_DATA_WIDTH-1 downto 0);
	signal slv_reg63	:std_logic_vector(C_S_AXI_DATA_WIDTH-1 downto 0);
	signal slv_reg_rden	: std_logic;
	signal slv_reg_wren	: std_logic;
	signal reg_data_out	:std_logic_vector(C_S_AXI_DATA_WIDTH-1 downto 0);
	signal byte_index	: integer;

begin
	-- I/O Connections assignments

	S_AXI_AWREADY	<= axi_awready;
	S_AXI_WREADY	<= axi_wready;
	S_AXI_BRESP	<= axi_bresp;
	S_AXI_BVALID	<= axi_bvalid;
	S_AXI_ARREADY	<= axi_arready;
	S_AXI_RDATA	<= axi_rdata;
	S_AXI_RRESP	<= axi_rresp;
	S_AXI_RVALID	<= axi_rvalid;
	-- Implement axi_awready generation
	-- axi_awready is asserted for one S_AXI_ACLK clock cycle when both
	-- S_AXI_AWVALID and S_AXI_WVALID are asserted. axi_awready is
	-- de-asserted when reset is low.

	process (S_AXI_ACLK)
	begin
	  if rising_edge(S_AXI_ACLK) then 
	    if S_AXI_ARESETN = '0' then
	      axi_awready <= '0';
	    else
	      if (axi_awready = '0' and S_AXI_AWVALID = '1' and S_AXI_WVALID = '1') then
	        -- slave is ready to accept write address when
	        -- there is a valid write address and write data
	        -- on the write address and data bus. This design 
	        -- expects no outstanding transactions. 
	        axi_awready <= '1';
	      else
	        axi_awready <= '0';
	      end if;
	    end if;
	  end if;
	end process;

	-- Implement axi_awaddr latching
	-- This process is used to latch the address when both 
	-- S_AXI_AWVALID and S_AXI_WVALID are valid. 

	process (S_AXI_ACLK)
	begin
	  if rising_edge(S_AXI_ACLK) then 
	    if S_AXI_ARESETN = '0' then
	      axi_awaddr <= (others => '0');
	    else
	      if (axi_awready = '0' and S_AXI_AWVALID = '1' and S_AXI_WVALID = '1') then
	        -- Write Address latching
	        axi_awaddr <= S_AXI_AWADDR;
	      end if;
	    end if;
	  end if;                   
	end process; 

	-- Implement axi_wready generation
	-- axi_wready is asserted for one S_AXI_ACLK clock cycle when both
	-- S_AXI_AWVALID and S_AXI_WVALID are asserted. axi_wready is 
	-- de-asserted when reset is low. 

	process (S_AXI_ACLK)
	begin
	  if rising_edge(S_AXI_ACLK) then 
	    if S_AXI_ARESETN = '0' then
	      axi_wready <= '0';
	    else
	      if (axi_wready = '0' and S_AXI_WVALID = '1' and S_AXI_AWVALID = '1') then
	          -- slave is ready to accept write data when 
	          -- there is a valid write address and write data
	          -- on the write address and data bus. This design 
	          -- expects no outstanding transactions.           
	          axi_wready <= '1';
	      else
	        axi_wready <= '0';
	      end if;
	    end if;
	  end if;
	end process; 

	-- Implement memory mapped register select and write logic generation
	-- The write data is accepted and written to memory mapped registers when
	-- axi_awready, S_AXI_WVALID, axi_wready and S_AXI_WVALID are asserted. Write strobes are used to
	-- select byte enables of slave registers while writing.
	-- These registers are cleared when reset (active low) is applied.
	-- Slave register write enable is asserted when valid address and data are available
	-- and the slave is ready to accept the write address and write data.
	slv_reg_wren <= axi_wready and S_AXI_WVALID and axi_awready and S_AXI_AWVALID ;

	process (S_AXI_ACLK)
	variable loc_addr :std_logic_vector(OPT_MEM_ADDR_BITS downto 0); 
	begin
	  if rising_edge(S_AXI_ACLK) then 
	    if S_AXI_ARESETN = '0' then
	      slv_reg0 <= (others => '0');
	      slv_reg1 <= (others => '0');
	      slv_reg2 <= (others => '0');
	      slv_reg3 <= (others => '0');
	      slv_reg4 <= (others => '0');
	      slv_reg5 <= (others => '0');
	      slv_reg6 <= (others => '0');
	      slv_reg7 <= (others => '0');
	      slv_reg8 <= (others => '0');
	      slv_reg9 <= (others => '0');
	      slv_reg10 <= (others => '0');
	      slv_reg11 <= (others => '0');
	      slv_reg12 <= (others => '0');
	      slv_reg13 <= (others => '0');
	      slv_reg14 <= (others => '0');
	      slv_reg15 <= (others => '0');
	      slv_reg16 <= (others => '0');
	      slv_reg17 <= (others => '0');
	      slv_reg18 <= (others => '0');
	      slv_reg19 <= (others => '0');
	      slv_reg20 <= (others => '0');
	      slv_reg21 <= (others => '0');
	      slv_reg22 <= (others => '0');
	      slv_reg23 <= (others => '0');
	      slv_reg24 <= (others => '0');
	      slv_reg25 <= (others => '0');
	      slv_reg26 <= (others => '0');
	      slv_reg27 <= (others => '0');
	      slv_reg28 <= (others => '0');
	      slv_reg29 <= (others => '0');
	      slv_reg30 <= (others => '0');
	      slv_reg31 <= (others => '0');
	      slv_reg32 <= (others => '0');
	      slv_reg33 <= (others => '0');
	      slv_reg34 <= (others => '0');
	      slv_reg35 <= (others => '0');
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
	            slv_reg31 <= slv_reg31;
	            slv_reg32 <= slv_reg32;
	            slv_reg33 <= slv_reg33;
	            slv_reg34 <= slv_reg34;
	            slv_reg35 <= slv_reg35;
	            slv_reg36 <= slv_reg36;
	            slv_reg37 <= slv_reg37;
	            slv_reg38 <= slv_reg38;
	            slv_reg39 <= slv_reg39;
	            slv_reg40 <= slv_reg40;
	            slv_reg41 <= slv_reg41;
	            slv_reg42 <= slv_reg42;
	            slv_reg43 <= slv_reg43;
	            slv_reg44 <= slv_reg44;
	            slv_reg45 <= slv_reg45;
	            slv_reg46 <= slv_reg46;
	            slv_reg47 <= slv_reg47;
	            slv_reg48 <= slv_reg48;
	            slv_reg49 <= slv_reg49;
	            slv_reg50 <= slv_reg50;
	            slv_reg51 <= slv_reg51;
	            slv_reg52 <= slv_reg52;
	            slv_reg53 <= slv_reg53;
	            slv_reg54 <= slv_reg54;
	            slv_reg55 <= slv_reg55;
	            slv_reg56 <= slv_reg56;
	            slv_reg57 <= slv_reg57;
	            slv_reg58 <= slv_reg58;
	            slv_reg59 <= slv_reg59;
	            slv_reg60 <= slv_reg60;
	            slv_reg61 <= slv_reg61;
	            slv_reg62 <= slv_reg62;
	            slv_reg63 <= slv_reg63;
	        end case;
	      end if;
	    end if;
	  end if;                   
	end process; 

	-- Implement write response logic generation
	-- The write response and response valid signals are asserted by the slave 
	-- when axi_wready, S_AXI_WVALID, axi_wready and S_AXI_WVALID are asserted.  
	-- This marks the acceptance of address and indicates the status of 
	-- write transaction.

	process (S_AXI_ACLK)
	begin
	  if rising_edge(S_AXI_ACLK) then 
	    if S_AXI_ARESETN = '0' then
	      axi_bvalid  <= '0';
	      axi_bresp   <= "00"; --need to work more on the responses
	    else
	      if (axi_awready = '1' and S_AXI_AWVALID = '1' and axi_wready = '1' and S_AXI_WVALID = '1' and axi_bvalid = '0'  ) then
	        axi_bvalid <= '1';
	        axi_bresp  <= "00"; 
	      elsif (S_AXI_BREADY = '1' and axi_bvalid = '1') then   --check if bready is asserted while bvalid is high)
	        axi_bvalid <= '0';                                 -- (there is a possibility that bready is always asserted high)
	      end if;
	    end if;
	  end if;                   
	end process; 

	-- Implement axi_arready generation
	-- axi_arready is asserted for one S_AXI_ACLK clock cycle when
	-- S_AXI_ARVALID is asserted. axi_awready is 
	-- de-asserted when reset (active low) is asserted. 
	-- The read address is also latched when S_AXI_ARVALID is 
	-- asserted. axi_araddr is reset to zero on reset assertion.

	process (S_AXI_ACLK)
	begin
	  if rising_edge(S_AXI_ACLK) then 
	    if S_AXI_ARESETN = '0' then
	      axi_arready <= '0';
	      axi_araddr  <= (others => '1');
	    else
	      if (axi_arready = '0' and S_AXI_ARVALID = '1') then
	        -- indicates that the slave has acceped the valid read address
	        axi_arready <= '1';
	        -- Read Address latching 
	        axi_araddr  <= S_AXI_ARADDR;           
	      else
	        axi_arready <= '0';
	      end if;
	    end if;
	  end if;                   
	end process; 

	-- Implement axi_arvalid generation
	-- axi_rvalid is asserted for one S_AXI_ACLK clock cycle when both 
	-- S_AXI_ARVALID and axi_arready are asserted. The slave registers 
	-- data are available on the axi_rdata bus at this instance. The 
	-- assertion of axi_rvalid marks the validity of read data on the 
	-- bus and axi_rresp indicates the status of read transaction.axi_rvalid 
	-- is deasserted on reset (active low). axi_rresp and axi_rdata are 
	-- cleared to zero on reset (active low).  
	process (S_AXI_ACLK)
	begin
	  if rising_edge(S_AXI_ACLK) then
	    if S_AXI_ARESETN = '0' then
	      axi_rvalid <= '0';
	      axi_rresp  <= "00";
	    else
	      if (axi_arready = '1' and S_AXI_ARVALID = '1' and axi_rvalid = '0') then
	        -- Valid read data is available at the read data bus
	        axi_rvalid <= '1';
	        axi_rresp  <= "00"; -- 'OKAY' response
	      elsif (axi_rvalid = '1' and S_AXI_RREADY = '1') then
	        -- Read data is accepted by the master
	        axi_rvalid <= '0';
	      end if;            
	    end if;
	  end if;
	end process;

	-- Implement memory mapped register select and read logic generation
	-- Slave register read enable is asserted when valid address is available
	-- and the slave is ready to accept the read address.
	slv_reg_rden <= axi_arready and S_AXI_ARVALID and (not axi_rvalid) ;

	process (slv_reg0, slv_reg1, slv_reg2, slv_reg3, slv_reg4, slv_reg5, slv_reg6, slv_reg7, slv_reg8, slv_reg9, slv_reg10, slv_reg11, slv_reg12, slv_reg13, slv_reg14, slv_reg15, slv_reg16, slv_reg17, slv_reg18, slv_reg19, slv_reg20, slv_reg21, slv_reg22, slv_reg23, slv_reg24, slv_reg25, slv_reg26, slv_reg27, slv_reg28, slv_reg29, slv_reg30, slv_reg31, slv_reg32, slv_reg33, slv_reg34, slv_reg35, slv_reg36, slv_reg37, slv_reg38, slv_reg39, slv_reg40, slv_reg41, slv_reg42, slv_reg43, slv_reg44, slv_reg45, slv_reg46, slv_reg47, slv_reg48, slv_reg49, slv_reg50, slv_reg51, slv_reg52, slv_reg53, slv_reg54, slv_reg55, slv_reg56, slv_reg57, slv_reg58, slv_reg59, slv_reg60, slv_reg61, slv_reg62, slv_reg63, axi_araddr, S_AXI_ARESETN, slv_reg_rden)
	variable loc_addr :std_logic_vector(OPT_MEM_ADDR_BITS downto 0);
	begin
	    -- Address decoding for reading registers
	    loc_addr := axi_araddr(ADDR_LSB + OPT_MEM_ADDR_BITS downto ADDR_LSB);
	    case loc_addr is
	      when b"000000" =>
	        reg_data_out <= slv_reg0;
	      when b"000001" =>
	        reg_data_out <= slv_reg1;
	      when b"000010" =>
	        reg_data_out <= slv_reg2;
	      when b"000011" =>
	        reg_data_out <= slv_reg3;
	      when b"000100" =>
	        reg_data_out <= slv_reg4;
	      when b"000101" =>
	        reg_data_out <= slv_reg5;
	      when b"000110" =>
	        reg_data_out <= slv_reg6;
	      when b"000111" =>
	        reg_data_out <= slv_reg7;
	      when b"001000" =>
	        reg_data_out <= slv_reg8;
	      when b"001001" =>
	        reg_data_out <= slv_reg9;
	      when b"001010" =>
	        reg_data_out <= slv_reg10;
	      when b"001011" =>
	        reg_data_out <= slv_reg11;
	      when b"001100" =>
	        reg_data_out <= slv_reg12;
	      when b"001101" =>
	        reg_data_out <= slv_reg13;
	      when b"001110" =>
	        reg_data_out <= slv_reg14;
	      when b"001111" =>
	        reg_data_out <= slv_reg15;
	      when b"010000" =>
	        reg_data_out <= slv_reg16;
	      when b"010001" =>
	        reg_data_out <= slv_reg17;
	      when b"010010" =>
	        reg_data_out <= slv_reg18;
	      when b"010011" =>
	        reg_data_out <= slv_reg19;
	      when b"010100" =>
	        reg_data_out <= slv_reg20;
	      when b"010101" =>
	        reg_data_out <= slv_reg21;
	      when b"010110" =>
	        reg_data_out <= slv_reg22;
	      when b"010111" =>
	        reg_data_out <= slv_reg23;
	      when b"011000" =>
	        reg_data_out <= slv_reg24;
	      when b"011001" =>
	        reg_data_out <= slv_reg25;
	      when b"011010" =>
	        reg_data_out <= slv_reg26;
	      when b"011011" =>
	        reg_data_out <= slv_reg27;
	      when b"011100" =>
	        reg_data_out <= slv_reg28;
	      when b"011101" =>
	        reg_data_out <= slv_reg29;
	      when b"011110" =>
	        reg_data_out <= slv_reg30;
	      when b"011111" =>
	        reg_data_out <= slv_reg31;
	      when b"100000" =>
	        reg_data_out <= slv_reg32;
	      when b"100001" =>
	        reg_data_out <= slv_reg33;
	      when b"100010" =>
	        reg_data_out <= slv_reg34;
	      when b"100011" =>
	        reg_data_out <= slv_reg35;
	      when b"100100" =>
	        reg_data_out <= slv_reg36;
	      when b"100101" =>
	        reg_data_out <= slv_reg37;
	      when b"100110" =>
	        reg_data_out <= slv_reg38;
	      when b"100111" =>
	        reg_data_out <= slv_reg39;
	      when b"101000" =>
	        reg_data_out <= slv_reg40;
	      when b"101001" =>
	        reg_data_out <= slv_reg41;
	      when b"101010" =>
	        reg_data_out <= slv_reg42;
	      when b"101011" =>
	        reg_data_out <= slv_reg43;
	      when b"101100" =>
	        reg_data_out <= slv_reg44;
	      when b"101101" =>
	        reg_data_out <= slv_reg45;
	      when b"101110" =>
	        reg_data_out <= slv_reg46;
	      when b"101111" =>
	        reg_data_out <= slv_reg47;
	      when b"110000" =>
	        reg_data_out <= slv_reg48;
	      when b"110001" =>
	        reg_data_out <= slv_reg49;
	      when b"110010" =>
	        reg_data_out <= slv_reg50;
	      when b"110011" =>
	        reg_data_out <= slv_reg51;
	      when b"110100" =>
	        reg_data_out <= slv_reg52;
	      when b"110101" =>
	        reg_data_out <= slv_reg53;
	      when b"110110" =>
	        reg_data_out <= slv_reg54;
	      when b"110111" =>
	        reg_data_out <= slv_reg55;
	      when b"111000" =>
	        reg_data_out <= slv_reg56;
	      when b"111001" =>
	        reg_data_out <= slv_reg57;
	      when b"111010" =>
	        reg_data_out <= slv_reg58;
	      when b"111011" =>
	        reg_data_out <= slv_reg59;
	      when b"111100" =>
	        reg_data_out <= slv_reg60;
	      when b"111101" =>
	        reg_data_out <= slv_reg61;
	      when b"111110" =>
	        reg_data_out <= slv_reg62;
	      when b"111111" =>
	        reg_data_out <= slv_reg63;
	      when others =>
	        reg_data_out  <= (others => '0');
	    end case;
	end process; 

	-- Output register or memory read data
	process( S_AXI_ACLK ) is
	begin
	  if (rising_edge (S_AXI_ACLK)) then
	    if ( S_AXI_ARESETN = '0' ) then
	      axi_rdata  <= (others => '0');
	    else
	      if (slv_reg_rden = '1') then
	        -- When there is a valid read address (S_AXI_ARVALID) with 
	        -- acceptance of read address by the slave (axi_arready), 
	        -- output the read dada 
	        -- Read address mux
	          axi_rdata <= reg_data_out;     -- register read data
	      end if;   
	    end if;
	  end if;
	end process;


	-- Add user logic here
  
	process (S_AXI_ACLK)
    begin
      if rising_edge(S_AXI_ACLK) then 
        if S_AXI_ARESETN = '0' then
          S_PS_TO_ALG_DCH_ARRAY <= (others => (others => '0'));        
        else
	        S_PS_TO_ALG_DCH_ARRAY(0) <= slv_reg0;
          S_PS_TO_ALG_DCH_ARRAY(1) <= slv_reg1;
	        S_PS_TO_ALG_DCH_ARRAY(2) <= slv_reg2;
	        S_PS_TO_ALG_DCH_ARRAY(3) <= slv_reg3;
	        S_PS_TO_ALG_DCH_ARRAY(4) <= slv_reg4;
	        S_PS_TO_ALG_DCH_ARRAY(5) <= slv_reg5;
	        S_PS_TO_ALG_DCH_ARRAY(6) <= slv_reg6;
	        S_PS_TO_ALG_DCH_ARRAY(7) <= slv_reg7;
	        S_PS_TO_ALG_DCH_ARRAY(8) <= slv_reg8;
	        S_PS_TO_ALG_DCH_ARRAY(9) <= slv_reg9;
	        S_PS_TO_ALG_DCH_ARRAY(10) <= slv_reg10;
	        S_PS_TO_ALG_DCH_ARRAY(11) <= slv_reg11;
	        S_PS_TO_ALG_DCH_ARRAY(12) <= slv_reg12;
	        S_PS_TO_ALG_DCH_ARRAY(13) <= slv_reg13;
	        S_PS_TO_ALG_DCH_ARRAY(14) <= slv_reg14;
	        S_PS_TO_ALG_DCH_ARRAY(15) <= slv_reg15;
	        S_PS_TO_ALG_DCH_ARRAY(16) <= slv_reg16;
	        S_PS_TO_ALG_DCH_ARRAY(17) <= slv_reg17;
	        S_PS_TO_ALG_DCH_ARRAY(18) <= slv_reg18;
	        S_PS_TO_ALG_DCH_ARRAY(19) <= slv_reg19;
	        S_PS_TO_ALG_DCH_ARRAY(20) <= slv_reg20;
	        S_PS_TO_ALG_DCH_ARRAY(21) <= slv_reg21;
	        S_PS_TO_ALG_DCH_ARRAY(22) <= slv_reg22;
	        S_PS_TO_ALG_DCH_ARRAY(23) <= slv_reg23;
	        S_PS_TO_ALG_DCH_ARRAY(24) <= slv_reg24;
	        S_PS_TO_ALG_DCH_ARRAY(25) <= slv_reg25;
	        S_PS_TO_ALG_DCH_ARRAY(26) <= slv_reg26;
	        S_PS_TO_ALG_DCH_ARRAY(27) <= slv_reg27;
	        S_PS_TO_ALG_DCH_ARRAY(28) <= slv_reg28;
	        S_PS_TO_ALG_DCH_ARRAY(29) <= slv_reg29;
	        S_PS_TO_ALG_DCH_ARRAY(30) <= slv_reg30;
	        S_PS_TO_ALG_DCH_ARRAY(31) <= slv_reg31;
	        S_PS_TO_ALG_DCH_ARRAY(32) <= slv_reg32;
	        S_PS_TO_ALG_DCH_ARRAY(33) <= slv_reg33;
	        S_PS_TO_ALG_DCH_ARRAY(34) <= slv_reg34;
	        S_PS_TO_ALG_DCH_ARRAY(35) <= slv_reg35;
	        S_PS_TO_ALG_DCH_ARRAY(36) <= slv_reg36;
	        S_PS_TO_ALG_DCH_ARRAY(37) <= slv_reg37;
	        S_PS_TO_ALG_DCH_ARRAY(38) <= slv_reg38;
	        S_PS_TO_ALG_DCH_ARRAY(39) <= slv_reg39;
	        S_PS_TO_ALG_DCH_ARRAY(40) <= slv_reg40;
	        S_PS_TO_ALG_DCH_ARRAY(41) <= slv_reg41;
	        S_PS_TO_ALG_DCH_ARRAY(42) <= slv_reg42;
	        S_PS_TO_ALG_DCH_ARRAY(43) <= slv_reg43;
	        S_PS_TO_ALG_DCH_ARRAY(44) <= slv_reg44;
	        S_PS_TO_ALG_DCH_ARRAY(45) <= slv_reg45;
	        S_PS_TO_ALG_DCH_ARRAY(46) <= slv_reg46;
	        S_PS_TO_ALG_DCH_ARRAY(47) <= slv_reg47;
	        S_PS_TO_ALG_DCH_ARRAY(48) <= slv_reg48;
	        S_PS_TO_ALG_DCH_ARRAY(49) <= slv_reg49;
	        S_PS_TO_ALG_DCH_ARRAY(50) <= slv_reg50;
	        S_PS_TO_ALG_DCH_ARRAY(51) <= slv_reg51;
	        S_PS_TO_ALG_DCH_ARRAY(52) <= slv_reg52;
	        S_PS_TO_ALG_DCH_ARRAY(53) <= slv_reg53;
	        S_PS_TO_ALG_DCH_ARRAY(54) <= slv_reg54;
	        S_PS_TO_ALG_DCH_ARRAY(55) <= slv_reg55;
	        S_PS_TO_ALG_DCH_ARRAY(56) <= slv_reg56;
	        S_PS_TO_ALG_DCH_ARRAY(57) <= slv_reg57;
	        S_PS_TO_ALG_DCH_ARRAY(58) <= slv_reg58;
	        S_PS_TO_ALG_DCH_ARRAY(59) <= slv_reg59;
	        S_PS_TO_ALG_DCH_ARRAY(60) <= slv_reg60;
	        S_PS_TO_ALG_DCH_ARRAY(61) <= slv_reg61;
	        S_PS_TO_ALG_DCH_ARRAY(62) <= slv_reg62;
	        S_PS_TO_ALG_DCH_ARRAY(63) <= slv_reg63;

        end if;
      end if;
    end process; 
  

	-- User logic ends

end arch_imp;
