KTH-EPE/HVDC_IED/(commit log)

2020-02-10 Added the initial draft for IED assembling manual
2020-02-10 image upload
    [Components.xlsx]
2020-02-18 updated pictures for ADC, usb plugged in right port
2020-02-18 picture for LED connections
2020-02-26 change order of sections. power supply wiring after box is assembled
